Nhercar/adaptation-microduck-replica/replica-repo/assets/cad-solidworks-装配体.png

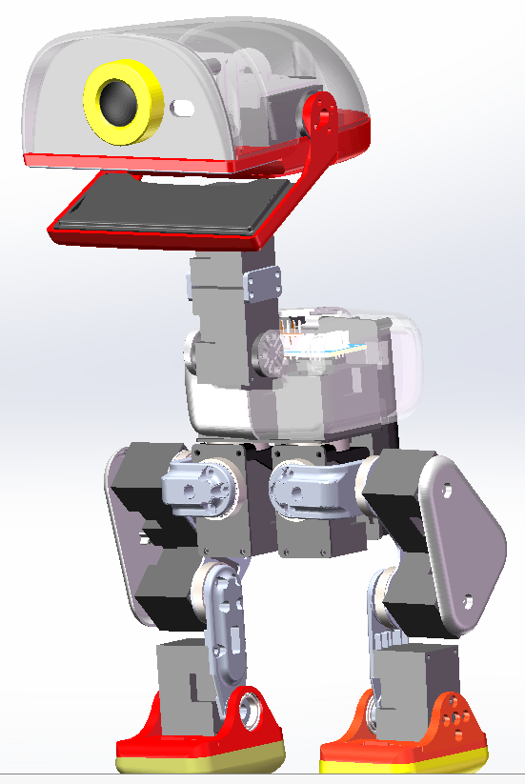
replica-repo/assets/cad-solidworks-装配体.png
