Nhercar/adaptation-microduck-replica/replica-repo/build-log/photos/2026-09-13-飞特版装机-手持.jpg

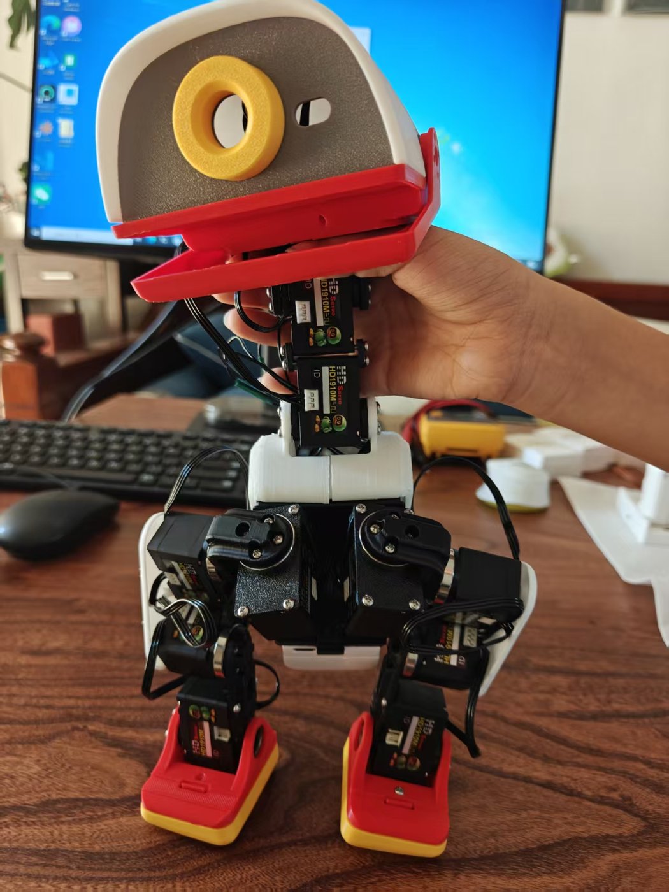
replica-repo/build-log/photos/2026-09-13-飞特版装机-手持.jpg
