Nhercar/adaptation-microduck-replica/replica-repo/assets/hw/Microduck硬件图集.pdf

M I C R O D U C K 复刻 · 电控

# Microduck硬件图集

五个模块、两块自制板、一条总线。所有引脚、地址与寄存器均取自官方开源硬

件工程与运行时源码，未经实物验证。

舵机总线 · 半双工 TTL 1 Mbps | +BATT 6.6–8.2 V | +5V / +3V3 | I²C · 400 kHz | MIPI CSI | I²S 音频

总线设备

16

15 舵机 ＋ 1 块 IMU 板

控制周期

20 ms

50 Hz，一读一写

自制板

2

HAT 已开源 ／ IMU 板要自绘

策略网络

775 KiB

×9 个 ONNX

## 01 东西装在哪

最容易搞错的一条：主控不在躯干，在头里。摄像头、主控板、HAT 三者同属 MJCF 里 的 jaw_soft 刚体，摄像头距主控板中心约 13 mm，中间没有任何关节。 躯干内腔基

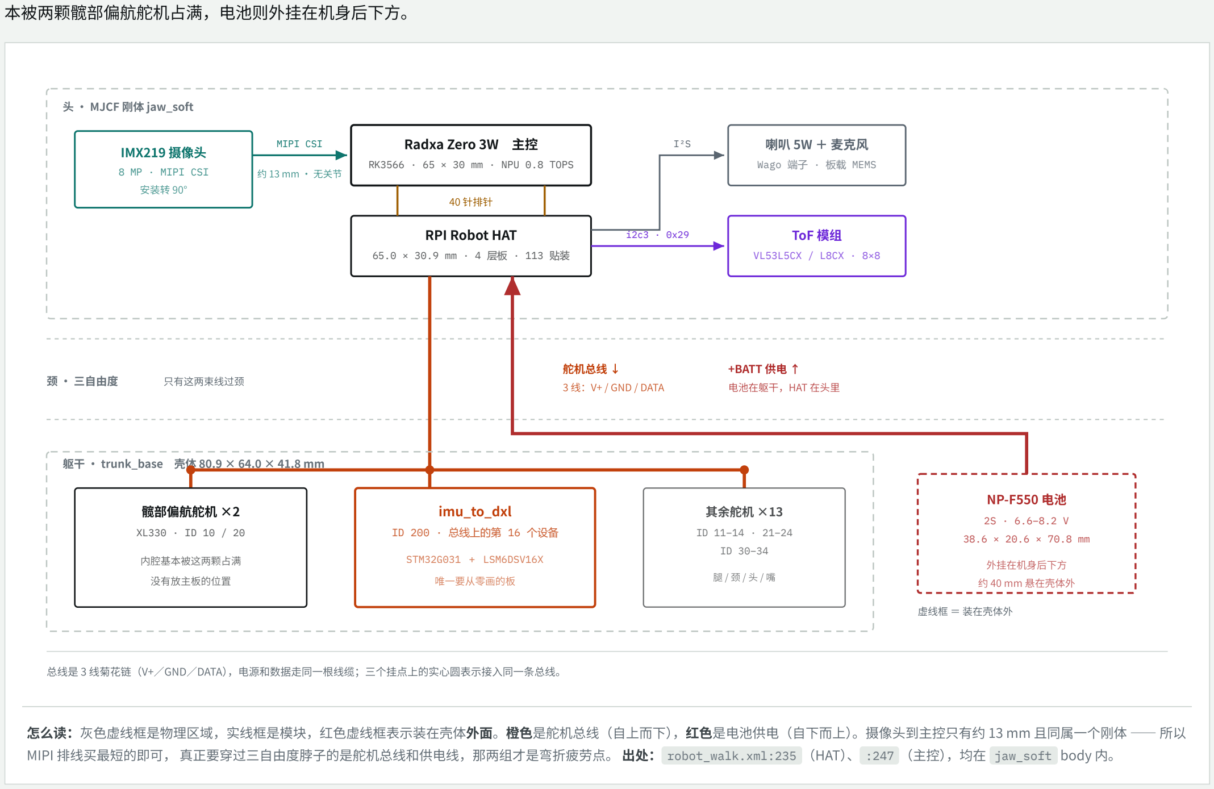
[picture p3: figure]
本被两颗髋部偏航舵机占满，电池则外挂在机身后下方。; 头 · MJCF 刚体 jaw_soft; IMX219 摄像头 8 MP · MIPI CSI; 安装转 90°; Radxa Zero 3W 主控; RK3566 · 65 × 30 mm · NPU 0.8 TOPS; RPI Robot HAT; 40 针排针; MIPI CSI; 约 13 mm · 无关节; ToF 模组; 喇叭 5W ＋ 麦克风; Wago 端子 · 板载 MEMS; I²S; 颈 · 三自由度; 舵机总线 ↓; 3 线：V+ / GND / DATA; +BATT 供电 ↑; 电池在躯干，HAT 在头里; 只有这两束线过颈; 髋部偏航舵机 ×2; 内腔基本被这两颗占满; 没有放主板的位置; imu_to_dxl; ID 200 · 总线上的第 16 个设备; STM32G031 ＋ LSM6DSV16X; 唯一要从零画的板; 其余舵机 ×13; 外挂在机身后下方; 约 40 mm 悬在壳体外; 虚线框 ＝ 装在壳体外; 总线是 3 线菊花链（V+／GND／DATA），电源和数据走同一根线缆；三个挂点上的实心圆表示接入同一条总线。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

躯干 · trunk_base 壳体 80.9 × 64.0 × 41.8 mm

MIPI 排线买最短的即可， 真正要穿过三自由度脖子的是舵机总线和供电线，那两组才是弯折疲劳点。 出处： robot_walk.xml:235 （HAT）、 :247 （主控），均在 jaw_soft body 内。

买之前先看这条

因为主控在头里、槽位只有 65 × 30 mm，任何更大的板子都塞不进去—— 立创泰

山派是 70 × 45 mm，同为 RK3566 但装不下，上面还压着一块 HAT。

## 02 电池两路走，舵机吃原压

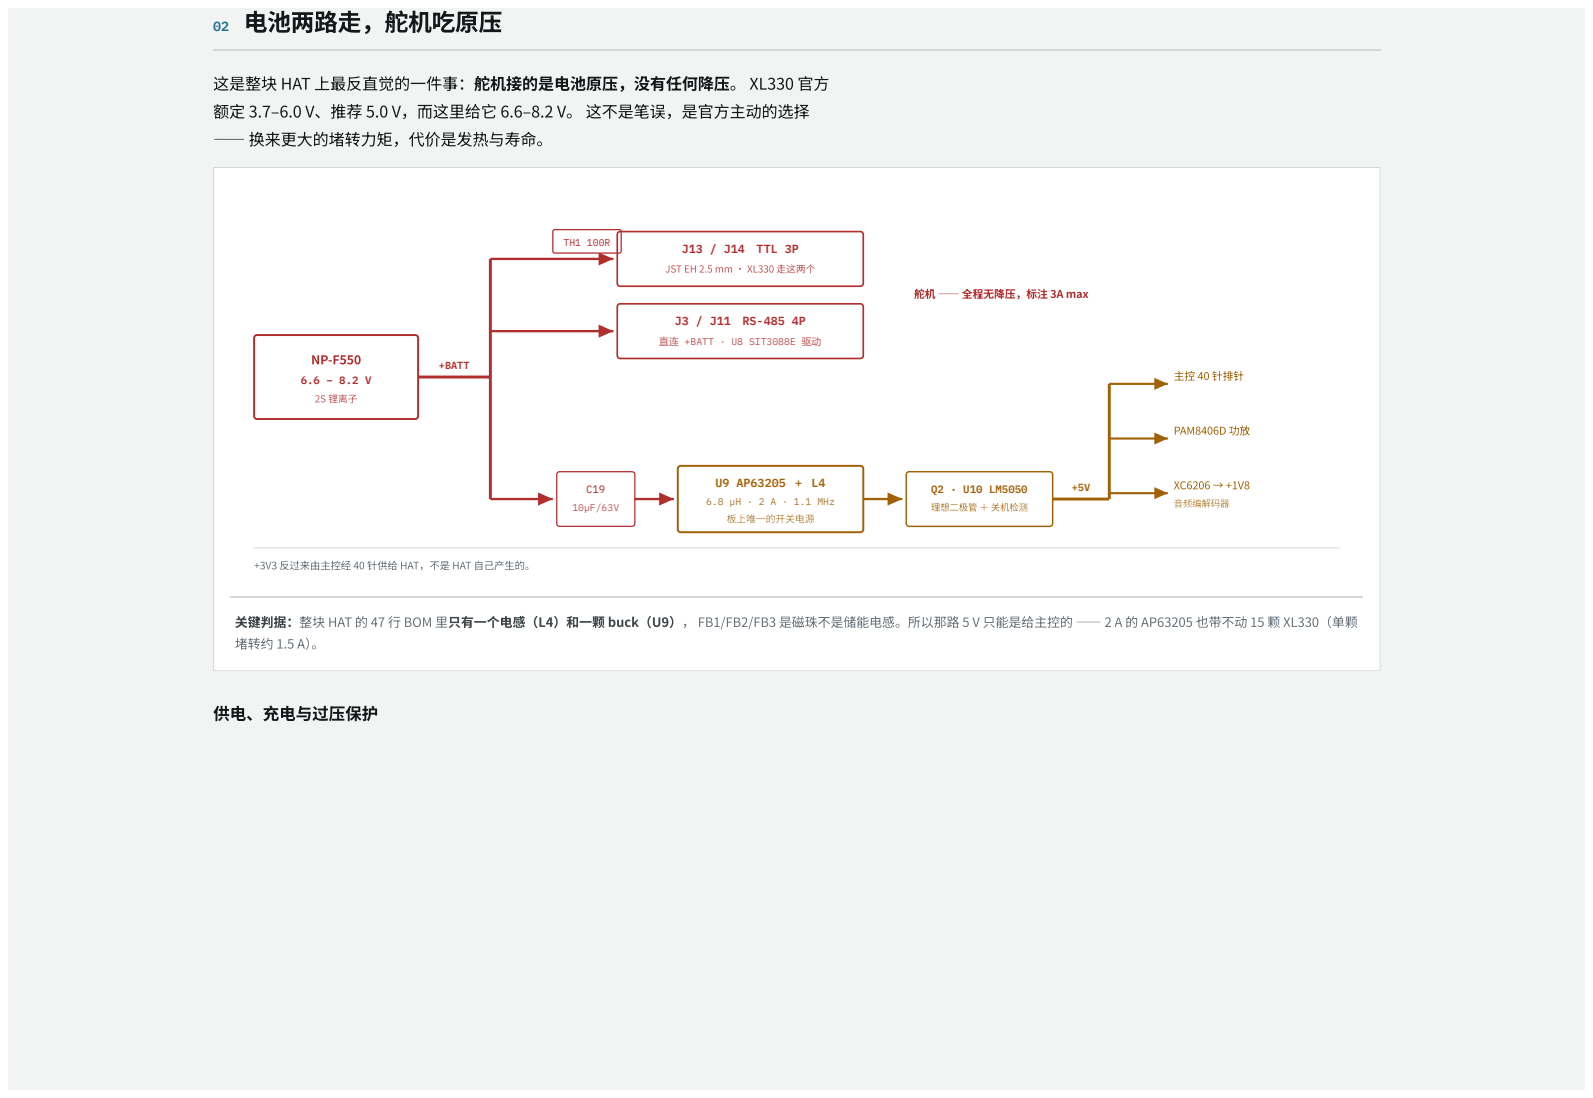
[picture p4: page 3]

这是整块 HAT 上最反直觉的一件事：舵机接的是电池原压，没有任何降压。 XL330 官方
额定 3.7–6.0 V、推荐 5.0 V，而这里给它 6.6–8.2 V。 这不是笔误，是官方主动的选择
—— 换来更大的堵转力矩，代价是发热与寿命。

JST EH 2.5 mm · XL330 走这两个

舵机——全程无降压，标注 3A max

+3V3 反过来由主控经 40 针供给 HAT，不是 HAT 自己产生的。

关键判据：整块 HAT 的 47 行 BOM 里只有一个电感（L4）和一颗 buck（U9）， FB1/FB2/FB3 是磁珠不是储能电感。所以那路 5 V 只能是给主控的—— 2 A 的 AP63205 也带不动 15 颗 XL330（单颗
堵转约 1.5 A）。

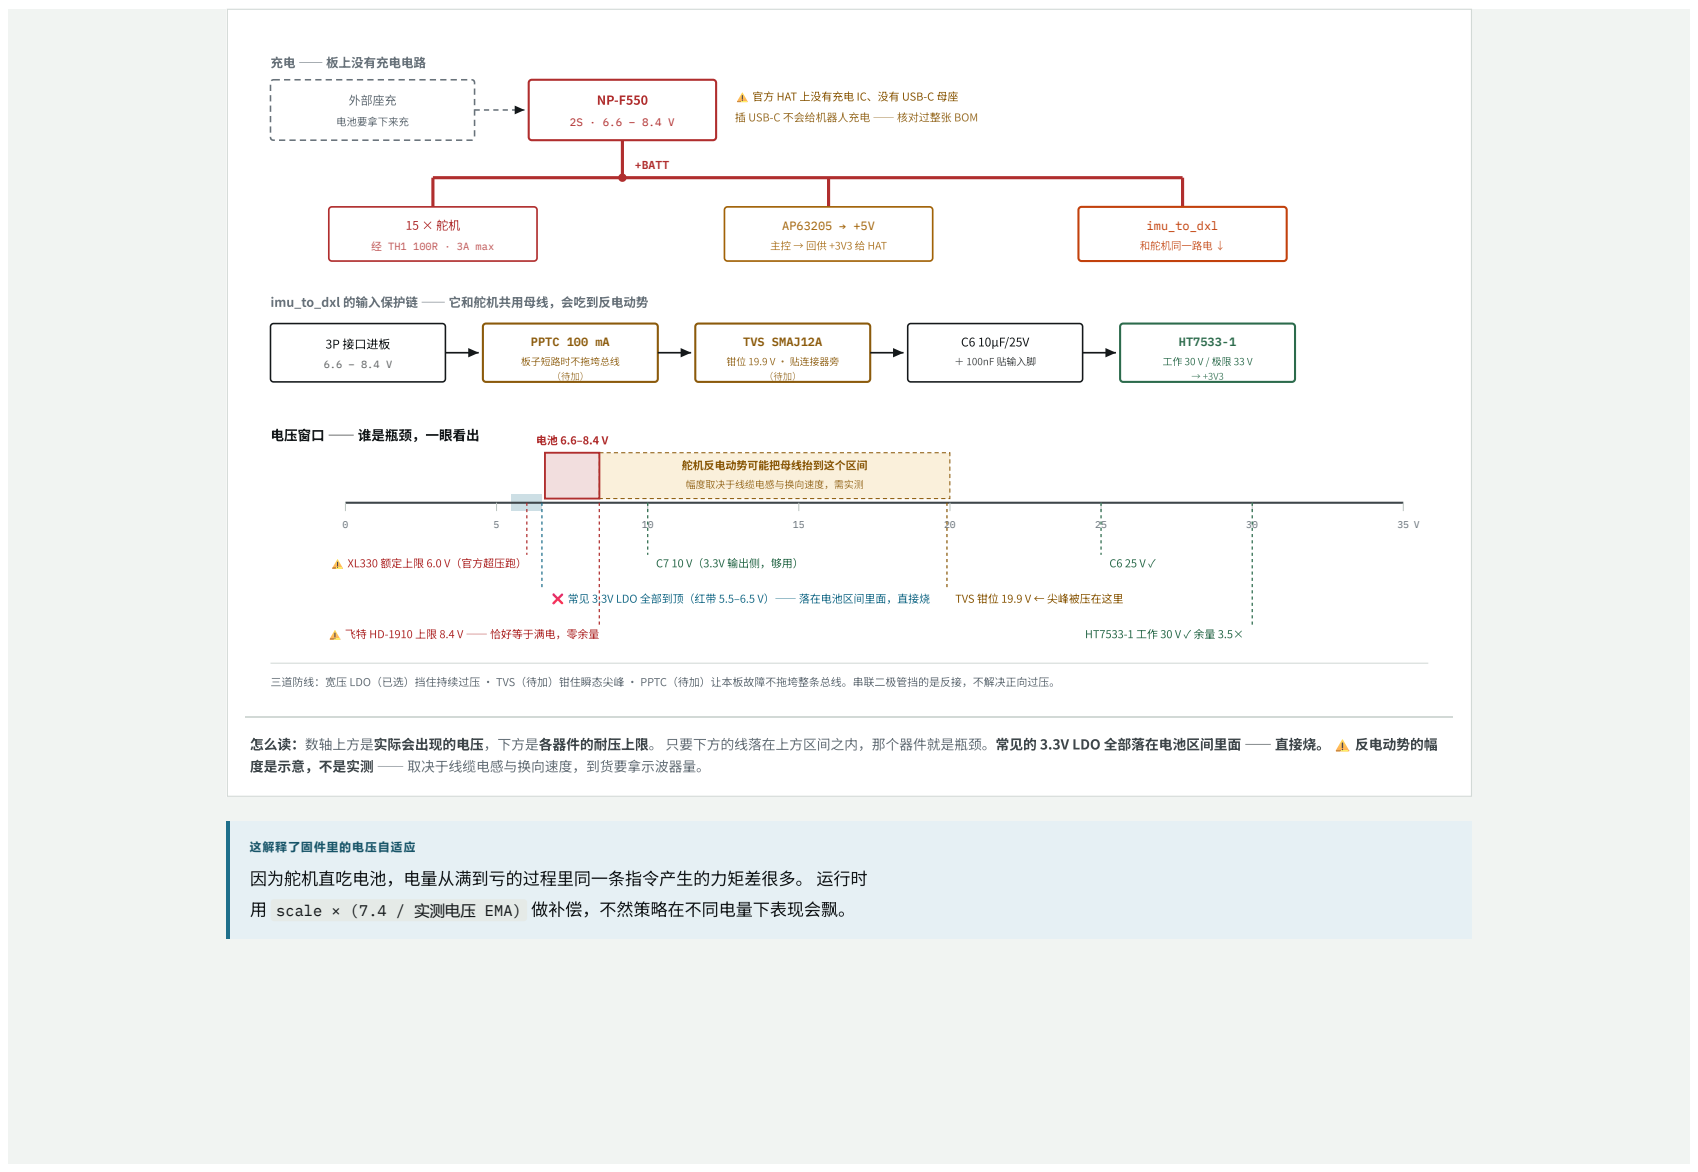
[picture p5: page 4]
充电——板上没有充电电路; 外部座充; 电池要拿下来充; +BATT; 15 × 舵机 经 TH1 100R · 3A max; imu_to_dxl; 和舵机同一路电 ↓; 3P 接口进板 6.6 – 8.4 V; PPTC 100 mA; 板子短路时不拖垮总线; TVS SMAJ12A; 钳位 19.9 V · 贴连接器旁; ＋ 100nF 贴输入脚; 舵机反电动势可能把母线抬到这个区间; 幅度取决于线缆电感与换向速度，需实测; ⚠️XL330 额定上限 6.0 V（官方超压跑）; C7 10 V（3.3V 输出侧，够用）; 这解释了固件里的电压自适应

⚠️官方 HAT 上没有充电 IC、没有 USB-C 母座
插 USB-C 不会给机器人充电—— 核对过整张 BOM

主控 → 回供 +3V3 给 HAT

imu_to_dxl 的输入保护链——它和舵机共用母线，会吃到反电动势

电压窗口——谁是瓶颈，一眼看出

❌常见 3.3V LDO 全部到顶（红带 5.5–6.5 V）—— 落在电池区间里面，直接烧

TVS 钳位 19.9 V ← 尖峰被压在这里

⚠️飞特 HD-1910 上限 8.4 V—— 恰好等于满电，零余量

三道防线：宽压 LDO（已选）挡住持续过压 · TVS（待加）钳住瞬态尖峰 · PPTC（待加）让本板故障不拖垮整条总线。串联二极管挡的是反接，不解决正向过压。

怎么读：数轴上方是实际会出现的电压，下方是各器件的耐压上限。 只要下方的线落在上方区间之内，那个器件就是瓶颈。常见的 3.3V LDO 全部落在电池区间里面—— 直接烧。⚠️反电动势的幅
度是示意，不是实测—— 取决于线缆电感与换向速度，到货要拿示波器量。

因为舵机直吃电池，电量从满到亏的过程里同一条指令产生的力矩差很多。 运行时
用 scale × (7.4 / 实测电压 EMA) 做补偿，不然策略在不同电量下表现会飘。

## 03 一条总线挂 16 个设备

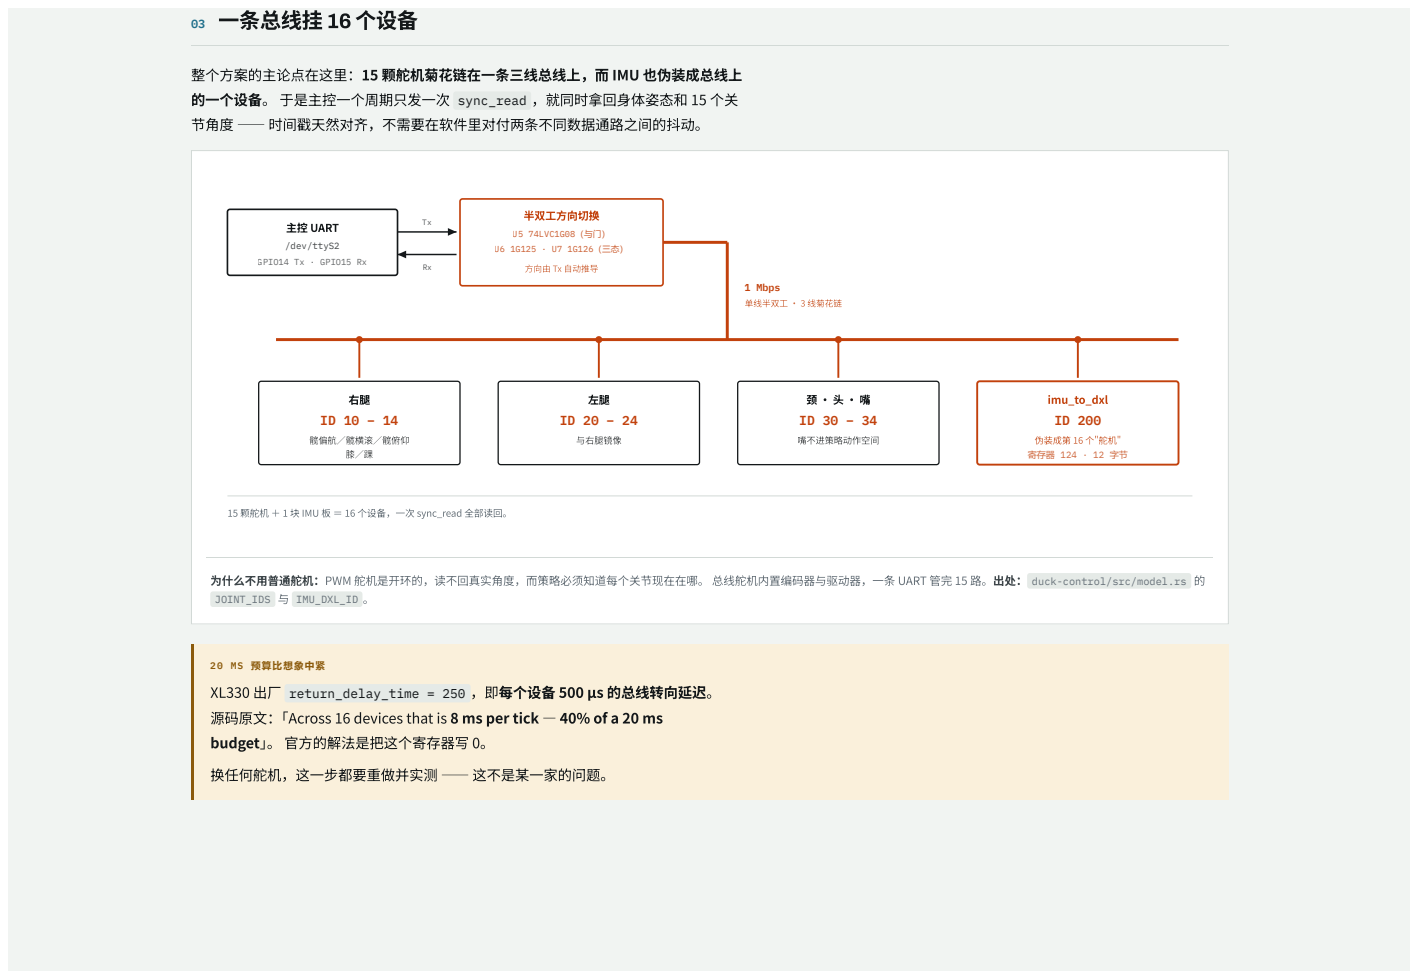
[picture p6: page 5]
主控 UART; /dev/ttyS2 GPIO14 Tx · GPIO15 Rx; 半双工方向切换; U5 74LVC1G08（与门） U6 1G125 · U7 1G126（三态）; 1 Mbps; 单线半双工 · 3 线菊花链; 与右腿镜像; 嘴不进策略动作空间; imu_to_dxl ID 200; 伪装成第 16 个"舵机" 寄存器 124 · 12 字节

整个方案的主论点在这里：15 颗舵机菊花链在一条三线总线上，而 IMU 也伪装成总线上
的一个设备。 于是主控一个周期只发一次 sync_read ，就同时拿回身体姿态和 15 个关

节角度—— 时间戳天然对齐，不需要在软件里对付两条不同数据通路之间的抖动。

方向由 Tx 自动推导

髋偏航／髋横滚／髋俯仰

15 颗舵机 ＋ 1 块 IMU 板 ＝ 16 个设备，一次 sync_read 全部读回。

为什么不用普通舵机：PWM 舵机是开环的，读不回真实角度，而策略必须知道每个关节现在在哪。 总线舵机内置编码器与驱动器，一条 UART 管完 15 路。出处： duck-control/src/model.rs 的
JOINT_IDS 与 IMU_DXL_ID 。

20 MS 预算比想象中紧
XL330 出厂 return_delay_time = 250 ，即每个设备 500 µs 的总线转向延迟。
源码原文：「Across 16 devices that is 8 ms per tick — 40% of a 20 ms
budget」。 官方的解法是把这个寄存器写 0。

换任何舵机，这一步都要重做并实测—— 这不是某一家的问题。

## 04 一个周期，20 毫秒

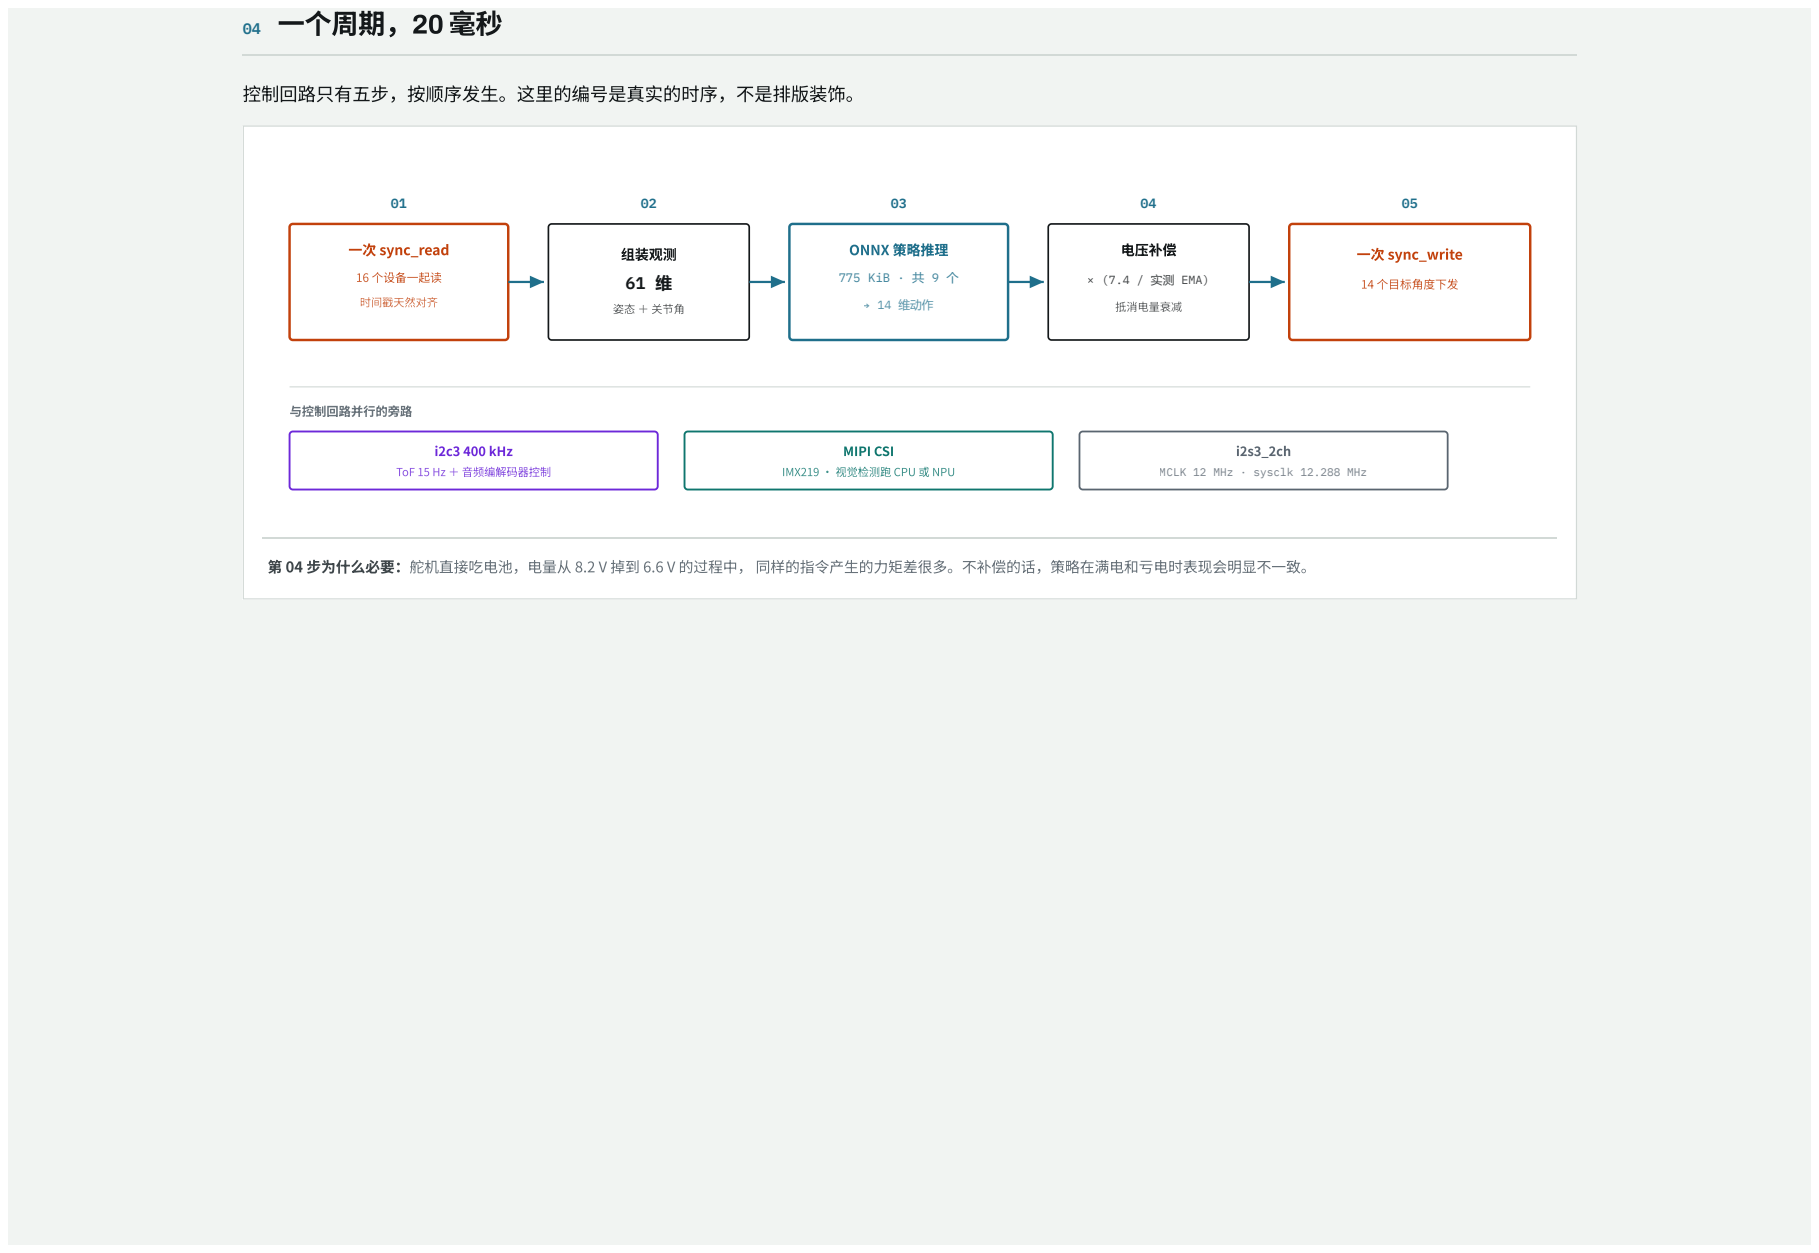
[picture p7: page 6]
一次 sync_read; 16 个设备一起读; 时间戳天然对齐; 组装观测 61 维; 姿态 ＋ 关节角; ONNX 策略推理; 775 KiB · 共 9 个; → 14 维动作; 电压补偿; × (7.4 / 实测 EMA); 抵消电量衰减; 一次 sync_write; 14 个目标角度下发; 与控制回路并行的旁路; i2c3 400 kHz; MIPI CSI

控制回路只有五步，按顺序发生。这里的编号是真实的时序，不是排版装饰。

ToF 15 Hz ＋ 音频编解码器控制

IMX219 · 视觉检测跑 CPU 或 NPU

MCLK 12 MHz · sysclk 12.288 MHz

第 04 步为什么必要：舵机直接吃电池，电量从 8.2 V 掉到 6.6 V 的过程中， 同样的指令产生的力矩差很多。不补偿的话，策略在满电和亏电时表现会明显不一致。

## 05 要自己画的那块板

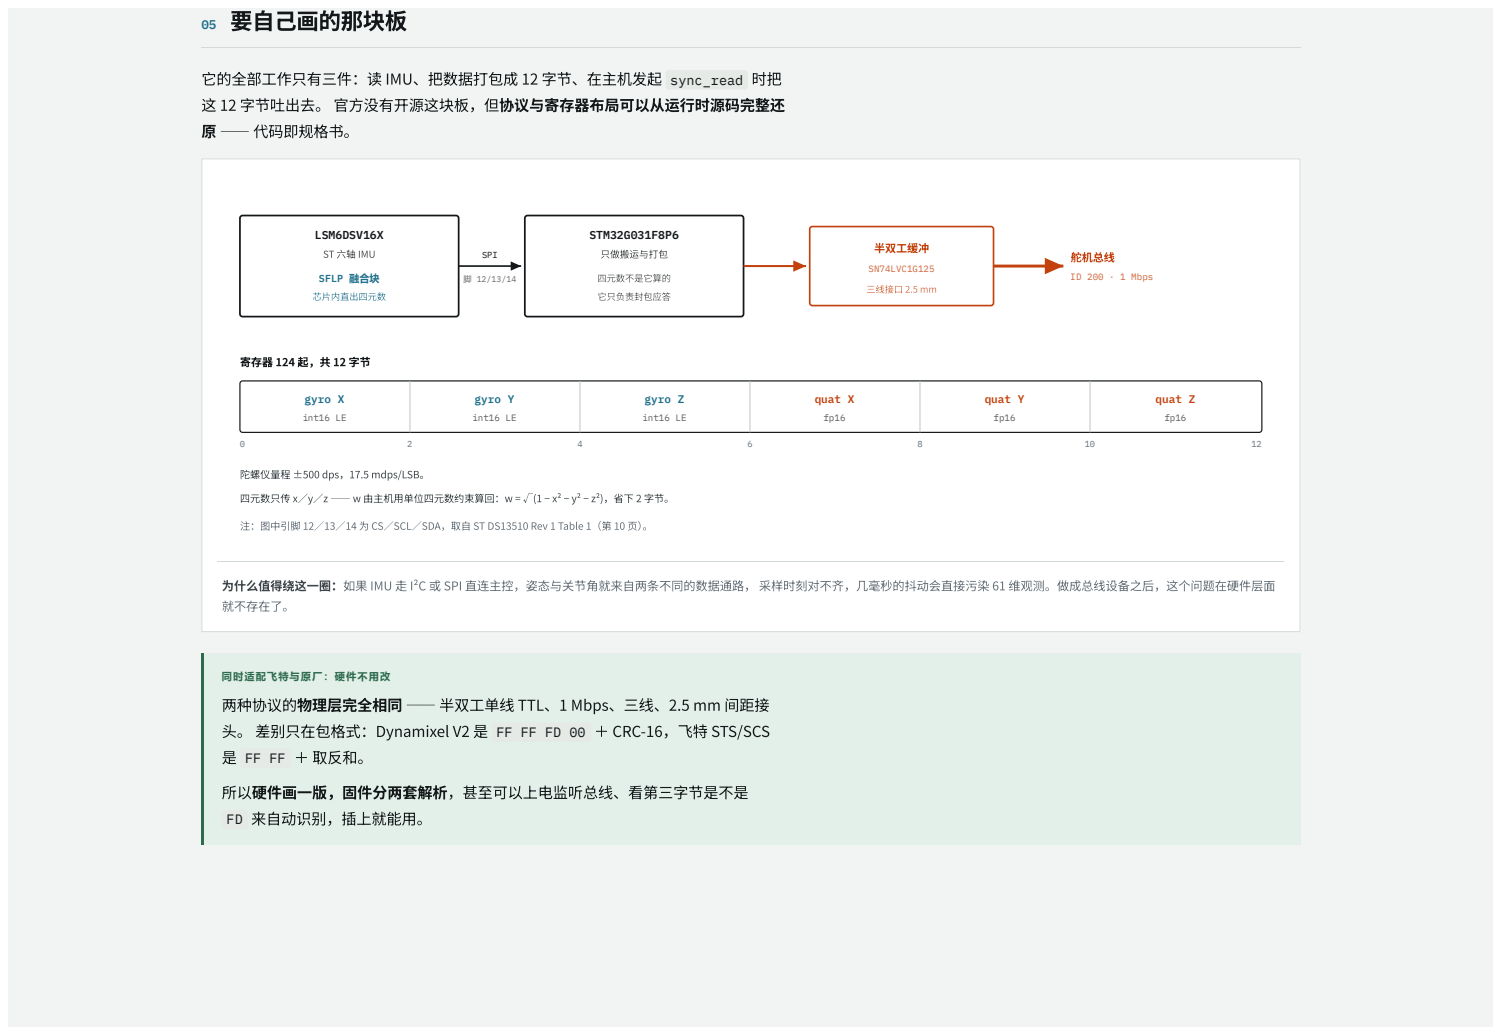
[picture p8: page 7]
LSM6DSV16X; 芯片内直出四元数; SPI; STM32G031F8P6; 只做搬运与打包; 四元数不是它算的; 它只负责封包应答; 半双工缓冲; SN74LVC1G125; 三线接口 2.5 mm; 舵机总线; ID 200 · 1 Mbps; 寄存器 124 起，共 12 字节; gyro X; gyro Y; gyro Z; quat X; quat Y; quat Z; int16 LE; 同时适配飞特与原厂：硬件不用改

它的全部工作只有三件：读 IMU、把数据打包成 12 字节、在主机发起 sync_read 时把
这 12 字节吐出去。 官方没有开源这块板，但协议与寄存器布局可以从运行时源码完整还
原—— 代码即规格书。

ST 六轴 IMU
SFLP 融合块

陀螺仪量程 ±500 dps，17.5 mdps/LSB。

四元数只传 x／y／z——w 由主机用单位四元数约束算回：w = √(1 − x² − y² − z²)，省下 2 字节。

注：图中引脚 12／13／14 为 CS／SCL／SDA，取自 ST DS13510 Rev 1 Table 1（第 10 页）。

为什么值得绕这一圈：如果 IMU 走 I²C 或 SPI 直连主控，姿态与关节角就来自两条不同的数据通路， 采样时刻对不齐，几毫秒的抖动会直接污染 61 维观测。做成总线设备之后，这个问题在硬件层面
就不存在了。

两种协议的物理层完全相同—— 半双工单线 TTL、1 Mbps、三线、2.5 mm 间距接
头。 差别只在包格式：Dynamixel V2 是 FF FF FD 00 ＋ CRC-16，飞特 STS/SCS
是 FF FF ＋ 取反和。

所以硬件画一版，固件分两套解析，甚至可以上电监听总线、看第三字节是不是
FD 来自动识别，插上就能用。

## 06 40 针占用与关键地址

引脚 / 总线 | 用途 | LINUX 设备 | 出处
GPIO14 / GPIO15 | 舵机总线 Tx / Rx | /dev/ttyS2 @ 1 Mbps | robotd.toml
GPIO02 / GPIO03 | I²C—— IMU、音频编解码器、Stemma | i2c3 @ 400 kHz | i2c3-pihat.dts
GPIO18 / 19 / 20 / 21 | 音频 PCM 时钟 / 帧同步 / 输入 / 输出 | i2s3_2ch | aic3104-i2c3.dts
GPIO06 | 关机检测 | — | HAT 原理图
GPIO22 | HAT 上 BMI088 的中断脚—— 软件不用 | — | i2c3-pihat.dts
MIPI CSI | IMX219 摄像头，安装转 90° | radxa-zero3-rpi-camera-v2 | setup-board.sh
i2c3 · 0x18 | 音频编解码器 TLV320AIC3104 | — | i2c3-pihat.dts
i2c3 · 0x29 / 0x52 | ToF，两个地址都试 | — | tof/src/main.rs
i2c3 · 0x19 / 0x68 | BMI088—— 贴了片但软件标注 dormant | — | i2c3-pihat.dts
总线 ID 200 | imu_to_dxl，寄存器 124，长 12 字节 | — | duck-control/model.rs

这张表就是核对清单

Microduck 的软件是开源的，硬件上每一个地址都能在代码里找到对应。 对不上，

就是有一边错了—— 这是复刻时最省事的验证手段。

### 07 两条路线：原厂 XL330 与飞特 STS

「把 IMU 做成总线上的第 16 个设备」这个架构，在飞特上同样成立—— 因为飞特 STS/SCS 有自己的批量读指令 SYNC READ （ 0x82 ）， 用法与 Dynamixel 完全一致。

而且两边的应答机制是一样的。Protocol V2 确实有个能把所有应答拼成一个包的 fast sync read （ 0x8A ），但官方运行时没有用它—— 全库检索 fast_sync_read / 0x8A 零命中， duck-control/src/bus.rs:236 调的是普通的

sync_read_raw_data 。 这也和源码里「500 µs per device × 16 devices ＝ 8 ms」自

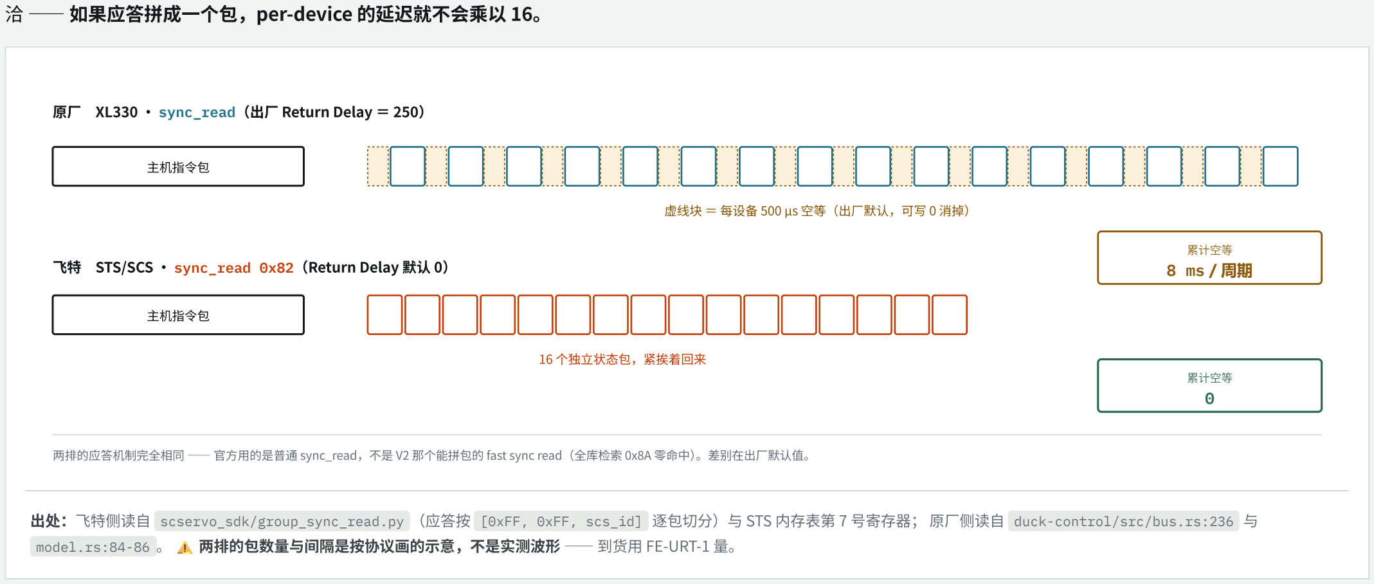
[picture p9: figure]
洽—— 如果应答拼成一个包，per-device 的延迟就不会乘以 16。; 主机指令包; 虚线块 ＝ 每设备 500 µs 空等（出厂默认，可写 0 消掉）; 累计空等; 累计空等 0; 16 个独立状态包，紧挨着回来; model.rs:84-86 。⚠️两排的包数量与间隔是按协议画的示意，不是实测波形—— 到货用 FE-URT-1 量。

原厂 XL330 · sync_read（出厂 Return Delay ＝ 250）

飞特 STS/SCS · sync_read 0x82（Return Delay 默认 0） | 8 ms／周期

两排的应答机制完全相同—— 官方用的是普通 sync_read，不是 V2 那个能拼包的 fast sync read（全库检索 0x8A 零命中）。差别在出厂默认值。

出处：飞特侧读自 scservo_sdk/group_sync_read.py （应答按 [0xFF, 0xFF, scs_id] 逐包切分）与 STS 内存表第 7 号寄存器； 原厂侧读自 duck-control/src/bus.rs:236 与

意外发现：起点其实是飞特占优

STS 内存表第 7 (0x07) 号寄存器 Return Delay Time：默认值 0， 且备注写着

"Not functional on STS"。

而 XL330 出厂是 250 ，即 500 µs／设备—— 官方源码原文： 「Across 16

devices that is 8 ms per tick — 40% of a 20 ms budget」， 必须手动写 0 才能消

掉。

既然两边的应答机制相同，这就成了出厂状态下唯一的实质差别—— 而且是飞特占

优。 当然 XL330 那边写个 0 就抹平了，所以这不是「飞特更快」，是「飞特少一个

坑」。

协议差异一览

项 | DYNAMIXEL V2 · XL330 | 飞特 STS/SCS
物理层 | 完全相同—— 半双工单线 TTL、3 线（V+／GND／DATA）、1 Mbps
接头间距 | JST EH 2.5 mm | 5264，同为 2.5 mm
包头 | FF FF FD 00 | FF FF
校验 | CRC-16 | ~sum（取反和）
批量读 | sync read（官方实际用的） 另有 fast sync read 0x8A，未被使用 | sync read 0x82
应答方式 | 相同—— 每设备一个独立状态包
总线转向／周期 | 17 ⚠️ | 17 ⚠️

⚠️转向次数是协议推论（1 条指令 ＋ 16 个应答），非实测

出厂应答延时 | 250 ＝ 500 µs／设备，须写 0 | 默认 0，且 STS 上不起作用
ID 范围 | 0 – 252 | 0 – 253（寄存器 5）
波特率设定 | 寄存器 baud_rate = 3 | 寄存器 6， 0 = 1M

飞特侧还有一个可优化的寄存器

STS 内存表第 8 (0x08) 号 Response Level，默认 1—— 「所有命令都应答」。

改成 0 之后只有 read 与 ping 才回包， 普通写指令不再占用总线时间。

这与官方对 XL330 把 return_delay_time 写 0 是同一类动作： 出厂默认值是给

通用场景的，高频控制回路要自己调。

换成飞特，各模块受什么影响

模块 | 影响 | 说明
主控 | 不变 | 与舵机协议无关
摄像头 / ToF | 不变 | 走各自独立的接口
HAT | 完全不用改 | 飞特与 XL330 物理层完全相同—— 三线半双工 TTL、1 Mbps、2.5 mm 间距接头。HAT 上的 J13／J14 是 TTL 3P 口，直接插飞特舵机即可， 一根线都不用动
imu_to_dxl | 硬件架构不 变 | 物理层相同，所以硬件画一版即可；固件里按包头第三字节是不是 FD 自动识别协议，两套解析分支。连接器统一到 2.5 mm 间距，两边通用
策略 | 大概率要重
| 训

舵机换了意味着力矩曲线与质量都变了，官方九个 ONNX 不能直接套用。这是整条路线上最大的一笔工作量，与协议无关

另一个问题：这块 HAT 到底要不要做

这与用哪家舵机无关，是纯成本判断。HAT 是 4 层板加贴片，打样几百元起且有起

订量， 而板上约一半电路是音频（编解码器、功放、板载麦克风、喇叭端子）。

如果你不做语音功能，那半块板就白打了—— 此时一块二十几元的总线转接板加一

个降压模块， 就顶掉了「舵机总线」和「配电」这两件真正必需的功能，ToF 直接

挂 i2c3。 代价是失去板载音频与 Pi HAT+ 身份识别。

画板子之前先做这件事

上面的转向次数是协议事实，但换算成毫秒是估算。真实数字取决于三态缓冲切换

速度、 包间隙与实际读取的寄存器长度—— 只有拿实物测过才知道。

舵机到货第一件事：接上调试板，用两种读法各跑一遍，量出 16 个设备一轮的实际

耗时。 这个数不出来，板子上的架构决策就是空转。

基于官方公开的 MJCF 模型、STL 网格、开源硬件工程（elec_RPI_Robot_HAT，Apache-2.0） 与运行时源码推导，未经实物验证。图中所有引脚、地址、寄存器与器件位号均可在上述来源中复核。
