Nhercar/adaptation-microduck-replica/cad-repo/assets/B站-机械行者Robo.jpg

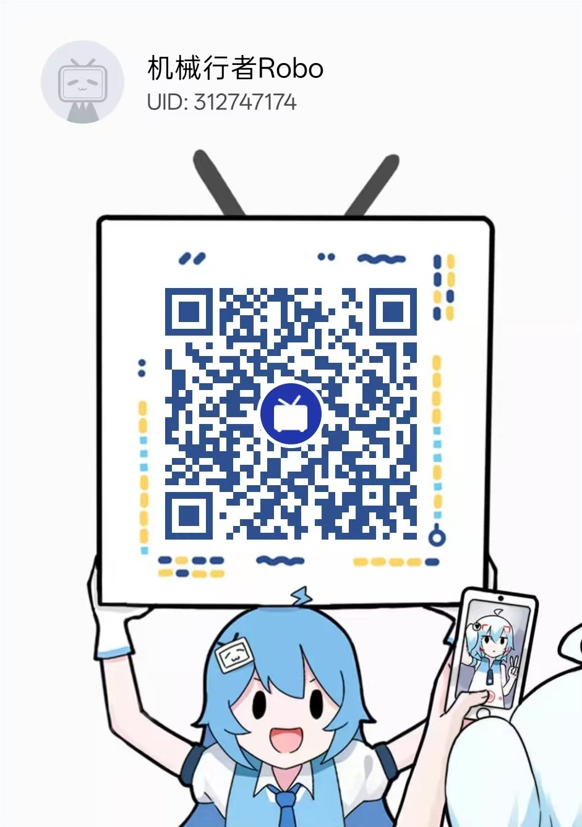
cad-repo/assets/B站-机械行者Robo.jpg
