Nhercar/adaptation-microduck-replica/cad-repo/assets/小红书-机械行者Robo.jpg

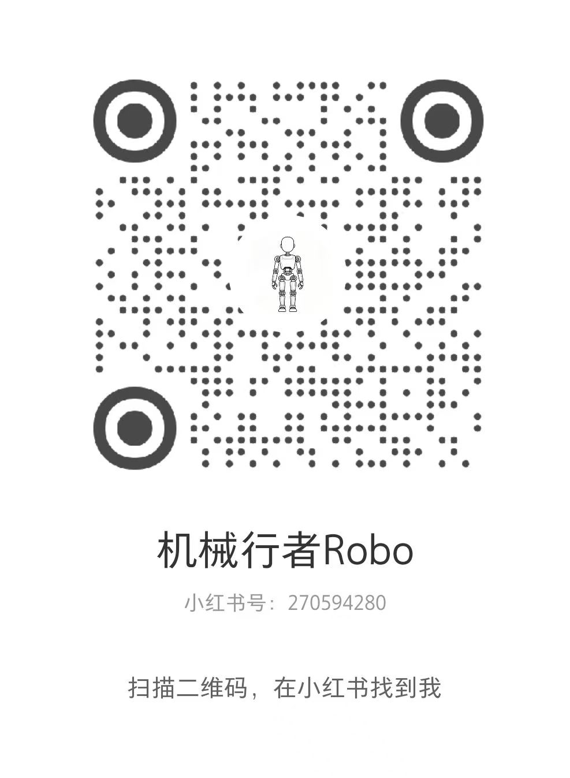
cad-repo/assets/小红书-机械行者Robo.jpg
