Nhercar/adaptation-microduck-replica/cad-repo/assets/抖音-机械行者Robo.jpg

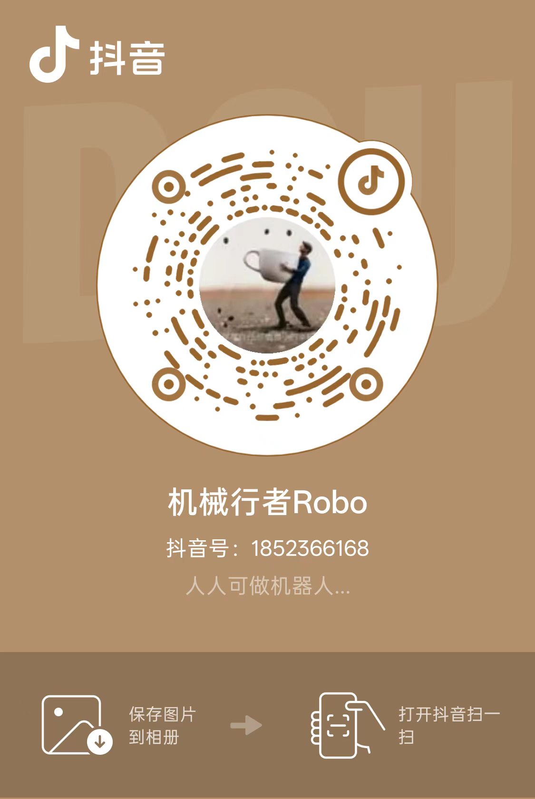
cad-repo/assets/抖音-机械行者Robo.jpg
