Nhercar/adaptation-microduck-replica/cad-repo/组件图/01-躯干主体.png

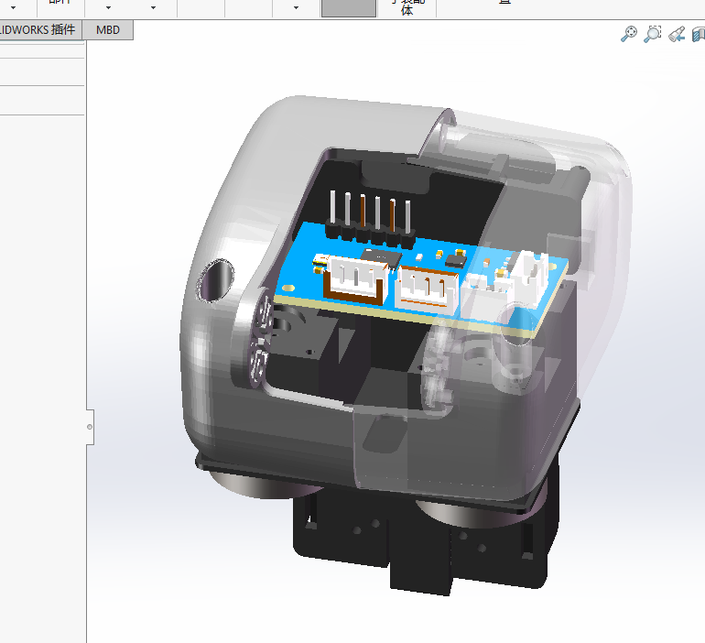
cad-repo/组件图/01-躯干主体.png
