Nhercar/adaptation-microduck-replica/cad-repo/组件图/02-左髋.png

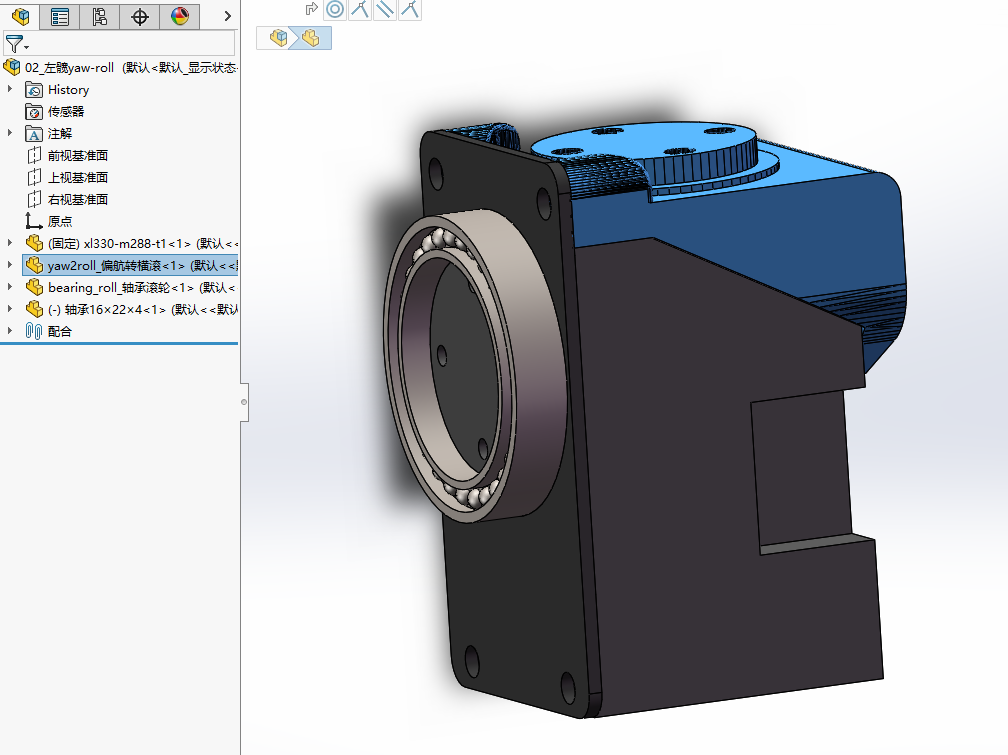
cad-repo/组件图/02-左髋.png
