Nhercar/adaptation-microduck-replica/cad-repo/组件图/03-左髋roll.png

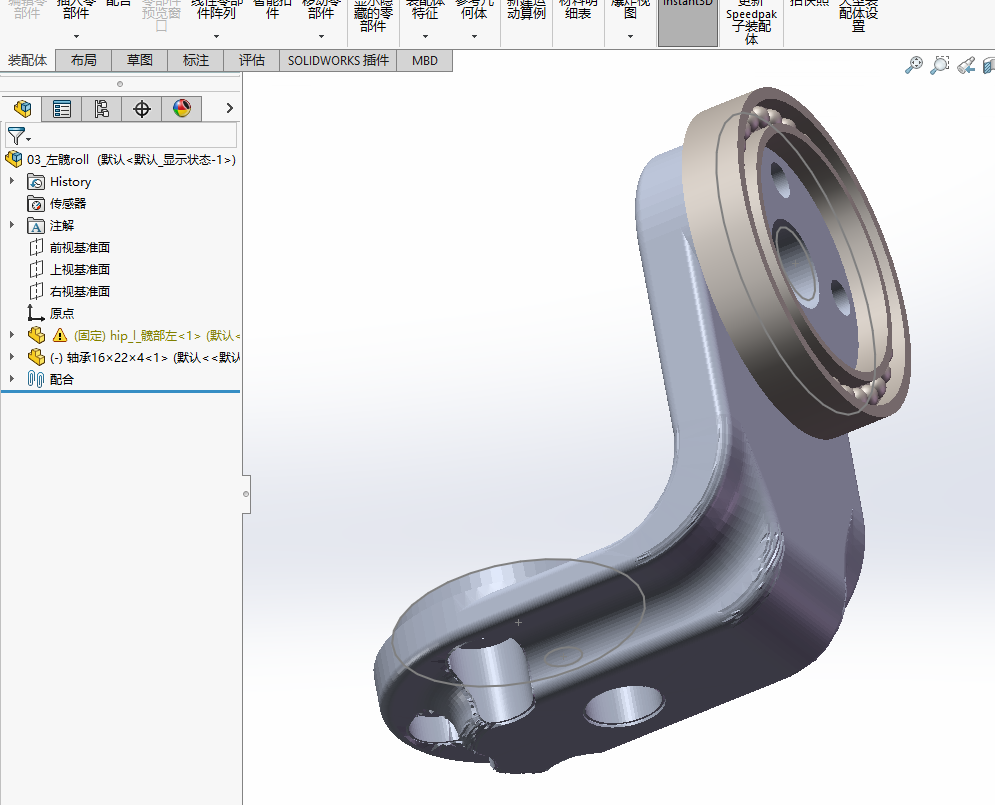
cad-repo/组件图/03-左髋roll.png
