Nhercar/adaptation-microduck-replica/cad-repo/组件图/04-左大腿.png

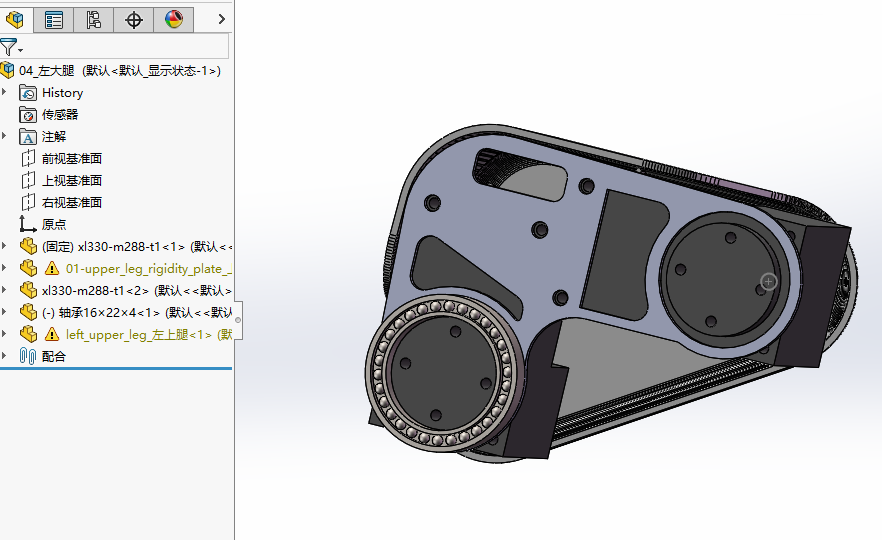
cad-repo/组件图/04-左大腿.png
