Nhercar/adaptation-microduck-replica/cad-repo/组件图/05-左小腿.png

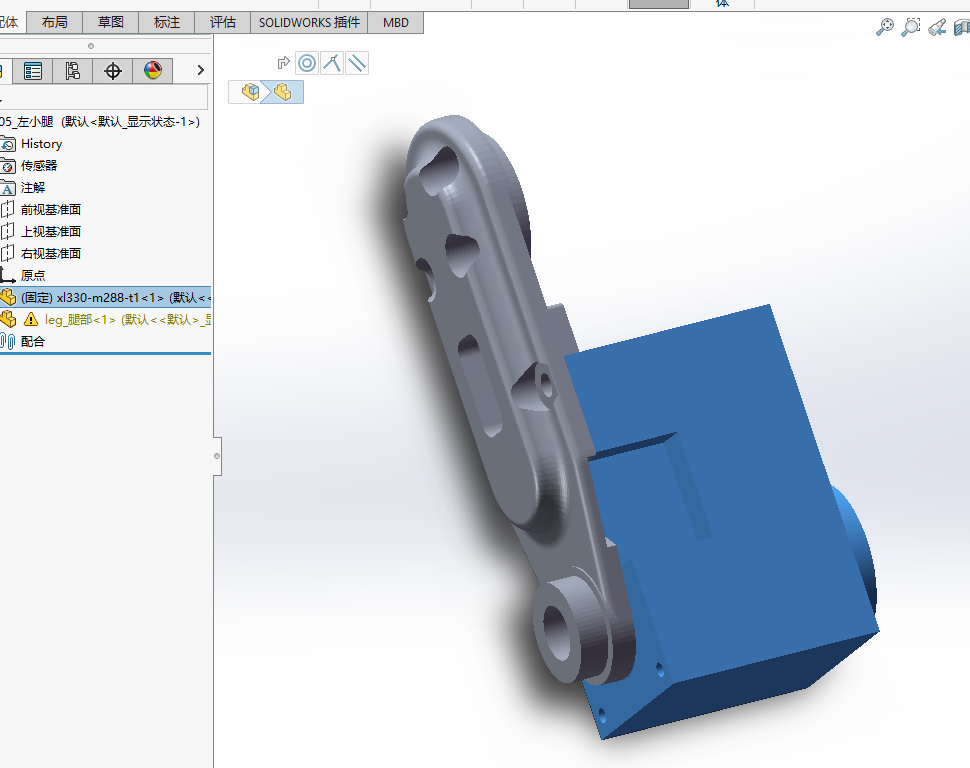
cad-repo/组件图/05-左小腿.png
