Nhercar/adaptation-microduck-replica/cad-repo/组件图/06-左踝脚.png

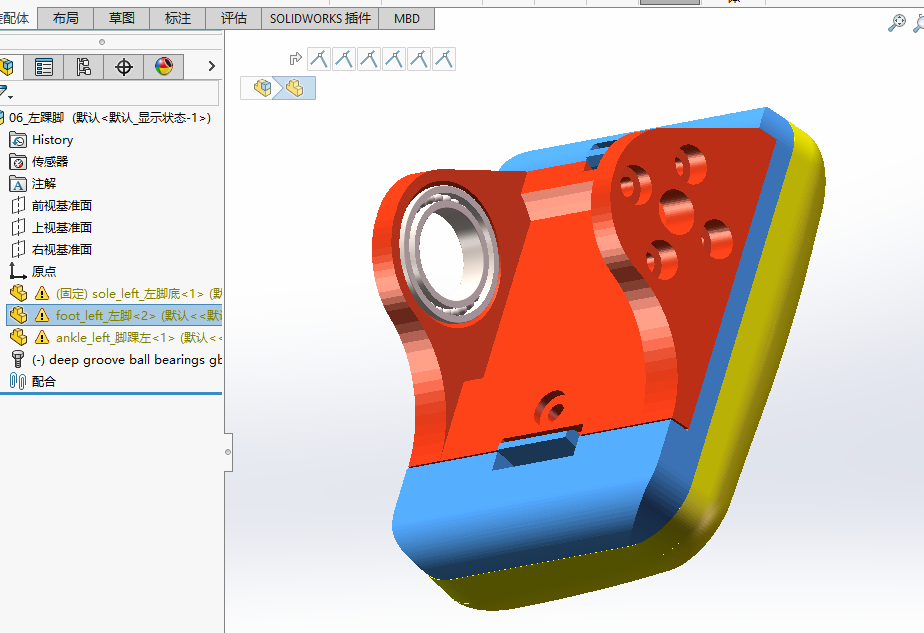
cad-repo/组件图/06-左踝脚.png
