Nhercar/adaptation-microduck-replica/cad-repo/组件图/07-颈根.png

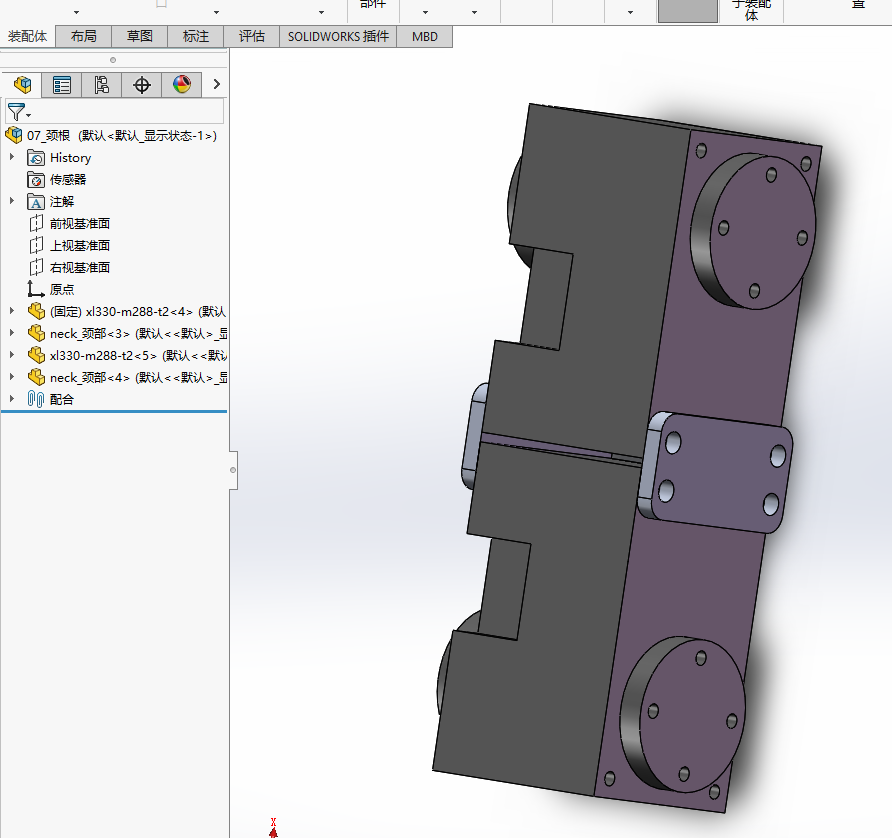
cad-repo/组件图/07-颈根.png
