Nhercar/adaptation-microduck-replica/cad-repo/组件图/08-颈俯仰.png

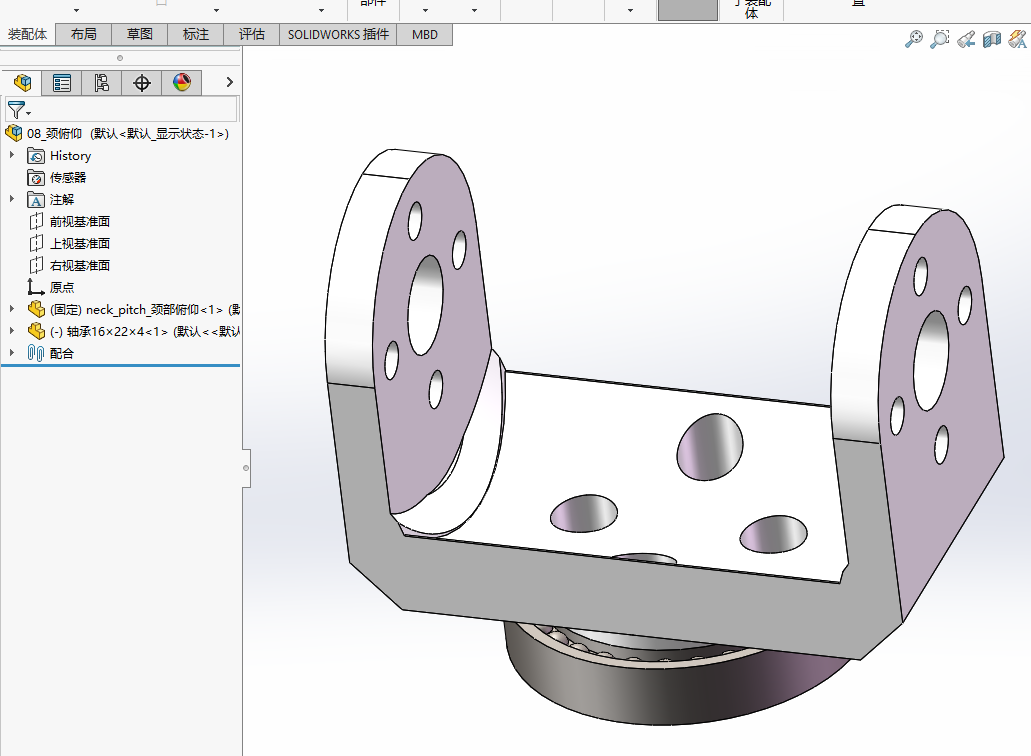
cad-repo/组件图/08-颈俯仰.png
