Nhercar/adaptation-microduck-replica/cad-repo/组件图/09-头yawroll.png

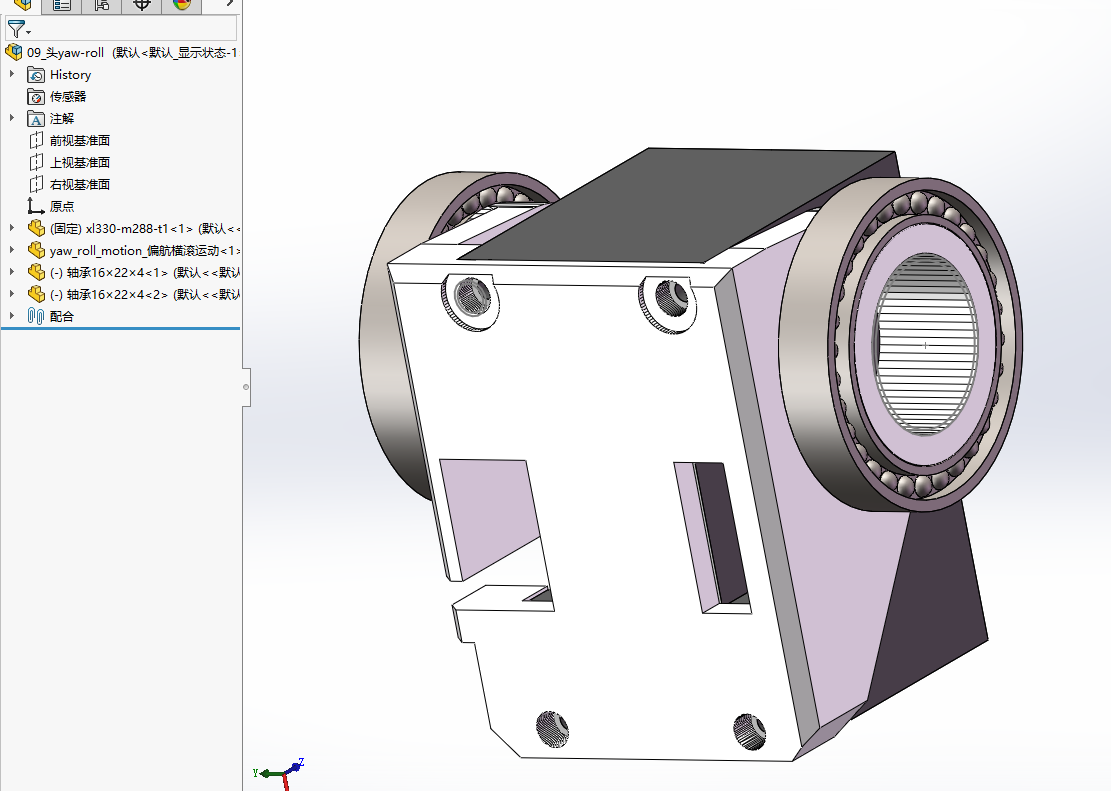
cad-repo/组件图/09-头yawroll.png
