Nhercar/adaptation-microduck-replica/cad-repo/组件图/10-头部总成爆炸2.png

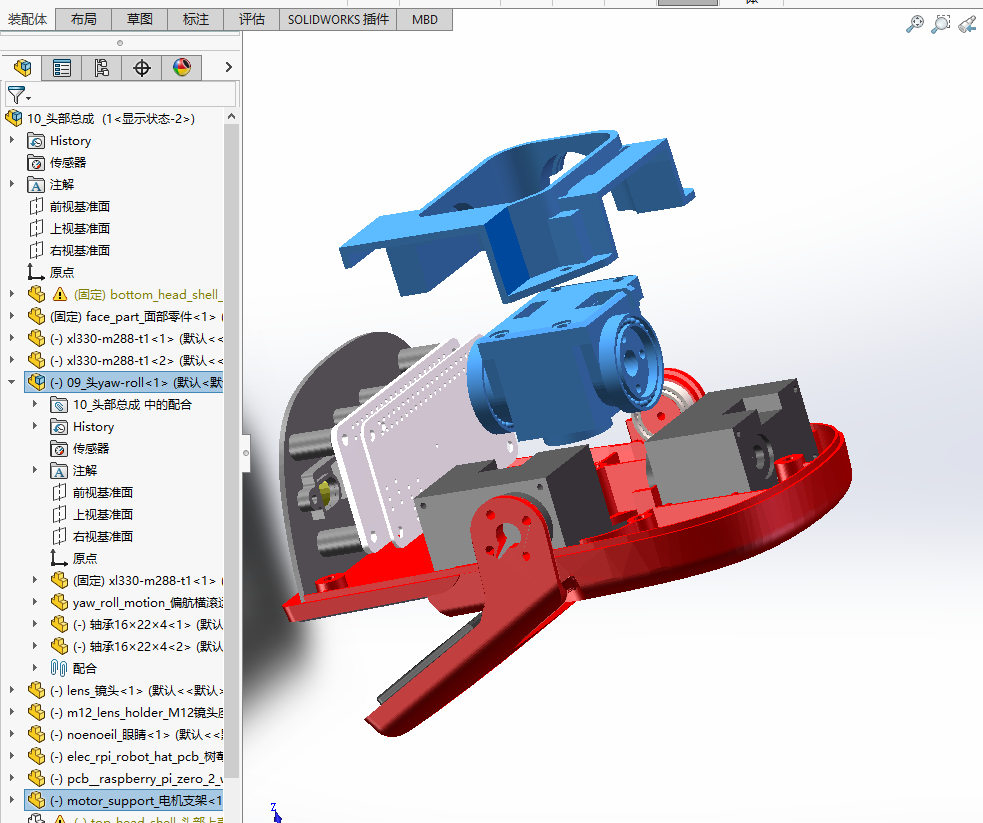
cad-repo/组件图/10-头部总成爆炸2.png
