Nhercar/adaptation-microduck-replica/cad-repo/组件图/11-右髋.png

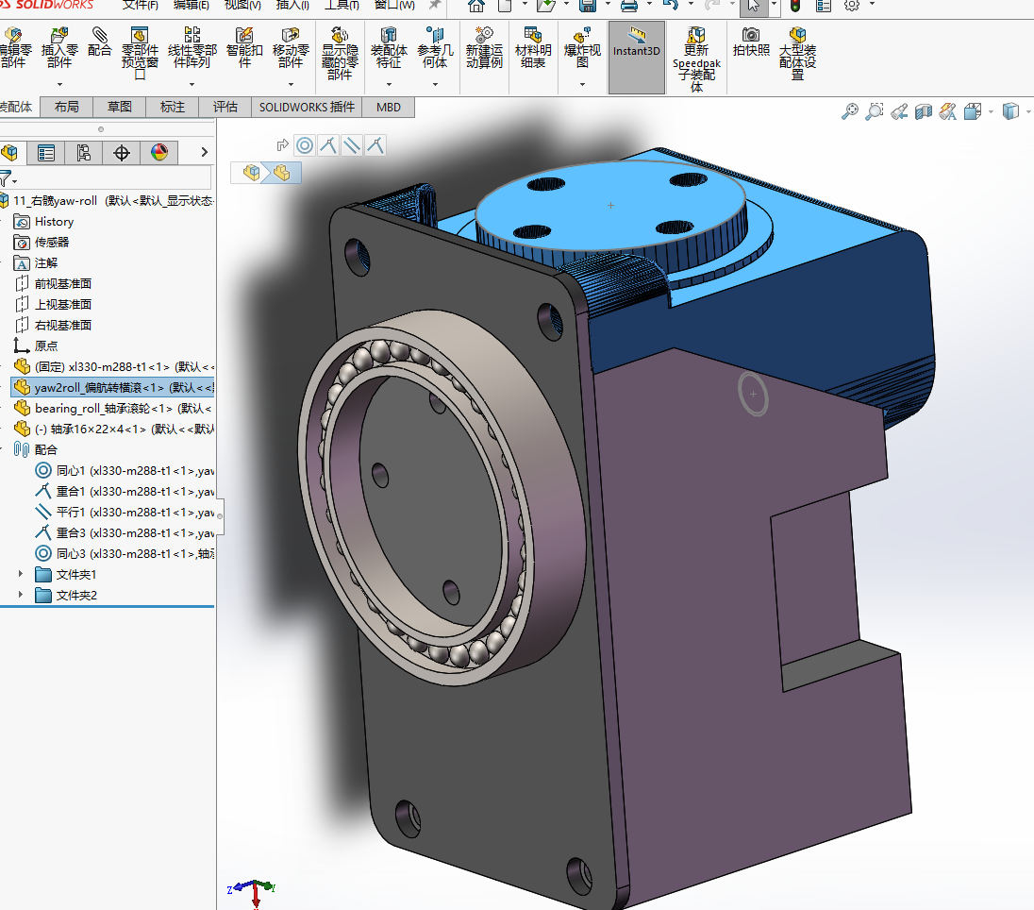
cad-repo/组件图/11-右髋.png
