Nhercar/adaptation-microduck-replica/cad-repo/组件图/13-右大腿.png

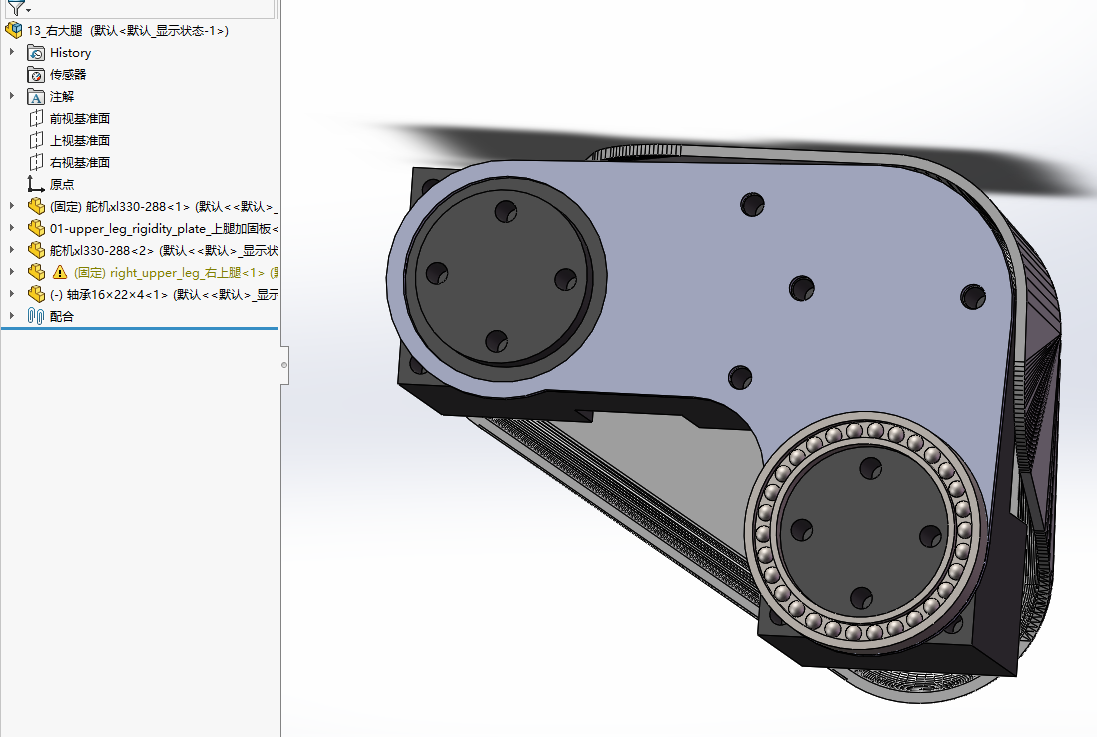
cad-repo/组件图/13-右大腿.png
