Nhercar/adaptation-microduck-replica/cad-repo/组件图/14-右小腿.png

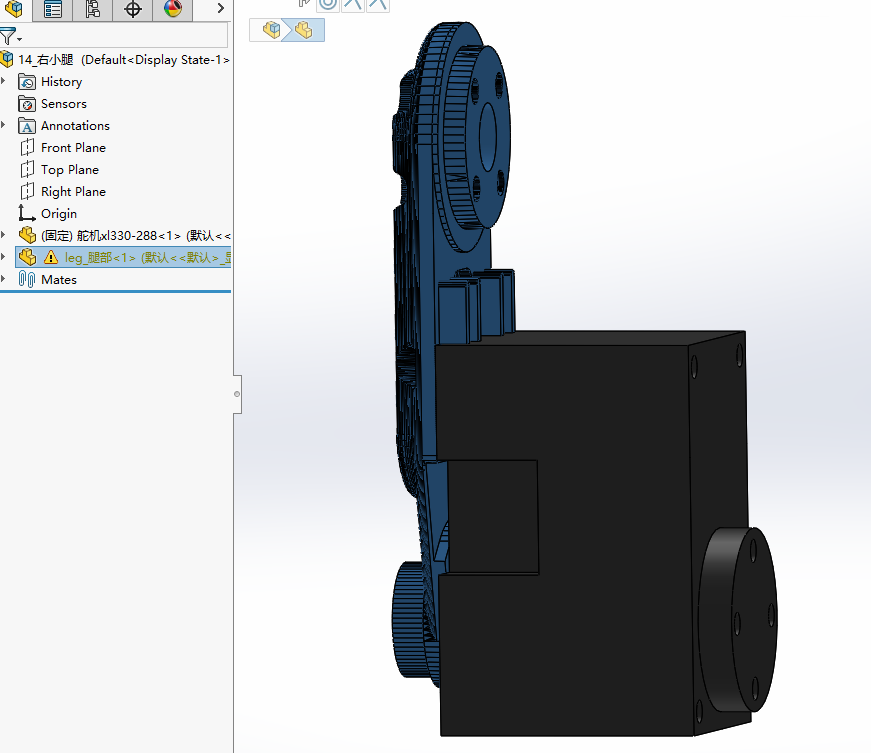
cad-repo/组件图/14-右小腿.png
