Nhercar/adaptation-microduck-replica/cad-repo/组件图/15-右踝脚.png

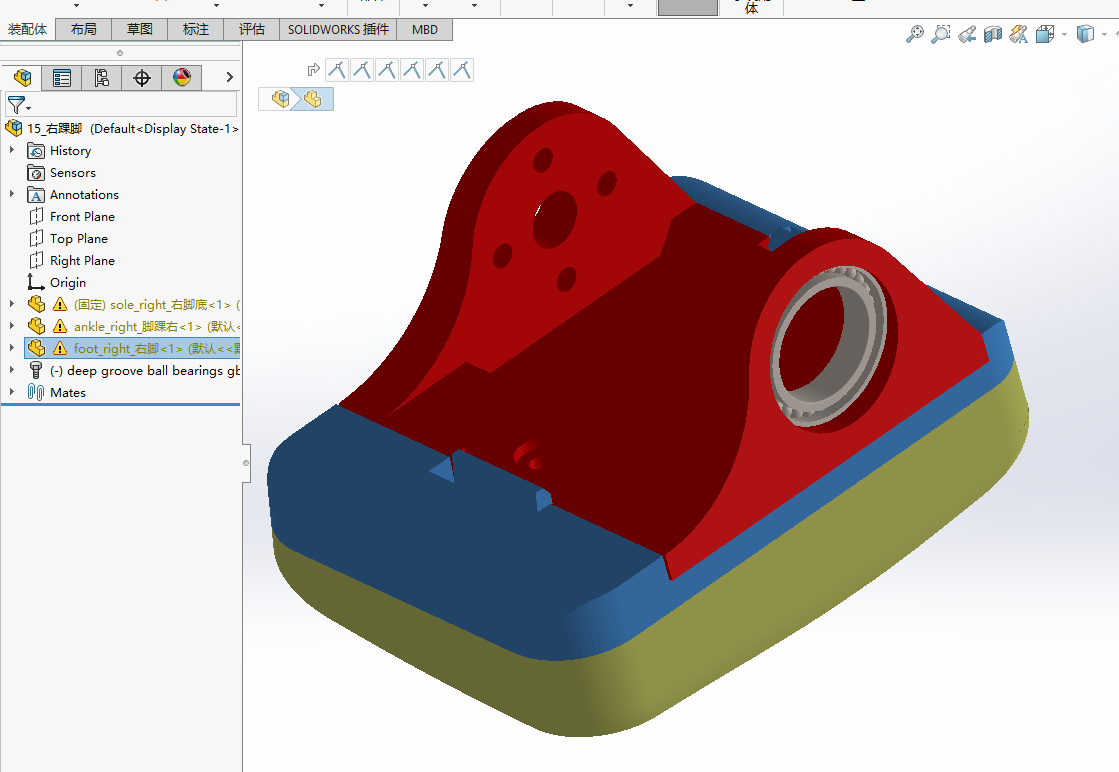
cad-repo/组件图/15-右踝脚.png
