Nhercar/adaptation-microduck-replica/cad-repo/组件图/零件明预览.png

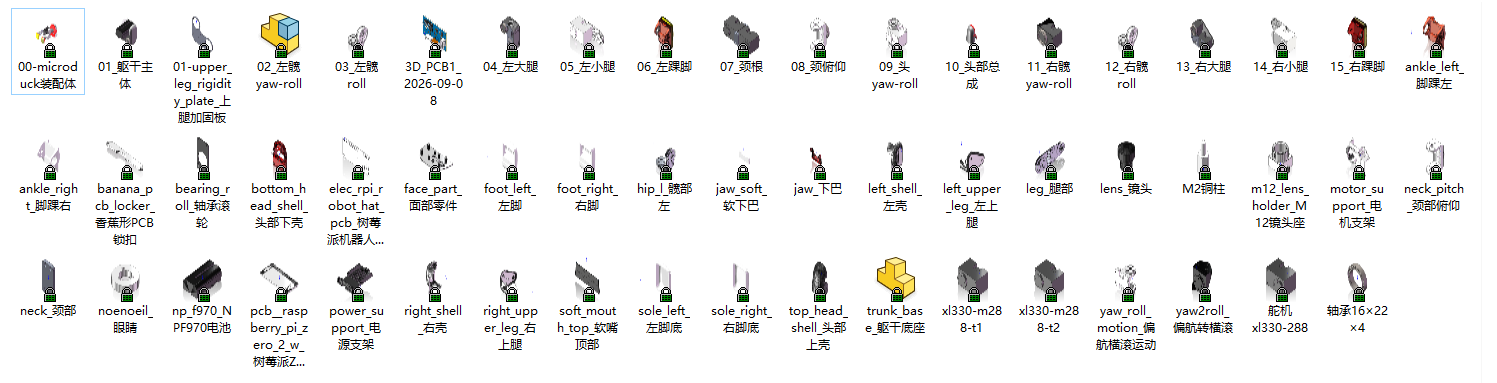
cad-repo/组件图/零件明预览.png
