Nhercar/adaptation-microduck-replica/replica-repo/assets/flash/烧卡-1-Rufus问更新-点否.png

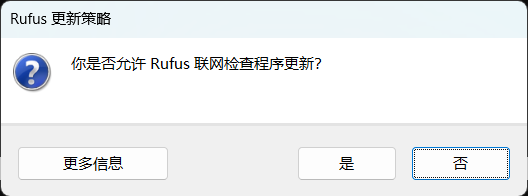
replica-repo/assets/flash/烧卡-1-Rufus问更新-点否.png
