Nhercar/adaptation-microduck-replica/replica-repo/assets/flash/烧卡-2-设备自动选中-点选择.png

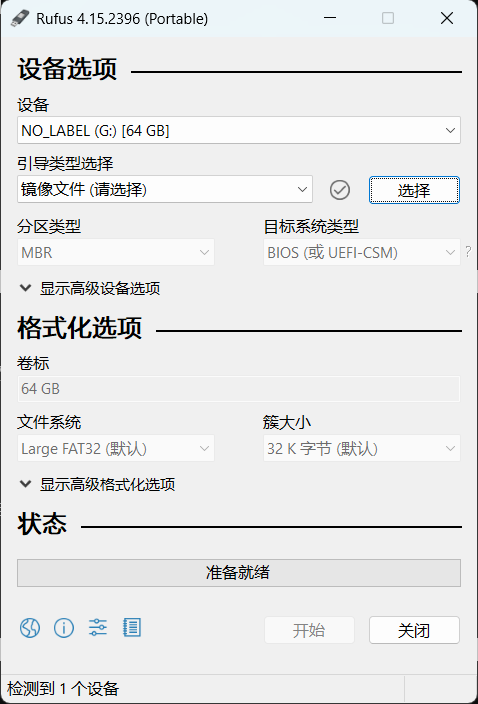
replica-repo/assets/flash/烧卡-2-设备自动选中-点选择.png
