Nhercar/adaptation-microduck-replica/replica-repo/assets/flash/烧卡-3-正在写入.png

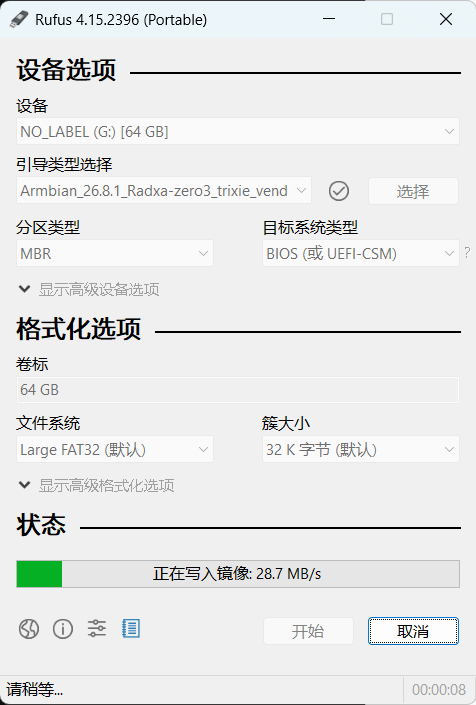
replica-repo/assets/flash/烧卡-3-正在写入.png
