Nhercar/adaptation-microduck-replica/replica-repo/assets/flash/烧卡-4-完成-准备就绪.png

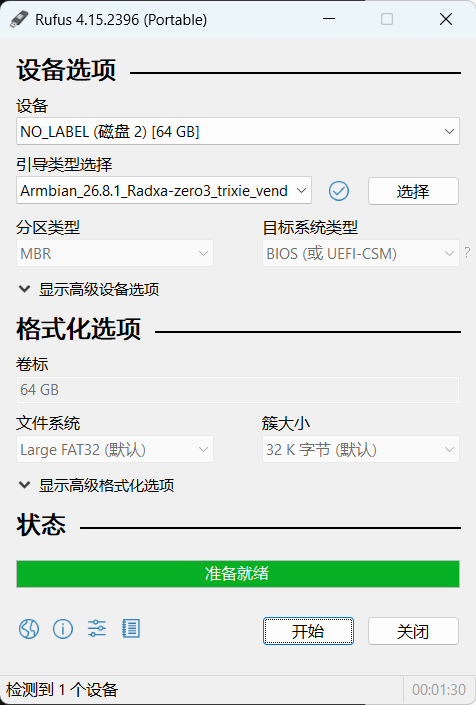
replica-repo/assets/flash/烧卡-4-完成-准备就绪.png
