Nhercar/adaptation-microduck-replica/replica-repo/assets/hw/02-电源分配.png

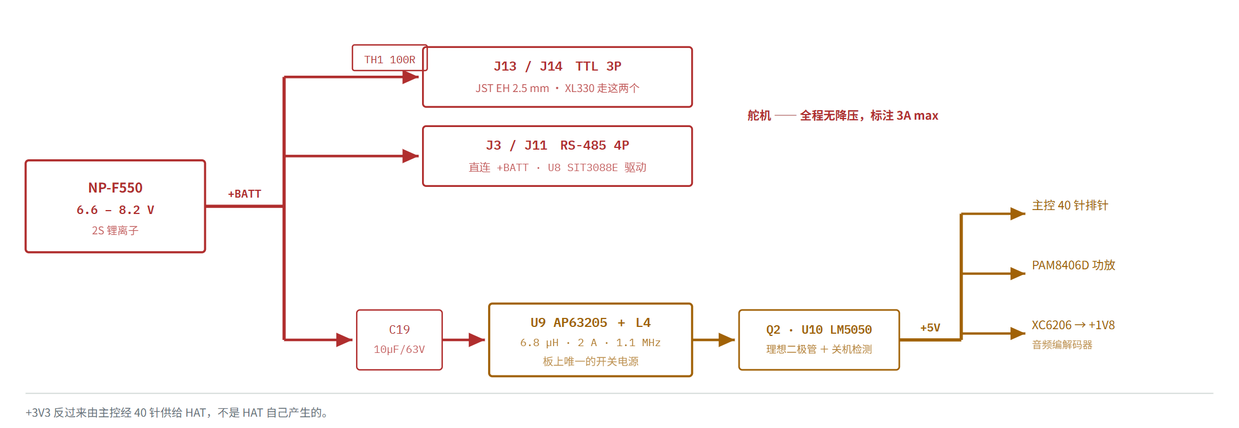
replica-repo/assets/hw/02-电源分配.png
