Nhercar/adaptation-microduck-replica/replica-repo/assets/hw/02b-供电与保护.png

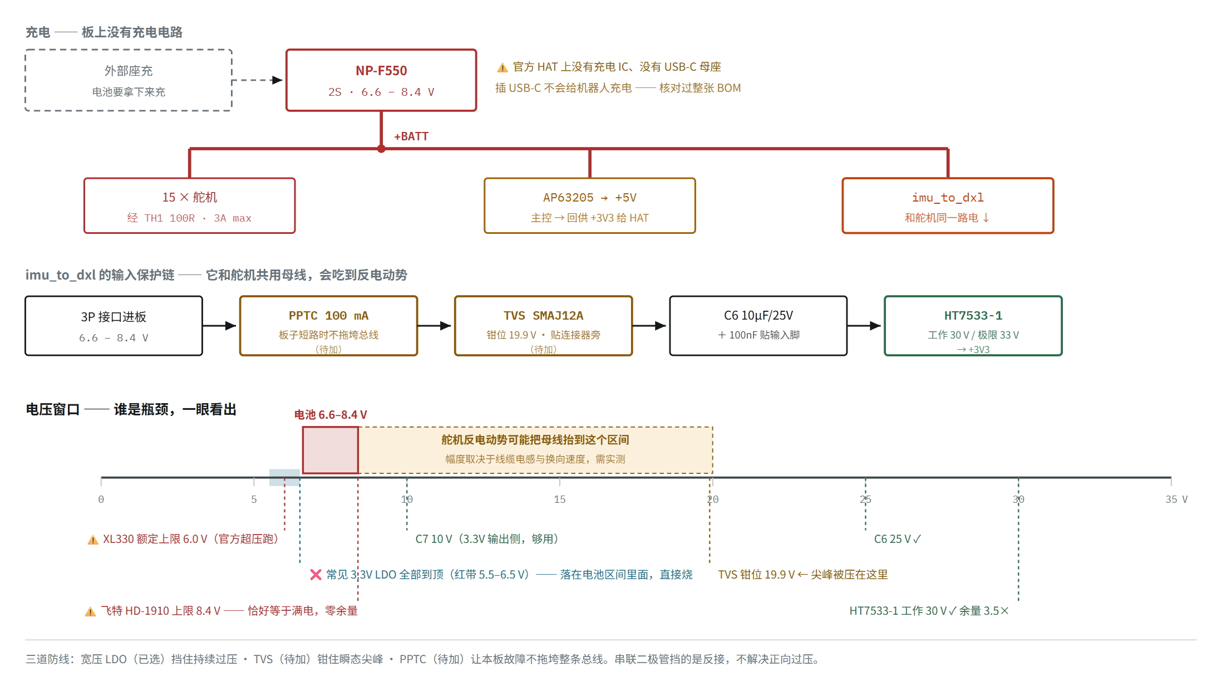
replica-repo/assets/hw/02b-供电与保护.png
