Nhercar/adaptation-microduck-replica/replica-repo/assets/hw/03-总线拓扑.png

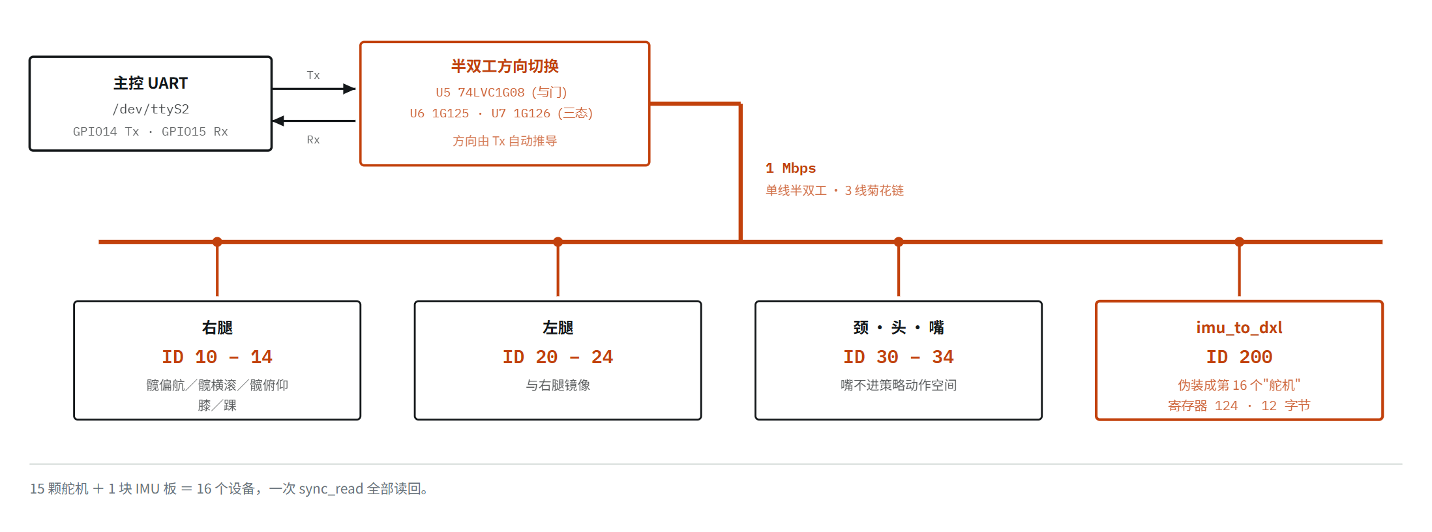
replica-repo/assets/hw/03-总线拓扑.png
