Nhercar/adaptation-microduck-replica/replica-repo/assets/hw/04-控制周期.png

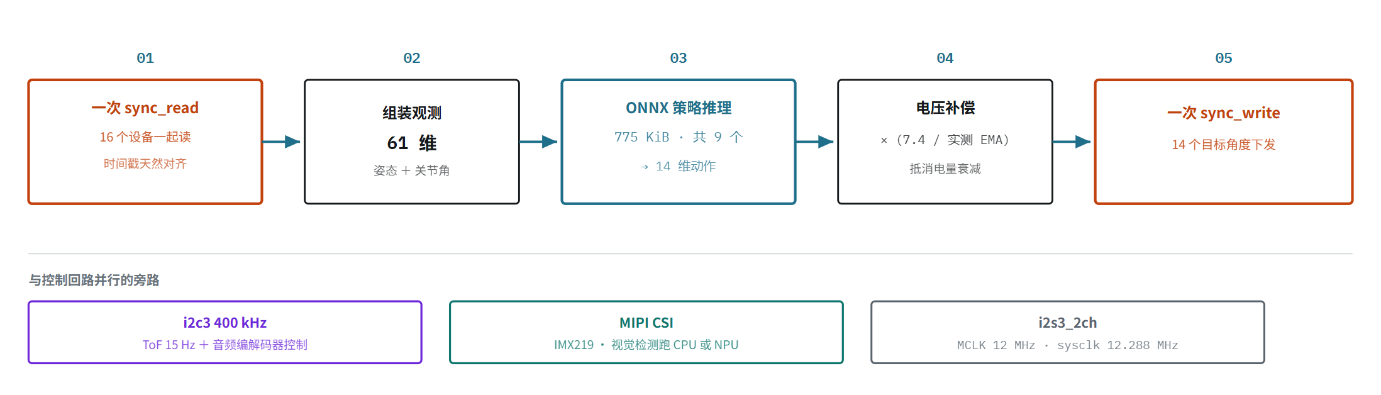
replica-repo/assets/hw/04-控制周期.png
