Nhercar/adaptation-microduck-replica/replica-repo/assets/hw/05-IMU板内部.png

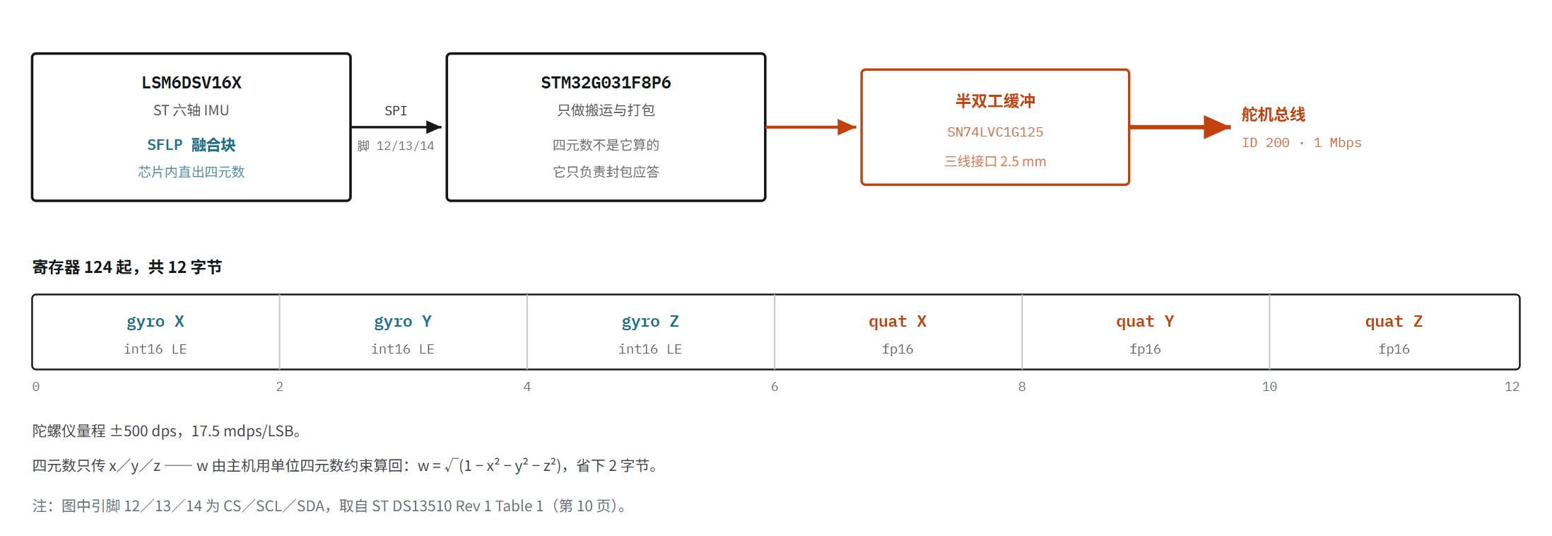
replica-repo/assets/hw/05-IMU板内部.png
