Nhercar/adaptation-microduck-replica/replica-repo/assets/hw/06-总线时序对比.png

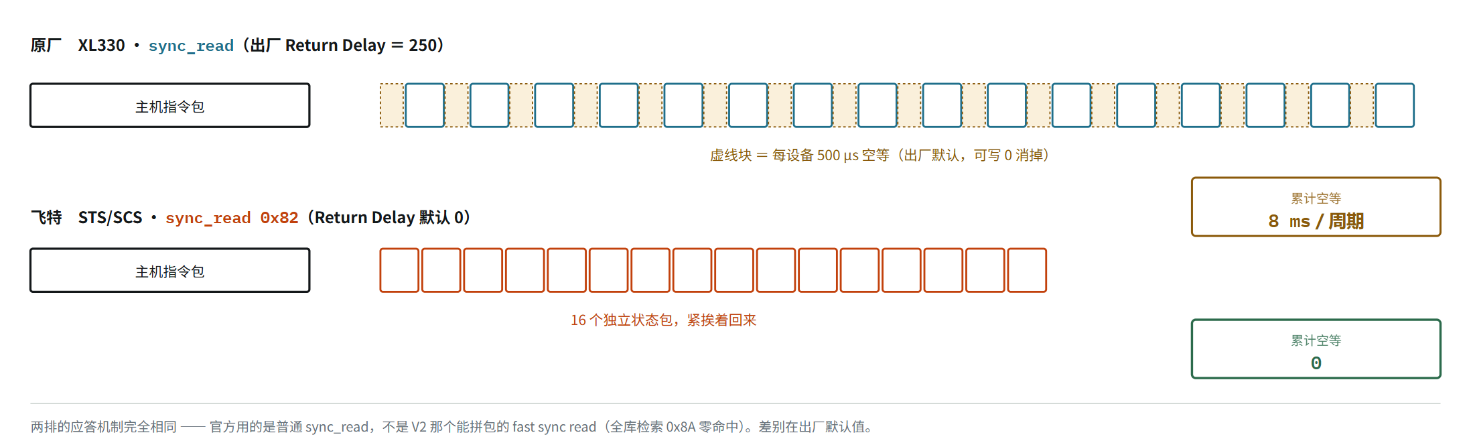
replica-repo/assets/hw/06-总线时序对比.png
