Nhercar/adaptation-microduck-replica/replica-repo/assets/hw/imu_to_dxl-PCB.png

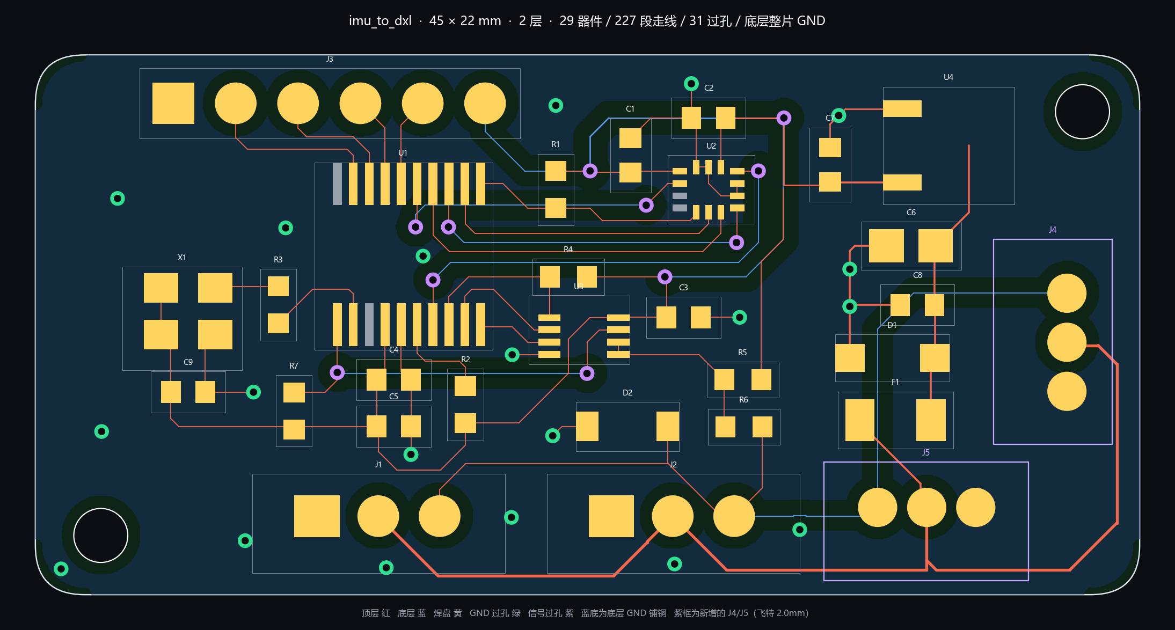
replica-repo/assets/hw/imu_to_dxl-PCB.png
