Nhercar/adaptation-microduck-replica/replica-repo/assets/hw/imu_to_dxl-原理图.png

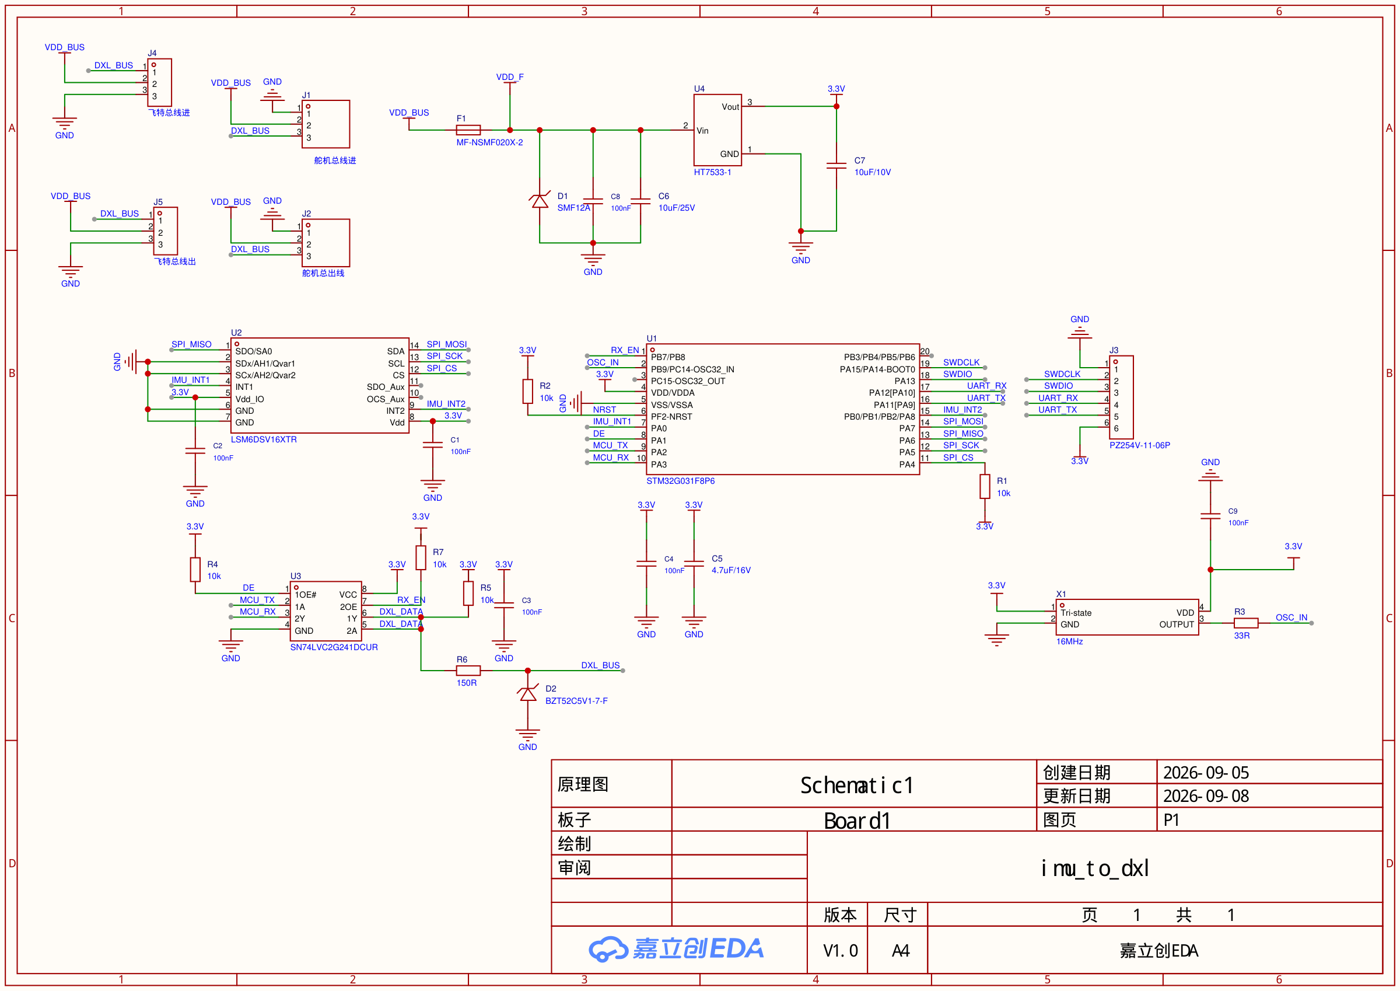
replica-repo/assets/hw/imu_to_dxl-原理图.png
