Nhercar/adaptation-microduck-replica/replica-repo/assets/hw/radxa-camera-cable-reference-20260928.png

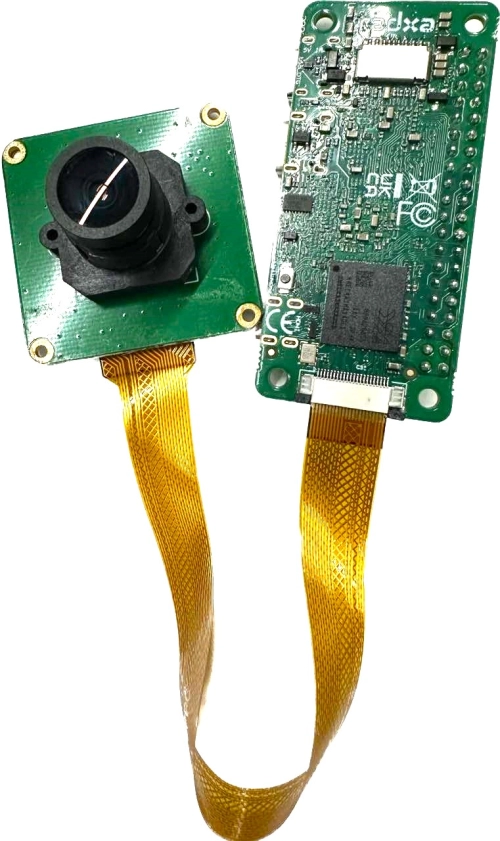
replica-repo/assets/hw/radxa-camera-cable-reference-20260928.png
