Nhercar/adaptation-microduck-replica/replica-repo/assets/hw/不打HAT-接线图.png

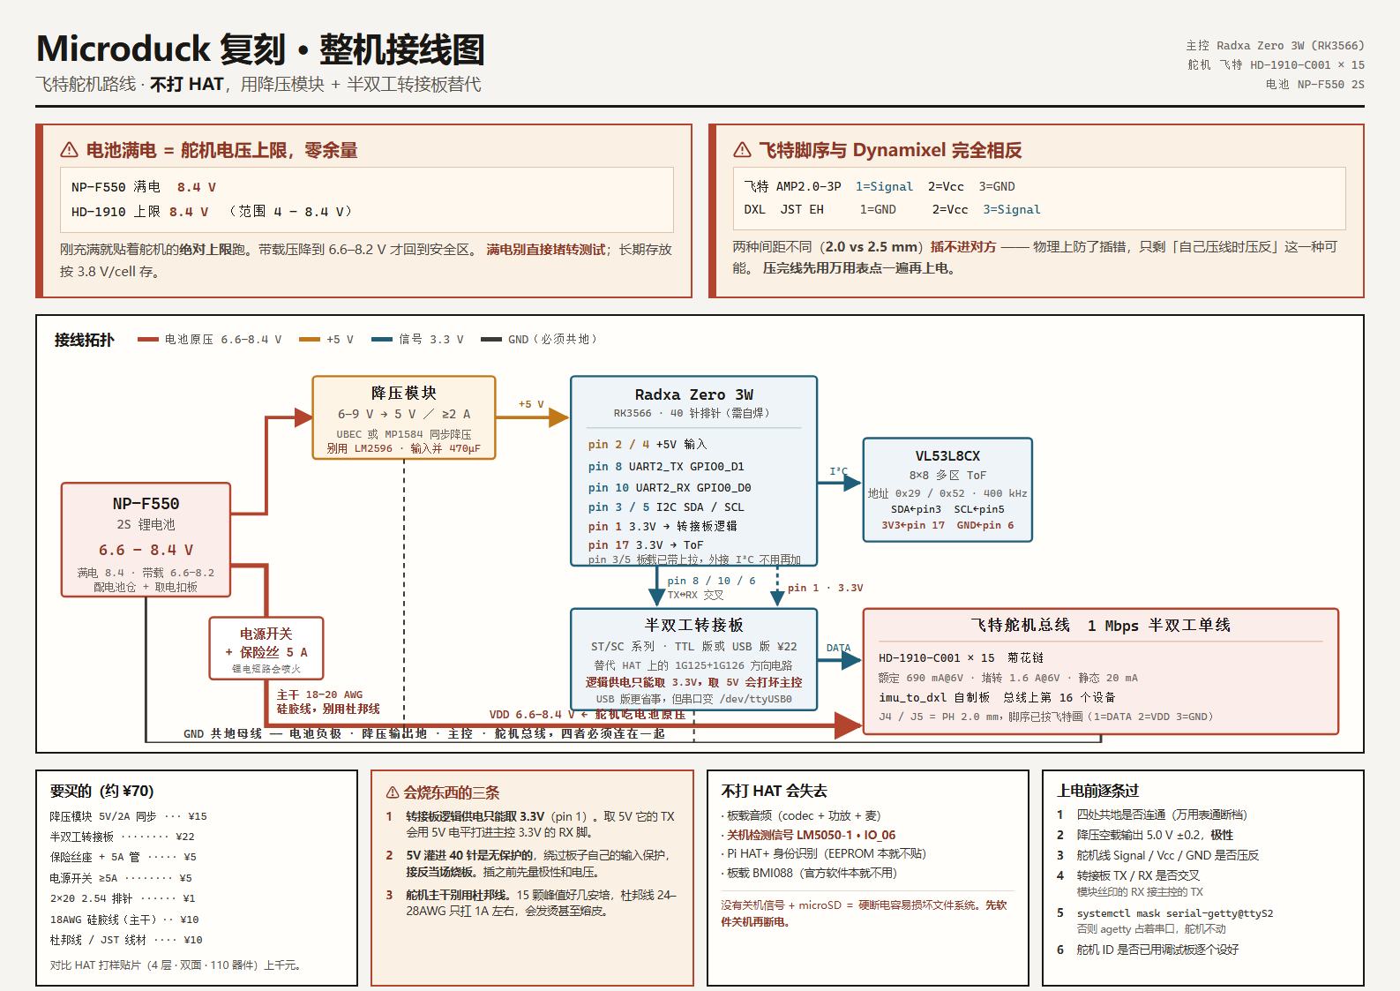
replica-repo/assets/hw/不打HAT-接线图.png
