Nhercar/adaptation-microduck-replica/replica-repo/assets/servo-web.png

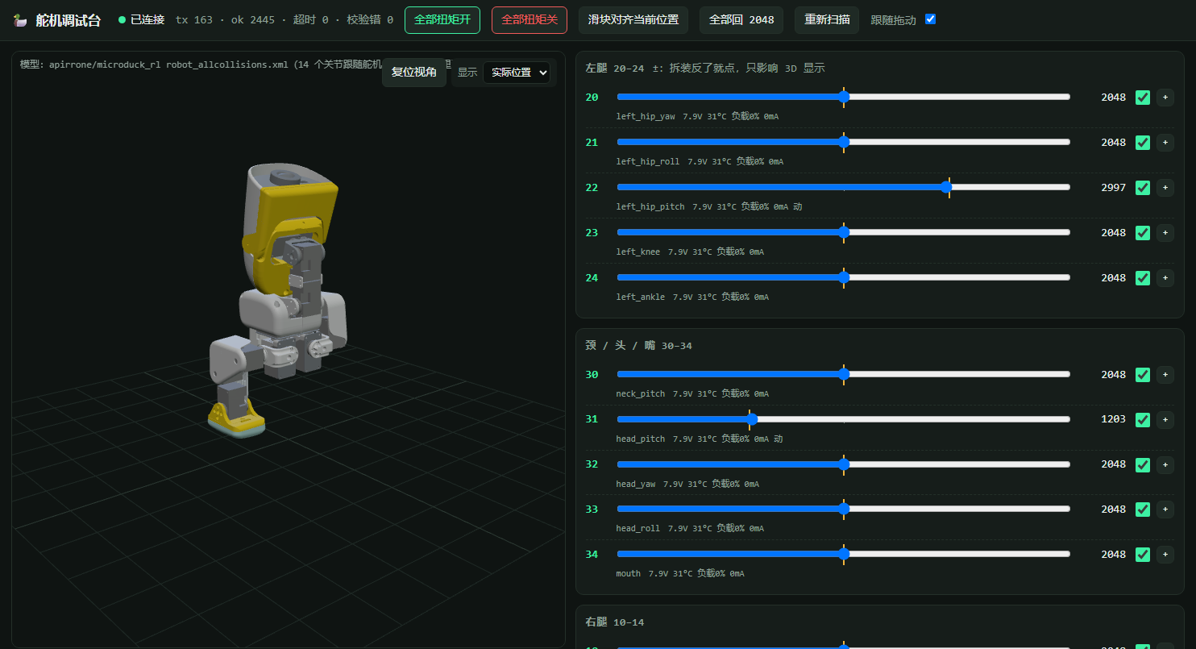
replica-repo/assets/servo-web.png
