Nhercar/adaptation-microduck-replica/replica-repo/assets/social/douyin-qr.jpg

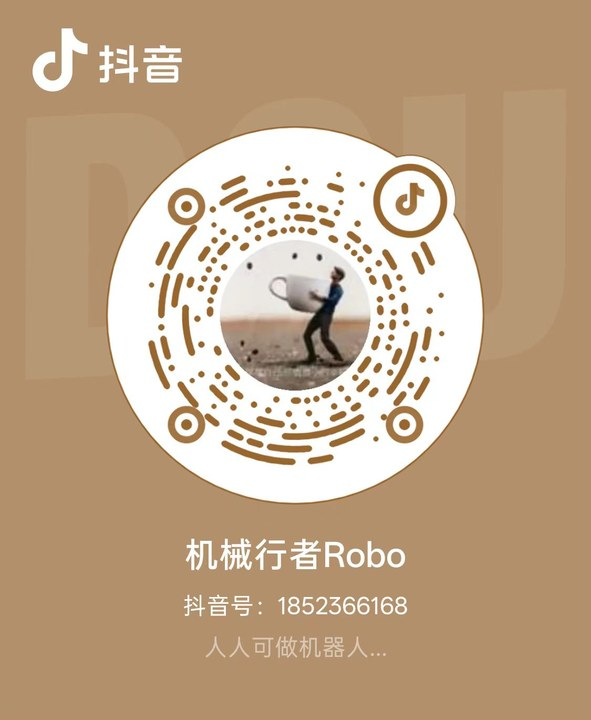
replica-repo/assets/social/douyin-qr.jpg
