Nhercar/adaptation-microduck-replica/replica-repo/assets/studio-overview.png

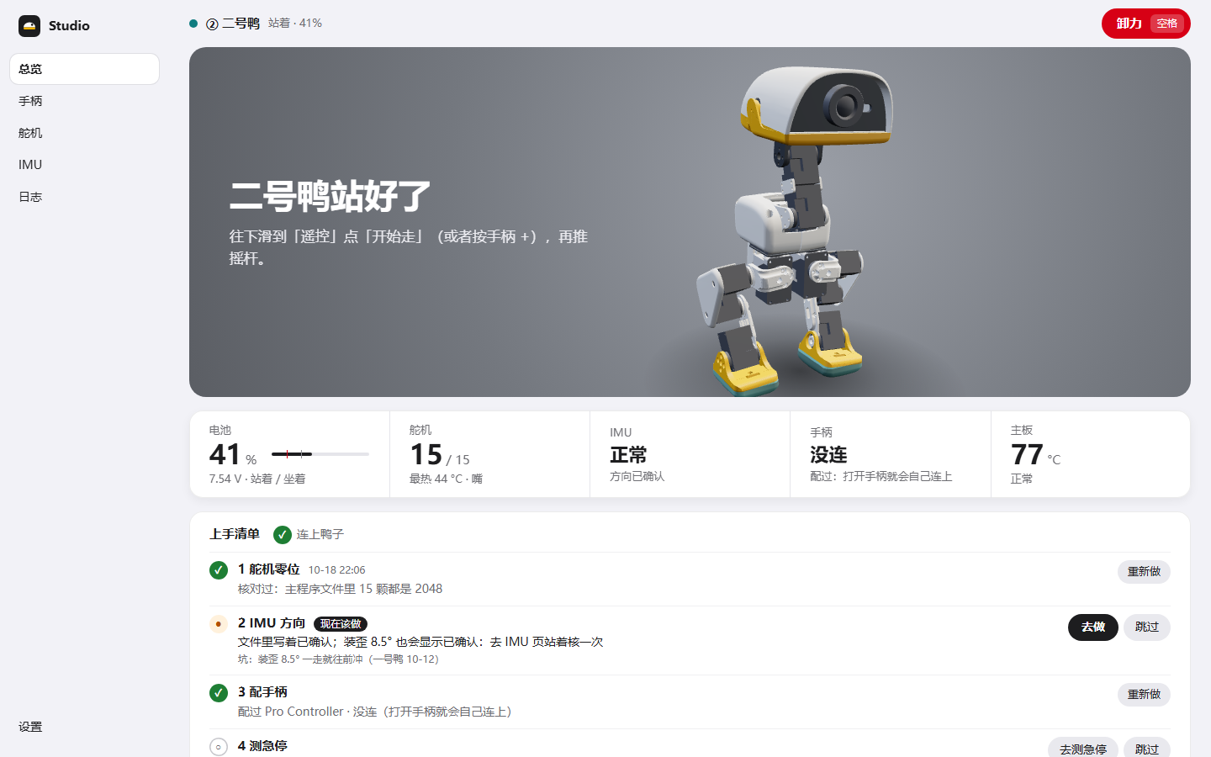
replica-repo/assets/studio-overview.png
