Nhercar/adaptation-microduck-replica/replica-repo/assets/wechat-group-11.png

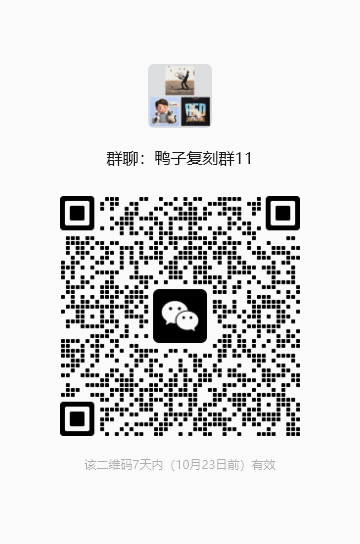
replica-repo/assets/wechat-group-11.png
