Nhercar/adaptation-microduck-replica/replica-repo/assets/走路-2026-10-15.gif

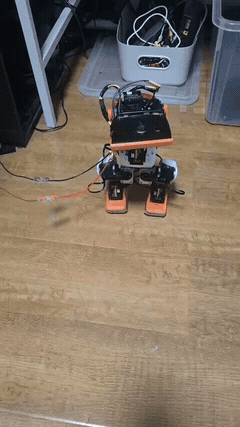
replica-repo/assets/走路-2026-10-15.gif
