Nhercar/adaptation-microduck-replica/replica-repo/assets/首次上电-2026-09-18.jpg

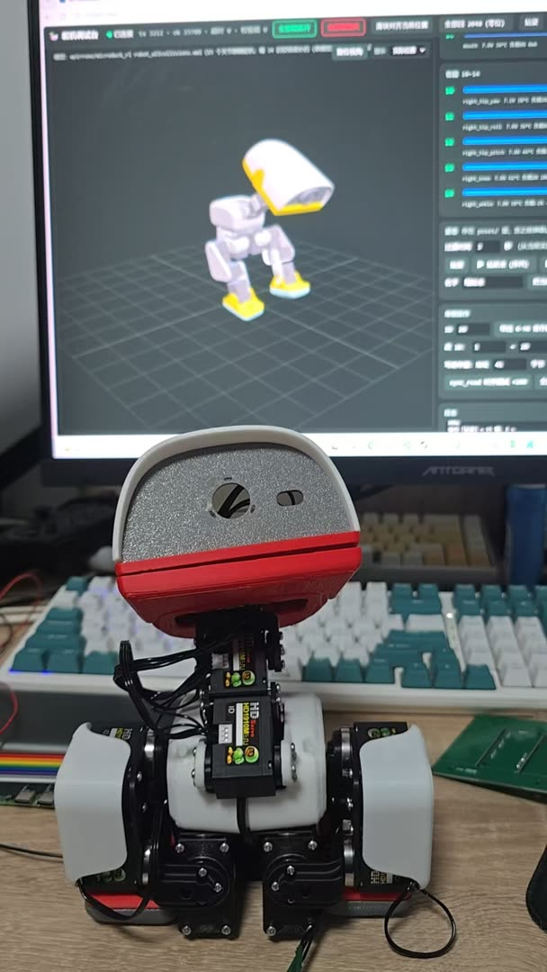
replica-repo/assets/首次上电-2026-09-18.jpg
