Nhercar/adaptation-microduck-replica/replica-repo/assets/首次上电-站起来.gif

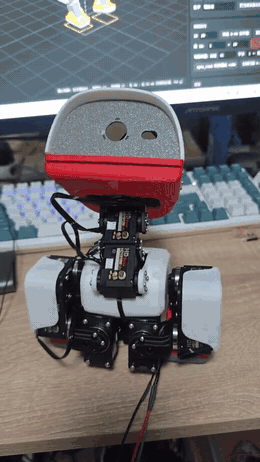
replica-repo/assets/首次上电-站起来.gif
