Nhercar/adaptation-microduck-replica/cad-repo/打印/microduck-飞特版-BambuStudio2026-10-20.3mf

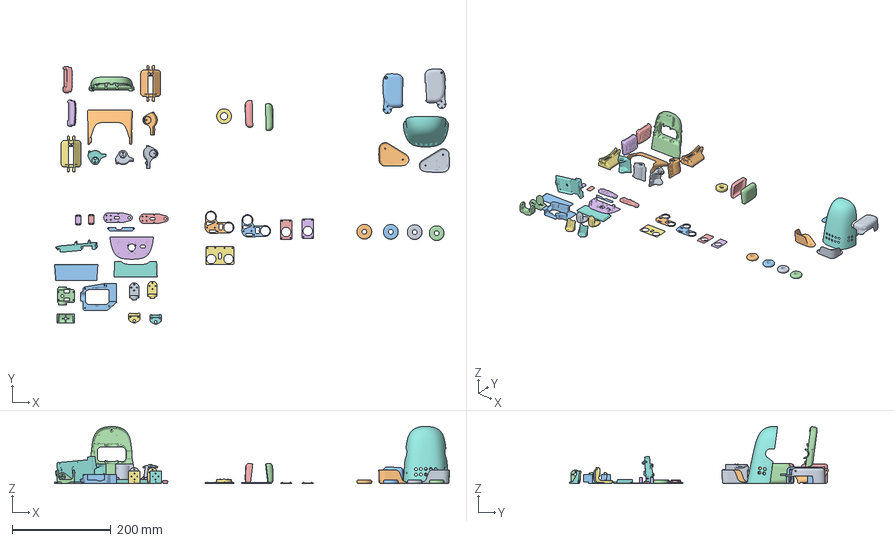
[picture p60: CAD file, 2026-10-23]
cad-repo/打印/microduck-飞特版-BambuStudio2026-10-20.3mf
799.5 x 524.0 x 116.0 mm
ankle_l_v1_脚踝左V1.stl
ankle_r_v1_脚踝右V1.stl
banana_pcb_locker_香蕉形PCB锁扣.stl
bottom_head_shell_头部下壳.stl
foot_left_左脚.stl
foot_right_右脚.stl
hip_l_髋部左.stl x 2
jaw_soft_软下巴.stl
jaw_下巴.stl
motor_support_电机支架.stl
neck_pitch_颈部俯仰.stl
neck_颈部.stl x 2
noenoeil_眼睛.stl
power_support_电源支架.stl
right_shell_右壳.stl
roller_blade_滚轮叶片.stl x 2
soft_mouth_top_软嘴顶部.stl
sole_left_左脚底.stl
sole_right_右脚底.stl
face_part_面部零件.stp
ankle_right脚踝右.STEP
ankle_left_脚踝左.STEP
01-upper_leg_rigidity_plate_上腿加固板-FT.STEP x 2
99-yaw_roll_motion_偏航横滚运动-F.STEP
leg_腿部-FT.STEP x 2
trunk_base_躯干底座.stl
