Nhercar/adaptation-microduck-replica/replica-repo/hardware/imu_to_dxl/imu_to_dxl-PCB.step

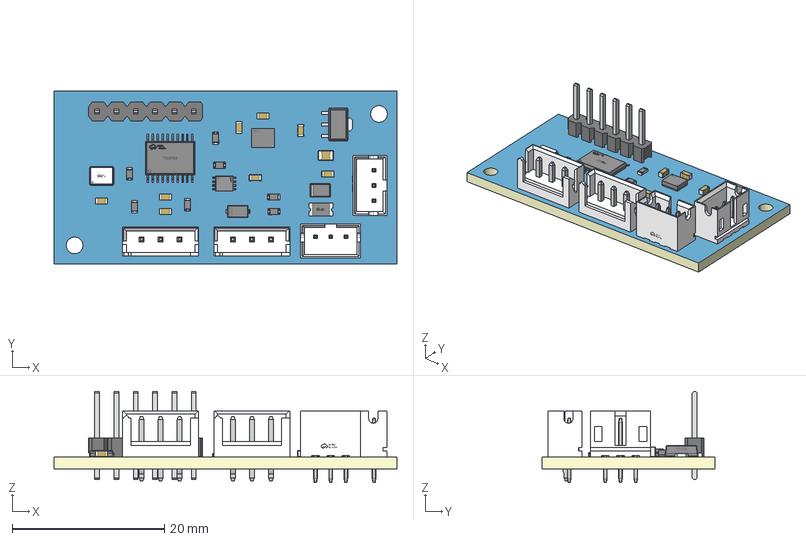
[picture p61: CAD file, 2026-10-23]
replica-repo/hardware/imu_to_dxl/imu_to_dxl-PCB.step
45.1 x 22.7 x 12.0 mm
Board~ss66
TopCopper~ss66
BottomCopper~ss66
TopSilkscreen~ss66
BottomSilkscreen~ss66
TopFpcStiffener~ss66
BottomFpcStiffener~ss66
C0805~C0805_L2.0-W1.3-H1.3~nCY8
SOD-123FL_L2.7-W1.8-LS3.7-RD~SOD-123FL_L2.8-W1.8-H1.1-LS3.6~Ts2a
LGA-14_L3.0-W2.5-P0.50-BR~LGA-14_L3.0-W2.5-P0.50-BR~xgQh
CONN-TH_B3B-EH-A-LF-SN~CONN-TH_B3B-EH-A-LF-SN~hPIn x 2
R0603~R0603~2pOD x 7
HDR-TH_6P-P2.54-V-M~HDR-TH_6P-P2.54-M-LI-1X6P~mF3L
VSSOP-8_L2.3-W2.0-P0.50-LS3.1-BR~VSSOP-8_L2.3-W2.0-P0.50-LS3.1-BL~MIWO
SOD-123_L2.7-W1.6-LS3.7-RD~SOD-123_L2.7-W1.6-H1.4-LS3.7~0OJw
TSSOP-20_L6.5-W4.4-P0.65-LS6.4-BL~TSSOP-20_L6.5-W4.4-H1.0-LS6.4-P0.65~VWKP
C0603~C0603_L1.6-W0.8-H0.8~crEB x 8
CONN-TH_B3B-PH-K-S~CONN-TH_B3B-PH-K-S~Q7be x 2
SOT-89-3_L4.5-W2.5-P1.50-LS4.2-BR~SOT-89-3_L4.3-W2.5-H1.6-LS4.1-P1.50~uLfP
OSC-SMD_4P-L3.2-W2.5-BL_SIT8008BI~OSC-SMD_4P-L3.2-W2.5-H1.0~S9ms
F1206~F1206_L3.2-W1.7-H0.6~vEE0
