Nhercar/adaptation-microduck-replica/replica-repo/hardware/新版/imu_to_dxl_1V0A/imu_to_dxl_1V0A-PCB.step

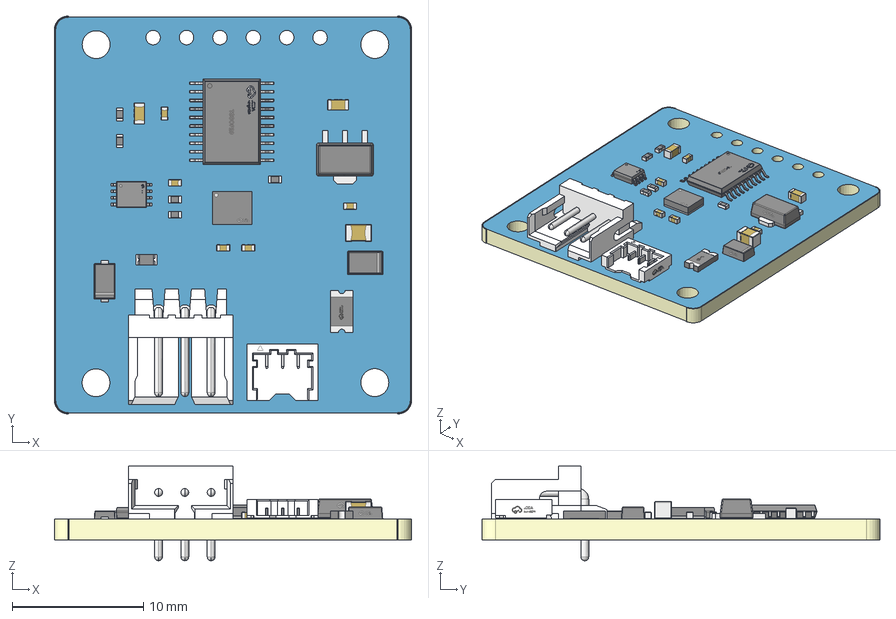
[picture p62: CAD file, 2026-10-23]
replica-repo/hardware/新版/imu_to_dxl_1V0A/imu_to_dxl_1V0A-PCB.step
27.2 x 30.3 x 7.20 mm
Board~3kha
TopCopper~3kha
BottomCopper~3kha
TopSilkscreen~3kha
BottomSilkscreen~3kha
TopFpcStiffener~3kha
BottomFpcStiffener~3kha
R0603~R0603~vGSg
F1206~F1206_L3.2-W1.7-H0.6~Zeya
LGA-14_L3.0-W2.5-P0.50-BR~LGA-14_L3.0-W2.5-P0.50-BR~VHnC
C0603~C0603_L1.6-W0.8-H0.8~4zB6 x 2
SOD-123FL_L2.7-W1.8-LS3.7-RD~SOD-123FL_L2.8-W1.8-H1.1-LS3.6~aTMh
C0805~C0805_L2.0-W1.3-H1.3~tVAY
SOD-123_L2.7-W1.6-LS3.7-RD~SOD-123_L2.7-W1.6-H1.4-LS3.7~ag24
VSSOP-8_L2.3-W2.0-P0.50-LS3.1-BR~VSSOP-8_L2.3-W2.0-P0.50-LS3.1-BL~DsEh
TSSOP-20_L6.5-W4.4-P0.65-LS6.4-BL~TSSOP-20_L6.5-W4.4-H1.0-LS6.4-P0.65~uYpm
R0402~R0402_L1.0-W0.5-H0.4~iul2 x 5
SOT-89-3_L4.5-W2.5-P1.50-LS4.2-BR~SOT-89-3_L4.3-W2.5-H1.6-LS4.1-P1.50~fQx8
C0402~C0402_L1.0-W0.5-H0.5~omHE x 5
CONN-TH_A2007WR-3P~CONN-TH_A2007WR-3P~Y1dY
CONN-SMD_3P-P1.20_BM03B-ACHSS-GAN-ETF~CONN-SMD_3P-P1.20_BM03B-ACHSS-GAN-ETF~gxV7
