Nhercar/adaptation-microduck-replica/replica-repo/hardware/新版/POGO_PIN_1V0A/POGO_PIN_1V0A-PCB.step

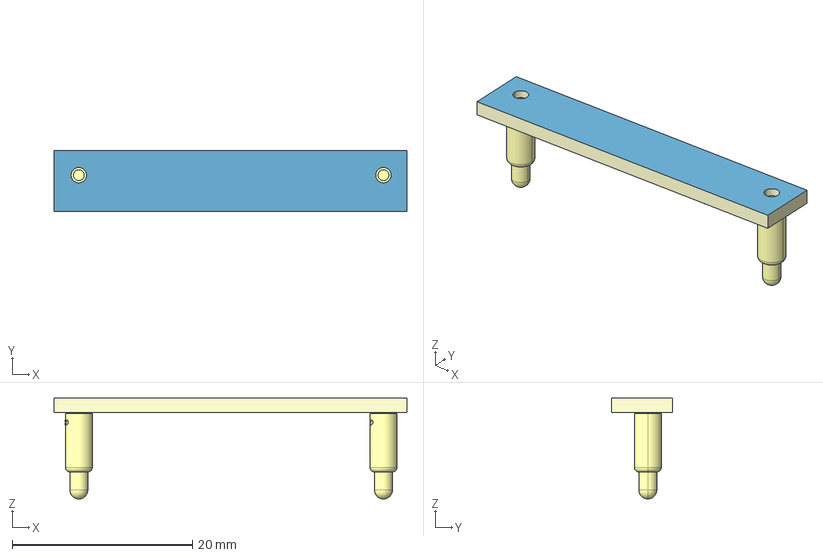
[picture p63: CAD file, 2026-10-23]
replica-repo/hardware/新版/POGO_PIN_1V0A/POGO_PIN_1V0A-PCB.step
39.2 x 6.76 x 11.2 mm
Board~l4fB
TopCopper~l4fB
BottomCopper~l4fB
TopSilkscreen~l4fB
BottomSilkscreen~l4fB
TopFpcStiffener~l4fB
BottomFpcStiffener~l4fB
SMD_BD3.0-D1.2-H9.5~SMD_BD3.0-D1.2-H9.5~461I x 2
