Nhercar/adaptation-microduck-replica/replica-repo/hardware/新版/wire_hub_1V0A/wire_hub_1V0A-PCB.step

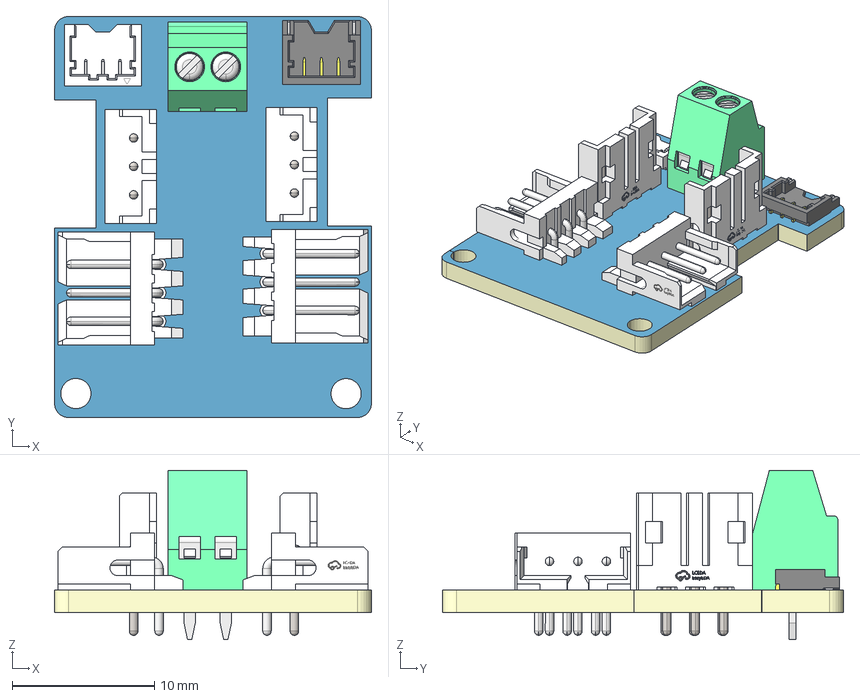
[picture p64: CAD file, 2026-10-23]
replica-repo/hardware/新版/wire_hub_1V0A/wire_hub_1V0A-PCB.step
22.3 x 28.2 x 11.9 mm
Board~QOFv
TopCopper~QOFv
BottomCopper~QOFv
TopSilkscreen~QOFv
BottomSilkscreen~QOFv
TopFpcStiffener~QOFv
BottomFpcStiffener~QOFv
CONN-SMD_3P-P1.20_BM03B-ACHSS-GAN-ETF~CONN-SMD_3P-P1.20_BM03B-ACHSS-GAN-ETF~vDlm
CONN-TH_A2007WR-3P~CONN-TH_A2007WR-3P~OMKW x 2
CONN-SMD_3P-P1.20_HCTL_HC-1.2-3PWT~CONN-SMD_3P-P1.20_HCTL_HC-1.2-3PWT~mcqK
CONN-TH_A2007WV-3P~CONN-TH_A2007WV-3P~kjK0 x 2
CONN-TH_DB125-2.54-2P-GN~CONN-TH_DB125-2.54-2P-GN~ex5f
