Nhercar/adaptation-microduck-replica/replica-repo/software/training/src/mjlab_microduck/robot/microduck/assets/lens.stl

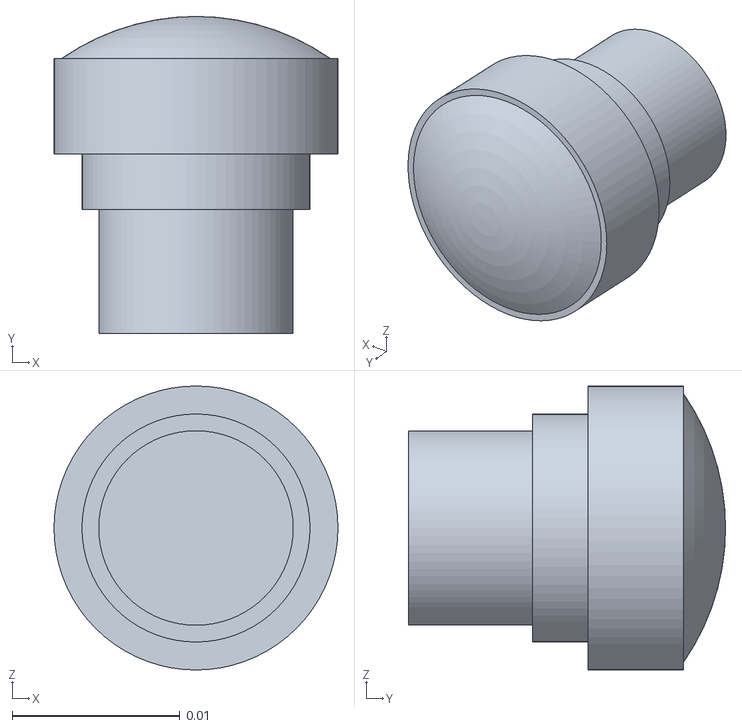
[picture p65: CAD file, 2026-10-23]
replica-repo/software/training/src/mjlab_microduck/robot/microduck/assets/lens.stl
0.0169 x 0.0189 x 0.0169
