Nhercar/adaptation-microduck-replica/replica-repo/software/training/src/mjlab_microduck/robot/xl330_test_bench/assets/spacer.stl

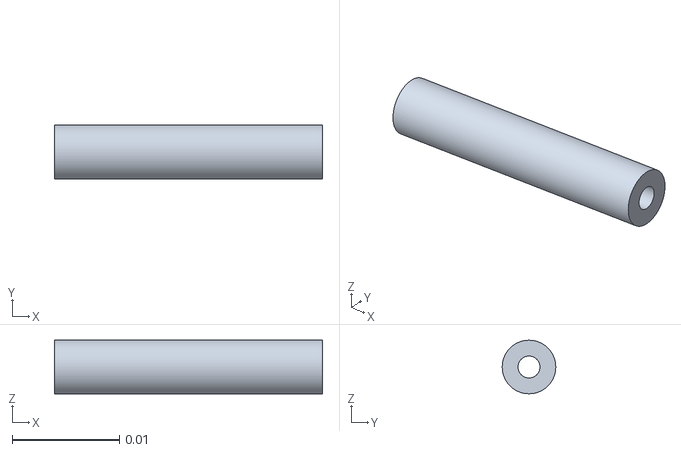
[picture p66: CAD file, 2026-10-23]
replica-repo/software/training/src/mjlab_microduck/robot/xl330_test_bench/assets/spacer.stl
0.025 x 0.005 x 0.005
