Nhercar/adaptation-microduck-replica/step-files/left_upper_leg_左上腿-FT.STEP

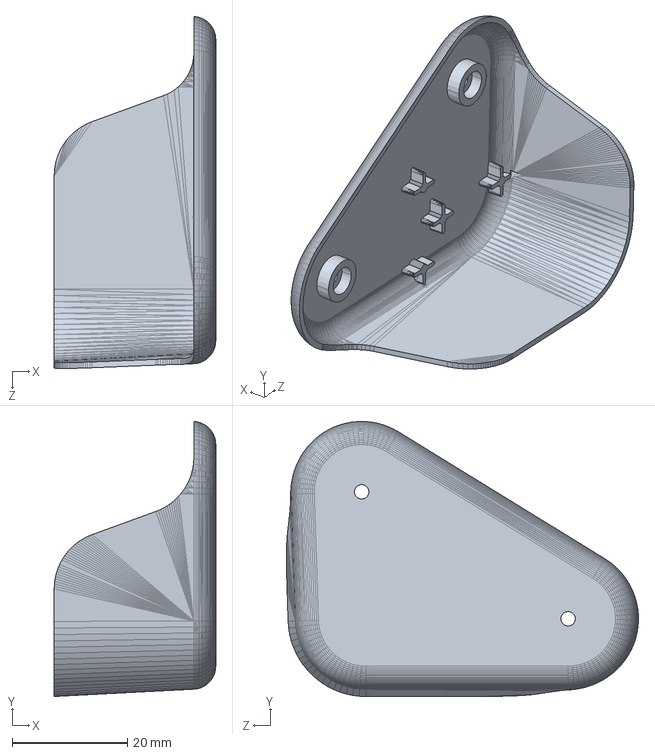
[picture p67: CAD file, 2026-10-23]
step-files/left_upper_leg_左上腿-FT.STEP
28.0 x 47.7 x 61.0 mm
