Nhercar/adaptation-microduck-replica/stl-files/19_sole_right_suela_derecha.stl

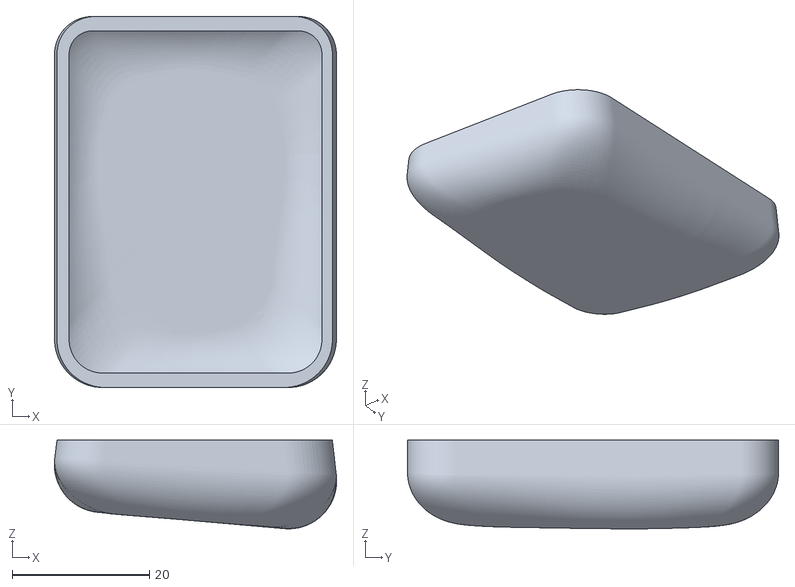
[picture p68: CAD file, 2026-10-23]
stl-files/19_sole_right_suela_derecha.stl
41.1 x 54.0 x 12.9
