Nhercar/adaptation-microduck-replica/replica-repo/hardware/imu_to_dxl/imu_to_dxl-板框-45x22-R2.dxf

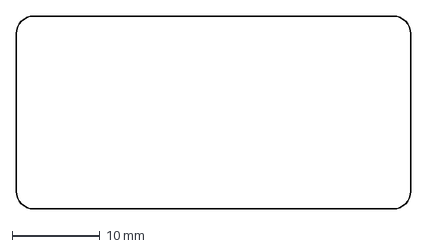
[picture p69: CAD file, 2026-10-23]
replica-repo/hardware/imu_to_dxl/imu_to_dxl-板框-45x22-R2.dxf
45.0 x 22.0 mm
