Nhercar/adaptation-microduck-replica/replica-repo/software/training/src/mjlab_microduck/robot/microduck/assets/left_upper_leg.stl

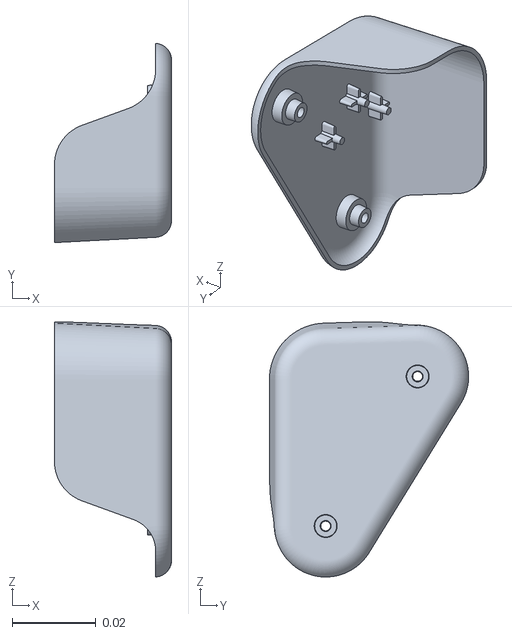
[picture p70: CAD file, 2026-10-23]
replica-repo/software/training/src/mjlab_microduck/robot/microduck/assets/left_upper_leg.stl
0.028 x 0.0477 x 0.061
