Nhercar/adaptation-microduck-replica/replica-repo/software/training/src/mjlab_microduck/robot/xl330_test_bench/assets/axis.stl

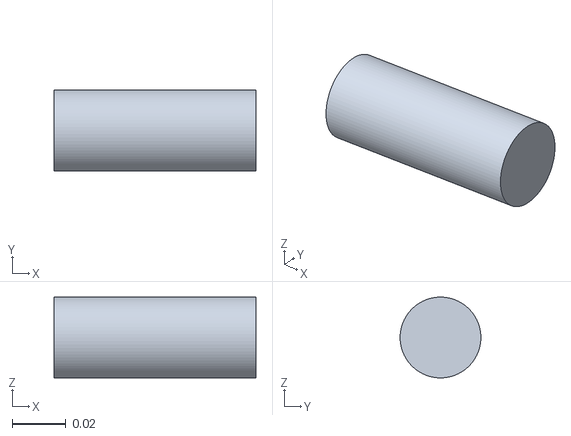
[picture p71: CAD file, 2026-10-23]
replica-repo/software/training/src/mjlab_microduck/robot/xl330_test_bench/assets/axis.stl
0.075 x 0.03 x 0.03
