Nhercar/adaptation-microduck-replica/step-files/ankle_right脚踝右1-FT.STEP

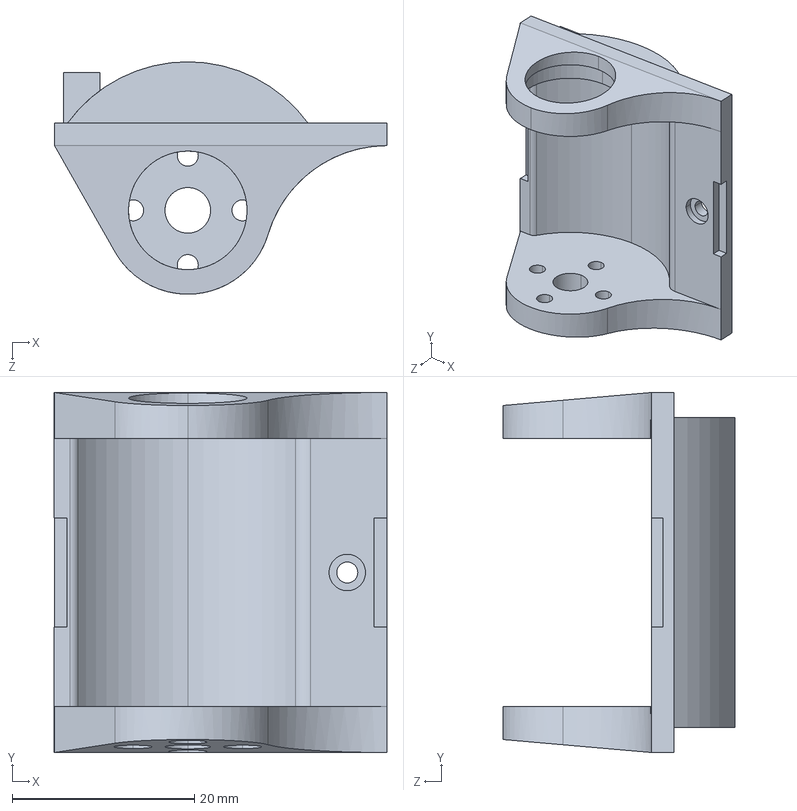
[picture p72: CAD file, 2026-10-23]
step-files/ankle_right脚踝右1-FT.STEP
36.5 x 39.5 x 25.5 mm
