Nhercar/adaptation-microduck-replica/stl-files/07_hip_l_cadera.stl

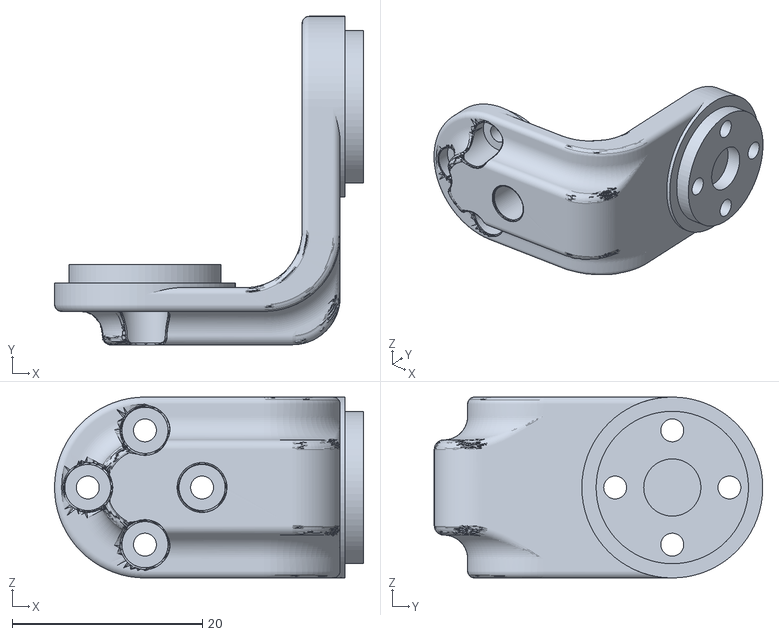
[picture p73: CAD file, 2026-10-23]
stl-files/07_hip_l_cadera.stl
32.5 x 34.5 x 19.0
