Nhercar/adaptation-microduck-replica/replica-repo/software/training/src/mjlab_microduck/robot/microduck/assets/tire.stl

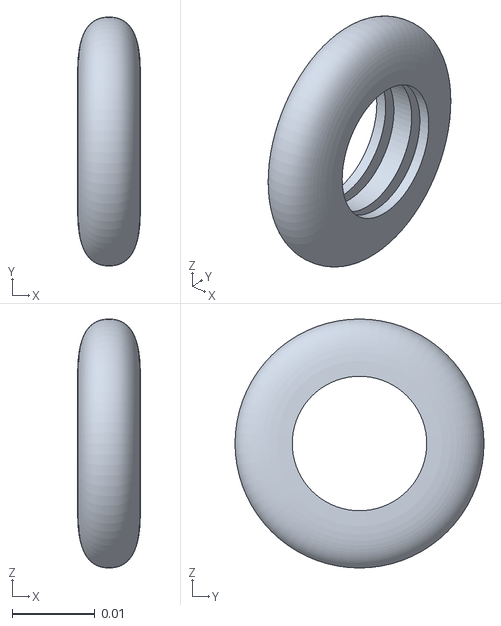
[picture p74: CAD file, 2026-10-23]
replica-repo/software/training/src/mjlab_microduck/robot/microduck/assets/tire.stl
0.0076 x 0.03 x 0.03
