Nhercar/adaptation-microduck-replica/replica-repo/software/training/src/mjlab_microduck/robot/xl330_test_bench/assets/weight.stl

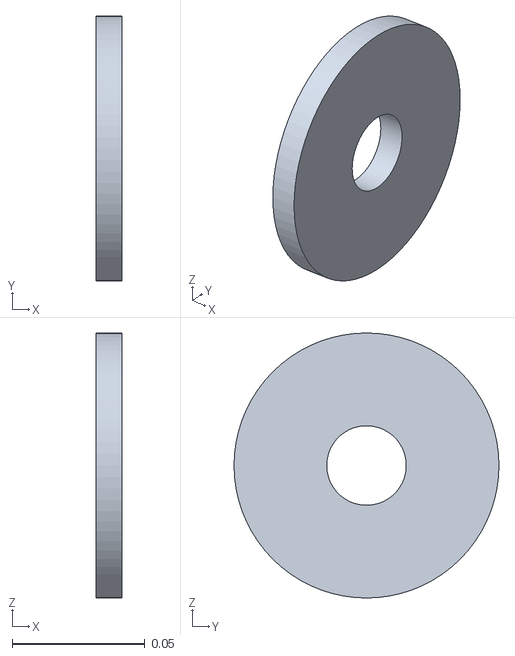
[picture p75: CAD file, 2026-10-23]
replica-repo/software/training/src/mjlab_microduck/robot/xl330_test_bench/assets/weight.stl
0.01 x 0.1 x 0.1
