Nhercar/adaptation-microduck-replica/step-files/yaw2roll_偏航转横滚-FT.STEP

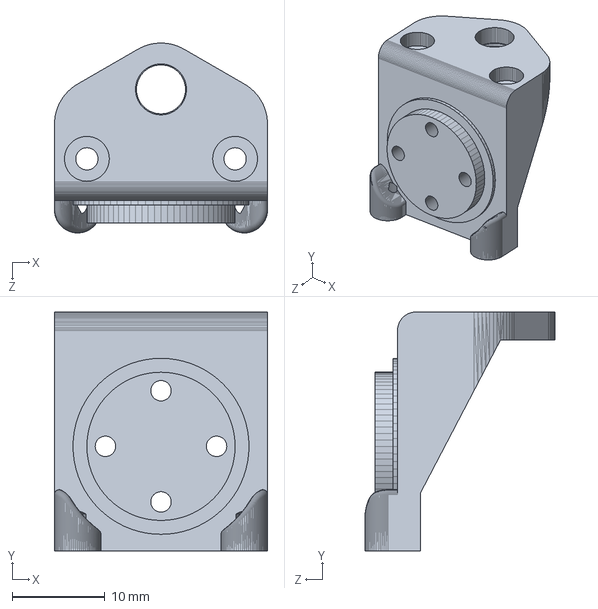
[picture p76: CAD file, 2026-10-23]
step-files/yaw2roll_偏航转横滚-FT.STEP
23.0 x 25.8 x 20.5 mm
