Nhercar/adaptation-microduck-replica/stl-files/12_neck_cuello.stl

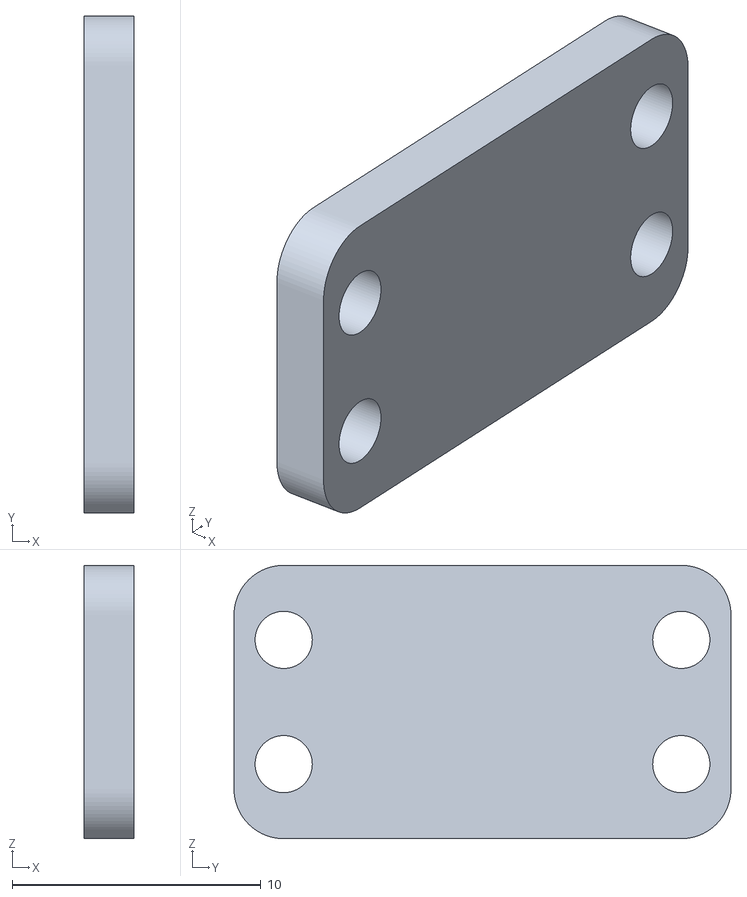
[picture p77: CAD file, 2026-10-23]
stl-files/12_neck_cuello.stl
2.00 x 20.0 x 11.0
