Nhercar/adaptation-microduck-replica/replica-repo/software/training/src/mjlab_microduck/robot/microduck/assets/pcb__raspberry_pi_zero_2_w.stl

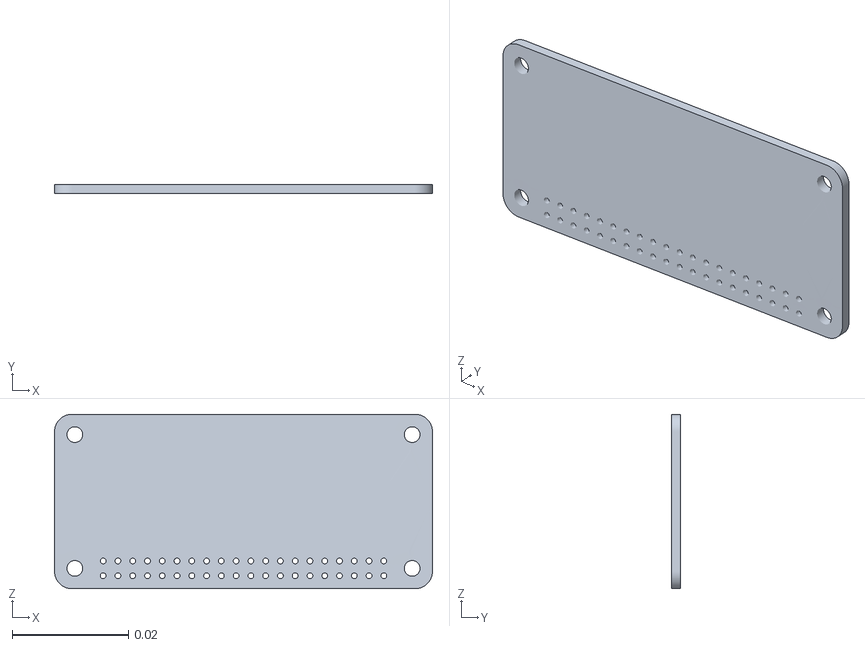
[picture p78: CAD file, 2026-10-23]
replica-repo/software/training/src/mjlab_microduck/robot/microduck/assets/pcb__raspberry_pi_zero_2_w.stl
0.065 x 0.0016 x 0.03
