Nhercar/adaptation-microduck-replica/replica-repo/software/training/src/mjlab_microduck/robot/xl330_test_bench/assets/part_3.stl

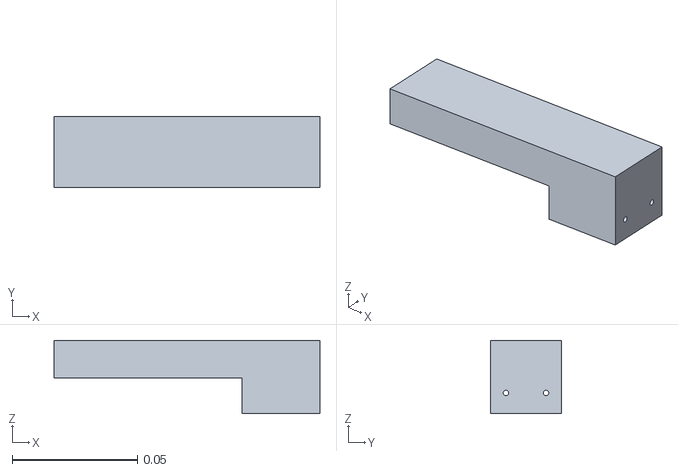
[picture p79: CAD file, 2026-10-23]
replica-repo/software/training/src/mjlab_microduck/robot/xl330_test_bench/assets/part_3.stl
0.106 x 0.0282 x 0.0292
