Nhercar/adaptation-microduck-replica/step-files/合体轮胎.STEP

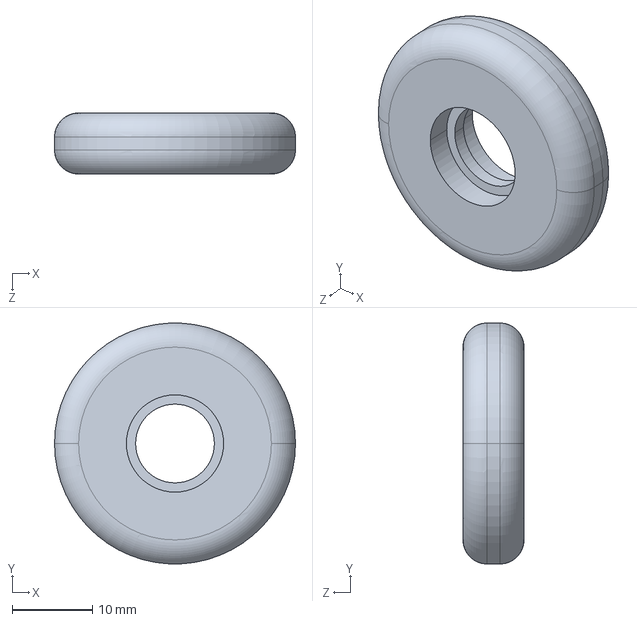
[picture p80: CAD file, 2026-10-23]
step-files/合体轮胎.STEP
30.0 x 30.0 x 7.60 mm
