Nhercar/adaptation-microduck-replica/stl-files/15_right_shell_carcasa_derecha.stl

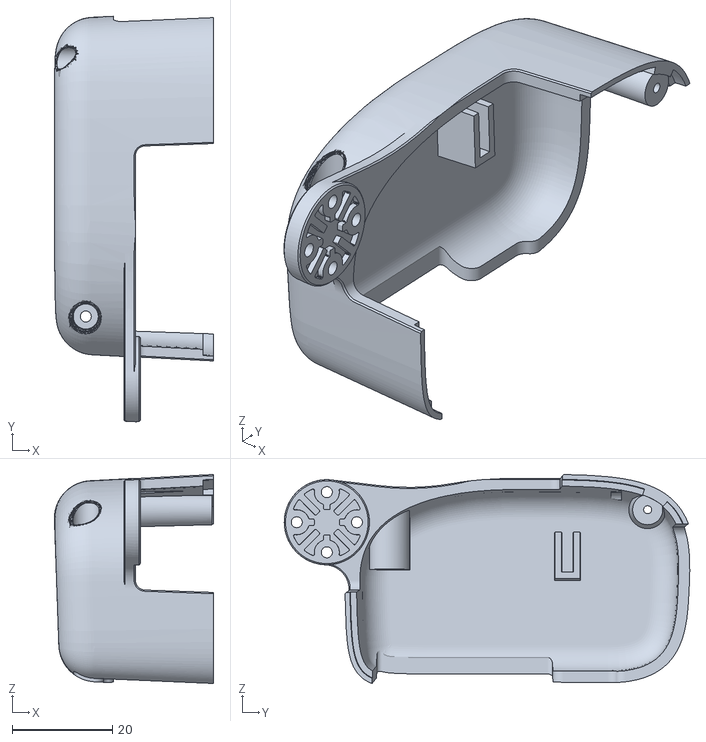
[picture p81: CAD file, 2026-10-23]
stl-files/15_right_shell_carcasa_derecha.stl
31.8 x 80.9 x 41.7
