Nhercar/adaptation-microduck-replica/replica-repo/software/training/src/mjlab_microduck/robot/microduck/assets/sole_right.stl

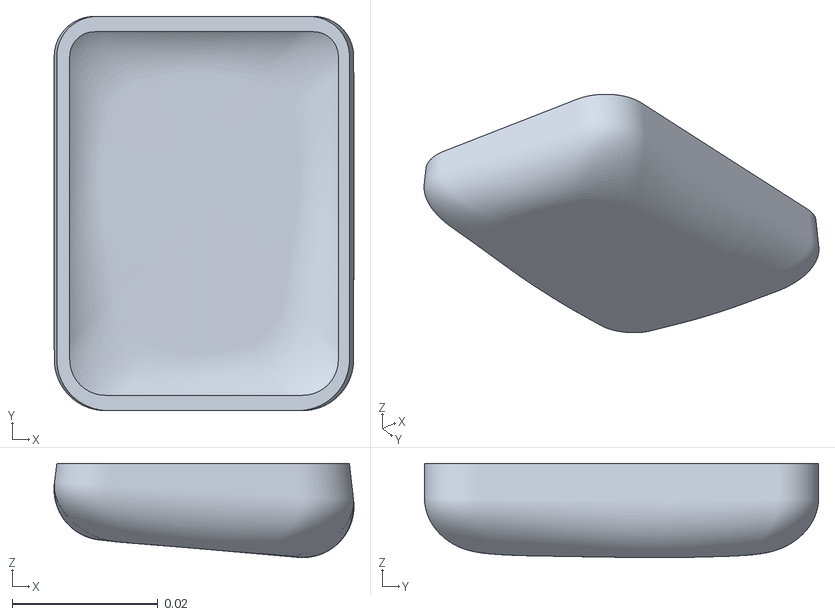
[picture p82: CAD file, 2026-10-23]
replica-repo/software/training/src/mjlab_microduck/robot/microduck/assets/sole_right.stl
0.0411 x 0.054 x 0.0129
