Nhercar/adaptation-microduck-replica/replica-repo/software/training/src/mjlab_microduck/robot/xl330_test_bench/assets/part_1.stl

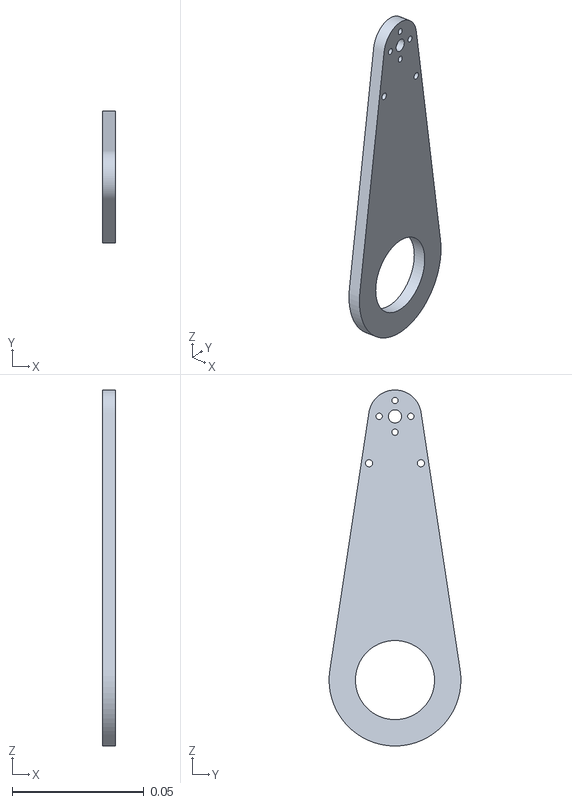
[picture p83: CAD file, 2026-10-23]
replica-repo/software/training/src/mjlab_microduck/robot/xl330_test_bench/assets/part_1.stl
0.005 x 0.05 x 0.135
