Nhercar/adaptation-microduck-replica/step-files/left_shell_左壳-FT.STEP

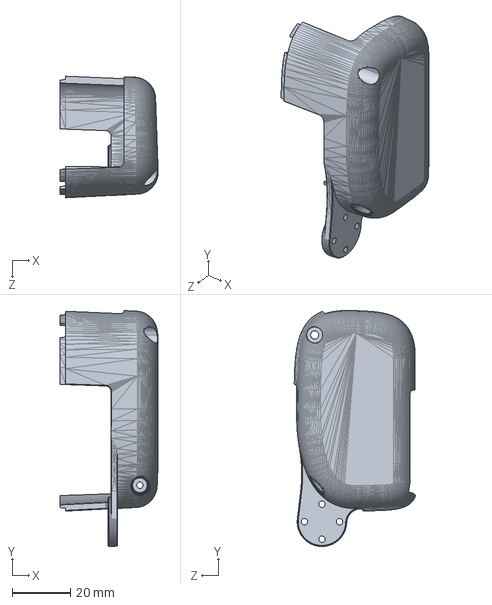
[picture p84: CAD file, 2026-10-23]
step-files/left_shell_左壳-FT.STEP
33.7 x 80.9 x 41.7 mm
