Nhercar/adaptation-microduck-replica/stl-files/01_ankle_l_v1_tobillo_izq_v1.stl

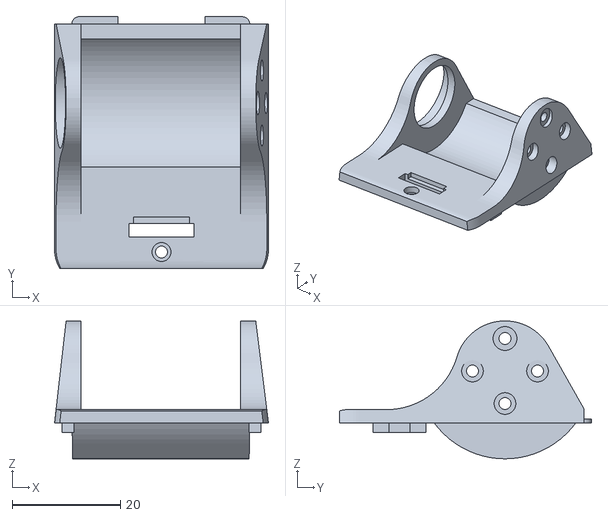
[picture p85: CAD file, 2026-10-23]
stl-files/01_ankle_l_v1_tobillo_izq_v1.stl
39.5 x 46.5 x 25.4
