Nhercar/adaptation-microduck-replica/step-files/face_part_面部零件-FT1适配瑞莎原版摄像头 改了孔距.STEP

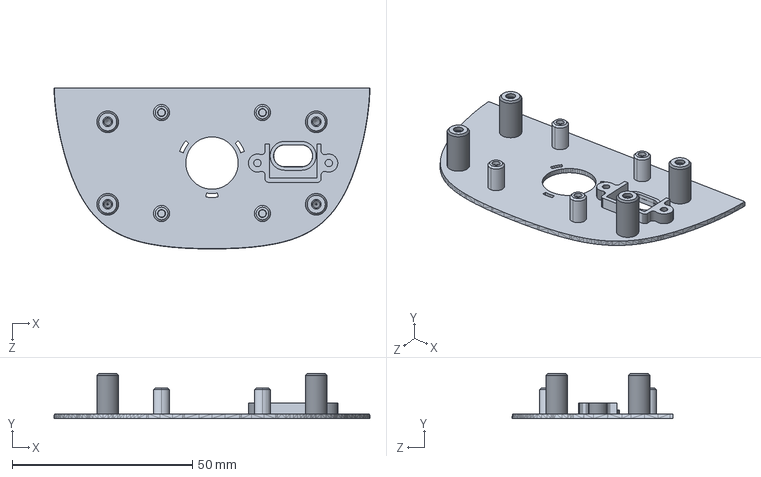
[picture p88: CAD file, 2026-10-23]
step-files/face_part_面部零件-FT1适配瑞莎原版摄像头 改了孔距.STEP
87.7 x 12.5 x 44.6 mm
