Nhercar/adaptation-microduck-replica/stl-files/14_power_support_soporte_bateria.stl

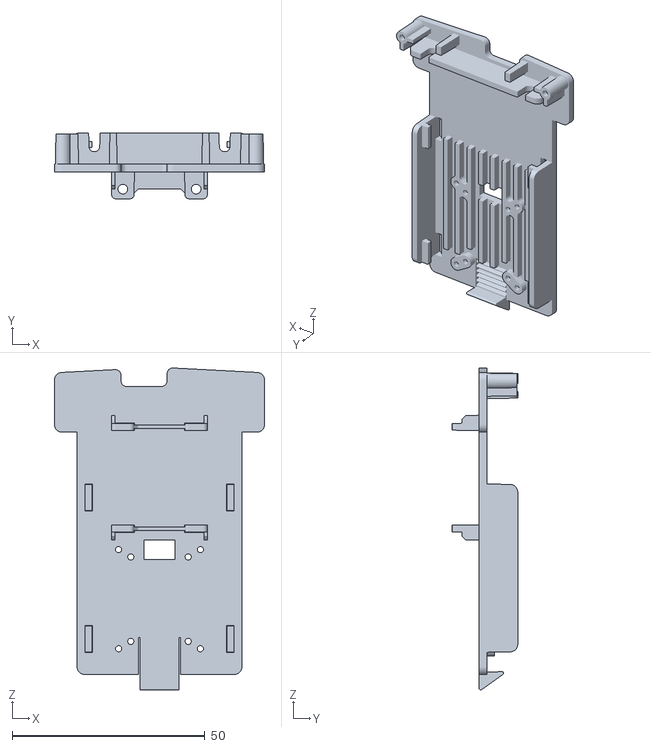
[picture p89: CAD file, 2026-10-23]
stl-files/14_power_support_soporte_bateria.stl
54.5 x 17.0 x 83.5
