Nhercar/adaptation-microduck-replica/replica-repo/software/training/src/mjlab_microduck/robot/microduck/assets/trunk_shell_left.stl

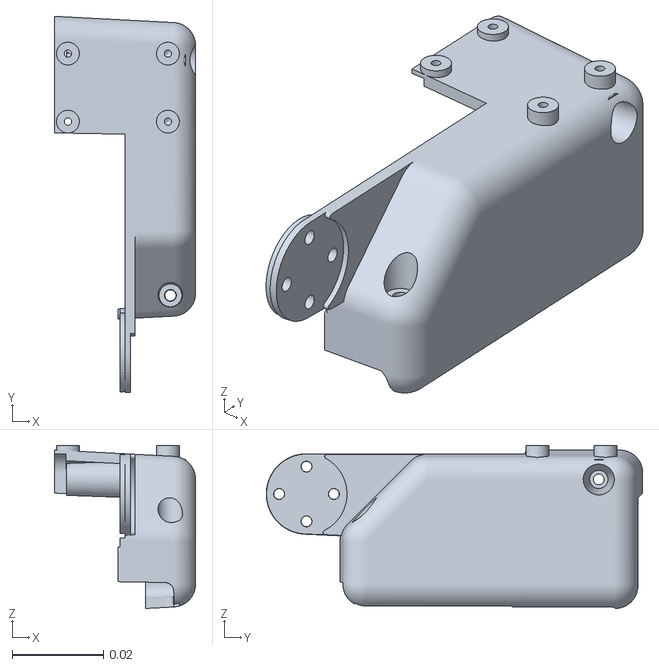
[picture p90: CAD file, 2026-10-23]
replica-repo/software/training/src/mjlab_microduck/robot/microduck/assets/trunk_shell_left.stl
0.0309 x 0.0824 x 0.0357
