Nhercar/adaptation-microduck-replica/stl-files/13_eyes_noenoeil_ojos.stl

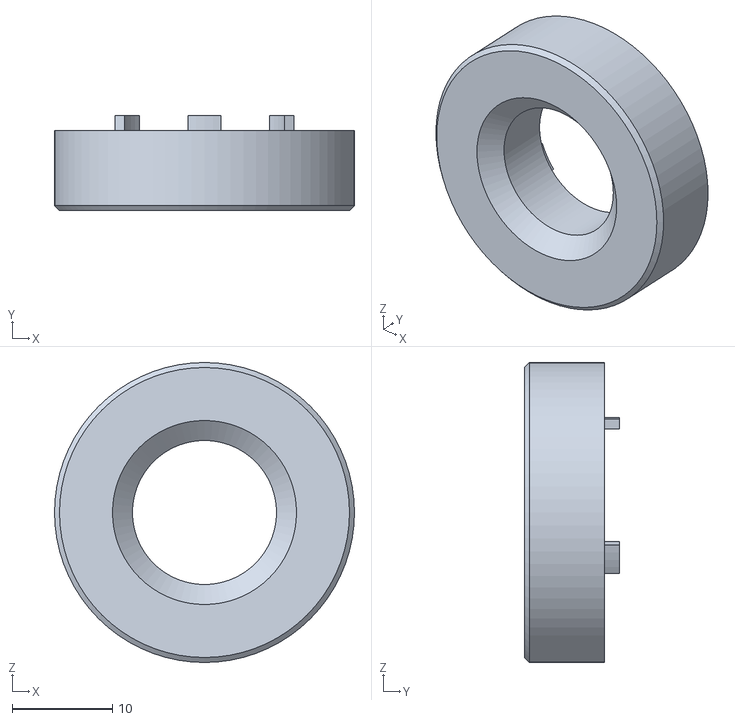
[picture p91: CAD file, 2026-10-23]
stl-files/13_eyes_noenoeil_ojos.stl
30.0 x 9.50 x 30.0
