Nhercar/adaptation-microduck-replica/replica-repo/software/training/src/mjlab_microduck/robot/microduck/assets/top_head_shell.stl

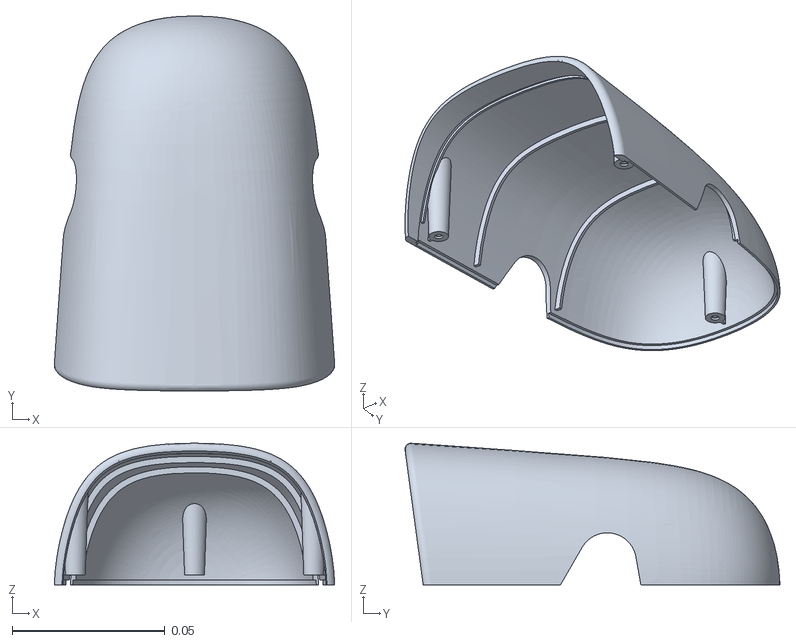
[picture p92: CAD file, 2026-10-23]
replica-repo/software/training/src/mjlab_microduck/robot/microduck/assets/top_head_shell.stl
0.0918 x 0.123 x 0.0463
