Nhercar/adaptation-microduck-replica/step-files/01-upper_leg_rigidity_plate_上腿加固板-FT.STEP

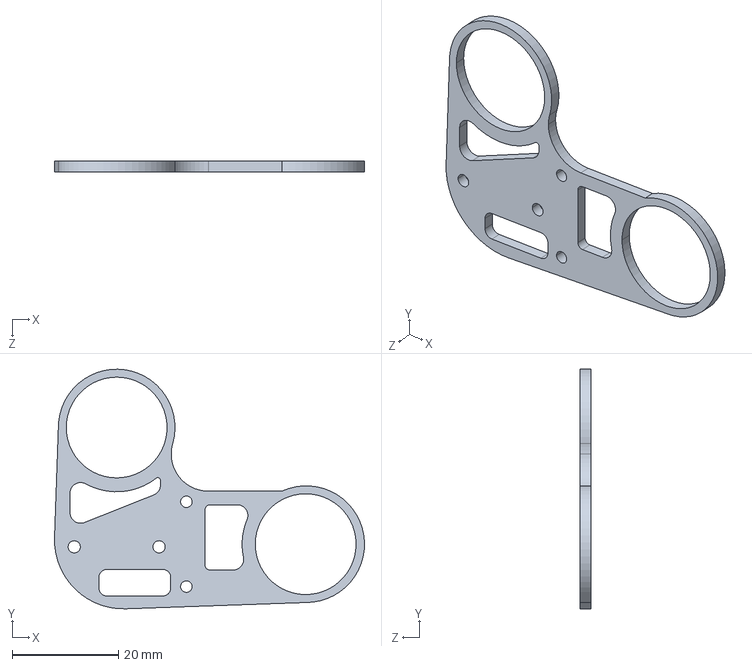
[picture p93: CAD file, 2026-10-23]
step-files/01-upper_leg_rigidity_plate_上腿加固板-FT.STEP
58.5 x 45.2 x 2.00 mm
