Nhercar/adaptation-microduck-replica/stl-files/06_foot_right_pie_derecho.stl

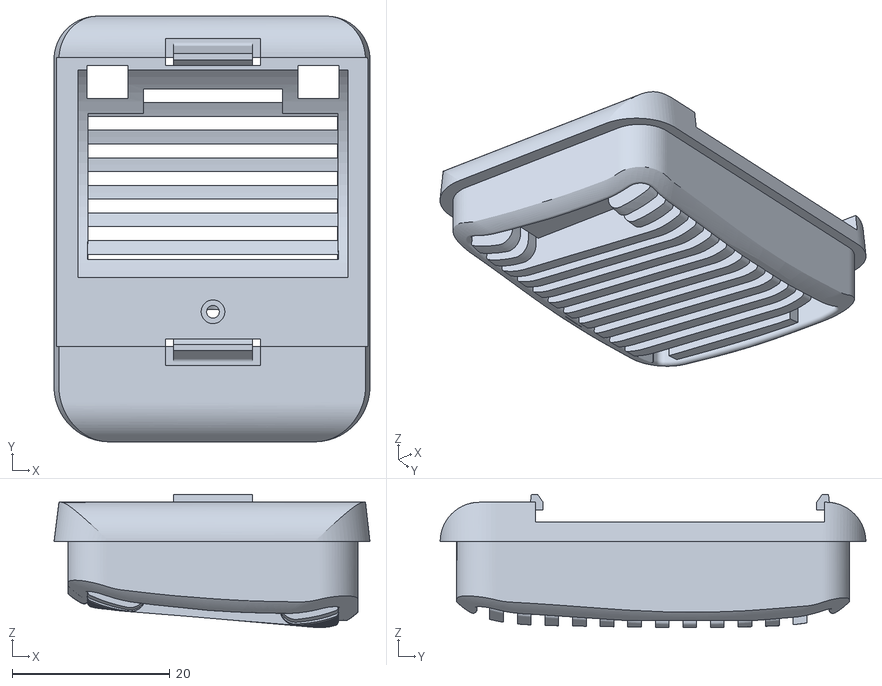
[picture p94: CAD file, 2026-10-23]
stl-files/06_foot_right_pie_derecho.stl
40.1 x 54.0 x 16.9
