Nhercar/adaptation-microduck-replica/step-files/bearing_roll_轴承滚轮-FT.STEP

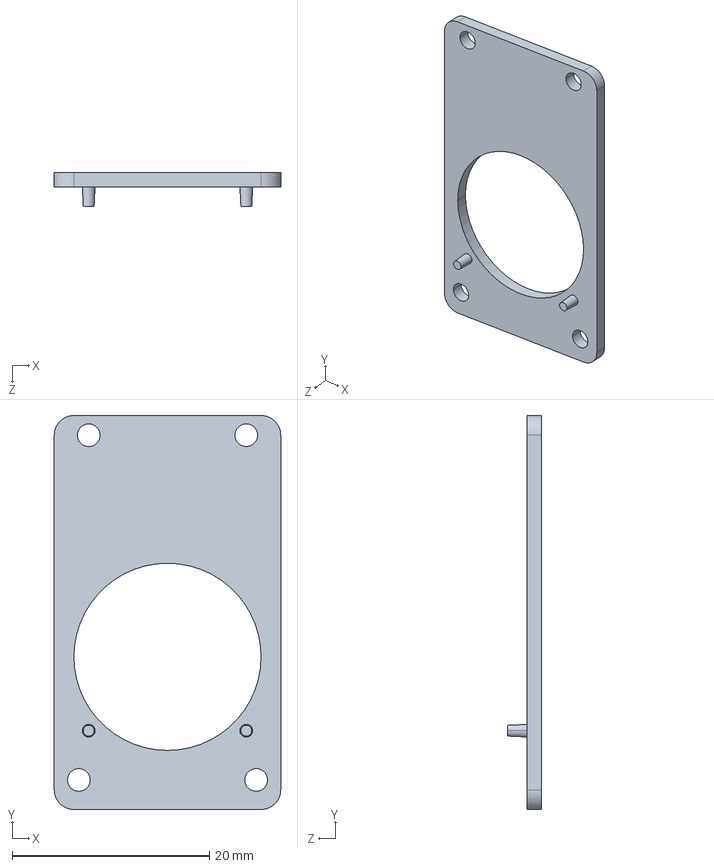
[picture p96: CAD file, 2026-10-23]
step-files/bearing_roll_轴承滚轮-FT.STEP
23.0 x 40.0 x 3.50 mm
