Nhercar/adaptation-microduck-replica/stl-files/03_banana_pcb_locker_cierre_pcb.stl

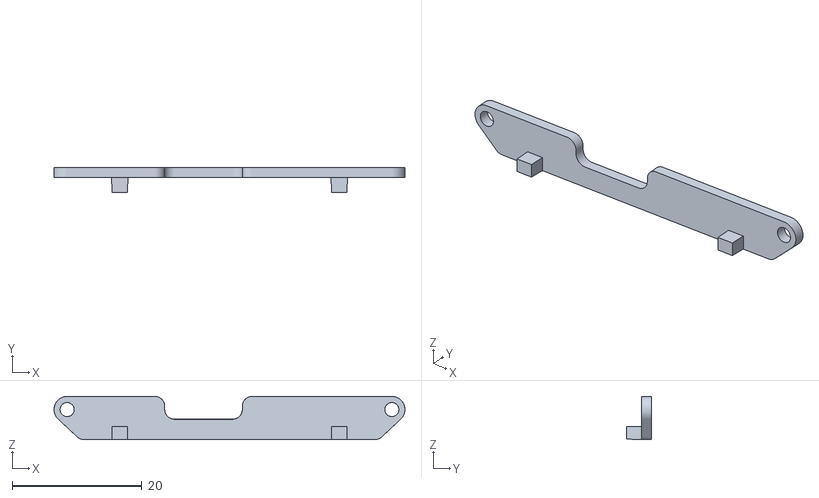
[picture p97: CAD file, 2026-10-23]
stl-files/03_banana_pcb_locker_cierre_pcb.stl
54.1 x 3.80 x 6.65
