Nhercar/adaptation-microduck-replica/replica-repo/software/training/src/mjlab_microduck/robot/microduck/assets/ankle_left.stl

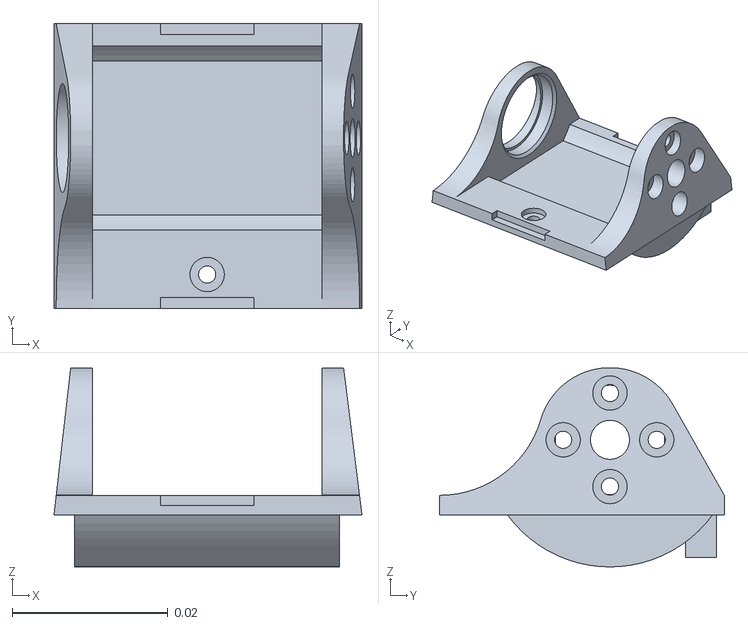
[picture p98: CAD file, 2026-10-23]
replica-repo/software/training/src/mjlab_microduck/robot/microduck/assets/ankle_left.stl
0.0395 x 0.0365 x 0.0255
