Nhercar/adaptation-microduck-replica/step-files/leg_腿部-FT.STEP

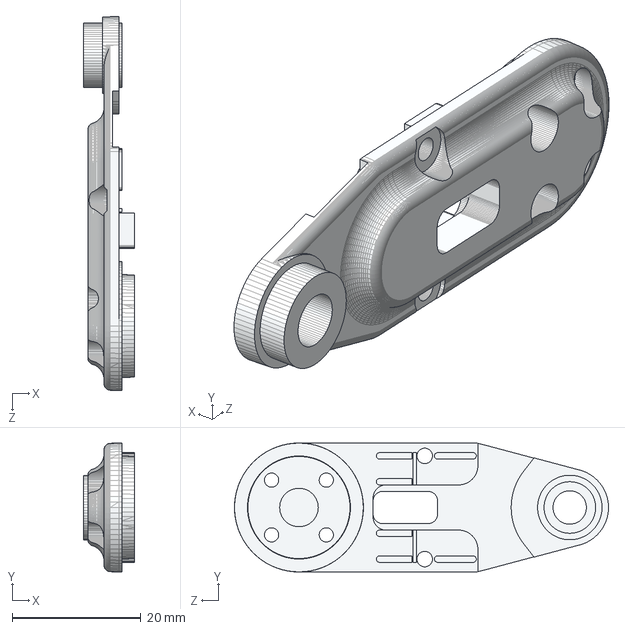
[picture p99: CAD file, 2026-10-23]
step-files/leg_腿部-FT.STEP
7.95 x 20.0 x 58.0 mm
