Nhercar/adaptation-microduck-replica/stl-files/24_yaw_roll_motion_movimiento_cuello.stl

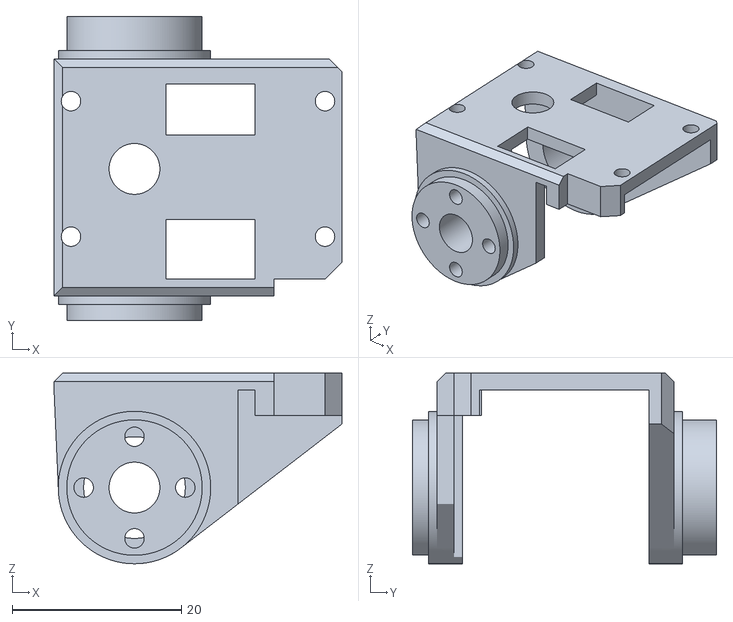
[picture p100: CAD file, 2026-10-23]
stl-files/24_yaw_roll_motion_movimiento_cuello.stl
34.0 x 35.9 x 22.5
