Nhercar/adaptation-microduck-replica/replica-repo/software/training/src/mjlab_microduck/robot/microduck/assets/m12_lens_holder.stl

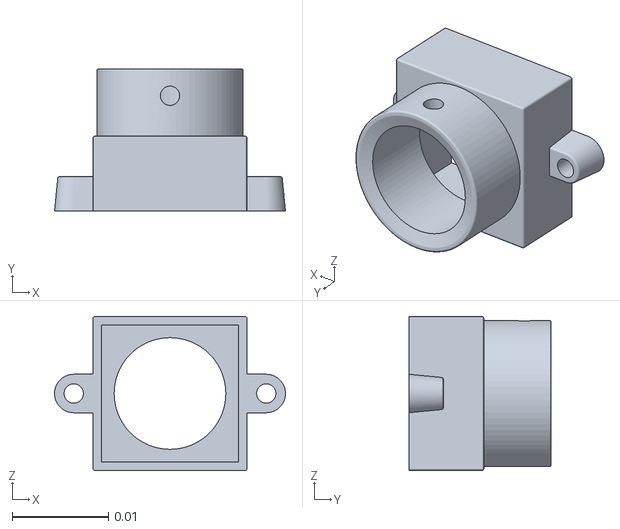
[picture p101: CAD file, 2026-10-23]
replica-repo/software/training/src/mjlab_microduck/robot/microduck/assets/m12_lens_holder.stl
0.024 x 0.0148 x 0.016
