Nhercar/adaptation-microduck-replica/step-files/top_head_shell_头部上壳-FT.STEP

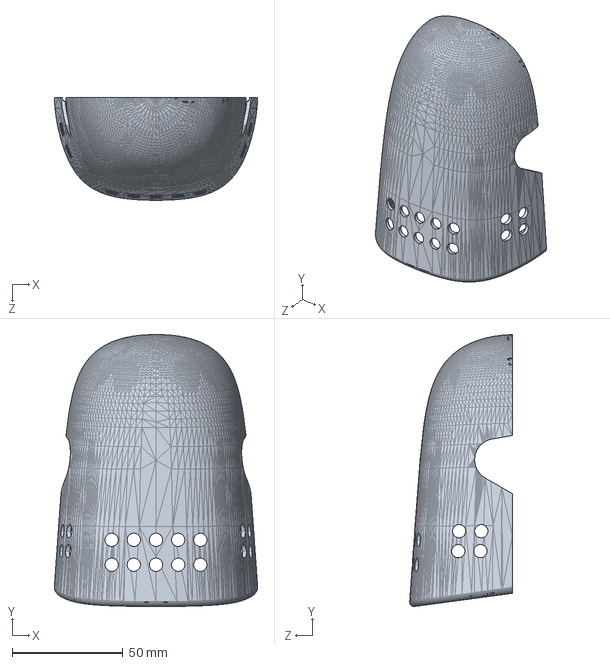
[picture p102: CAD file, 2026-10-23]
step-files/top_head_shell_头部上壳-FT.STEP
91.8 x 122.7 x 46.3 mm
