Nhercar/adaptation-microduck-replica/stl-files/21_ankle_right_tobillo_derecho.stl

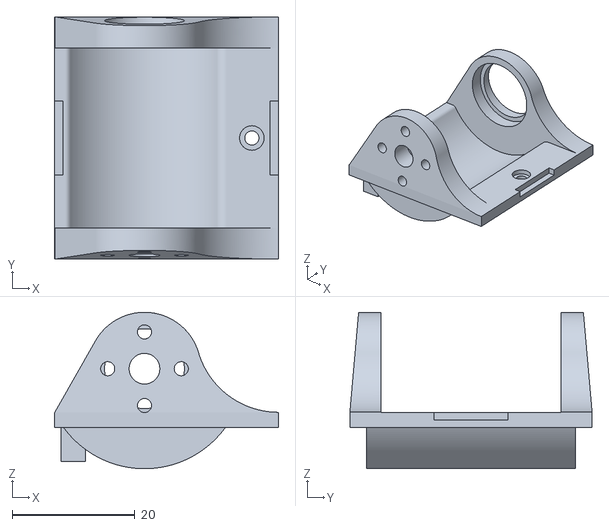
[picture p104: CAD file, 2026-10-23]
stl-files/21_ankle_right_tobillo_derecho.stl
36.5 x 39.5 x 25.5
