Nhercar/adaptation-microduck-replica/replica-repo/software/training/src/mjlab_microduck/robot/microduck/assets/jaw_soft.stl

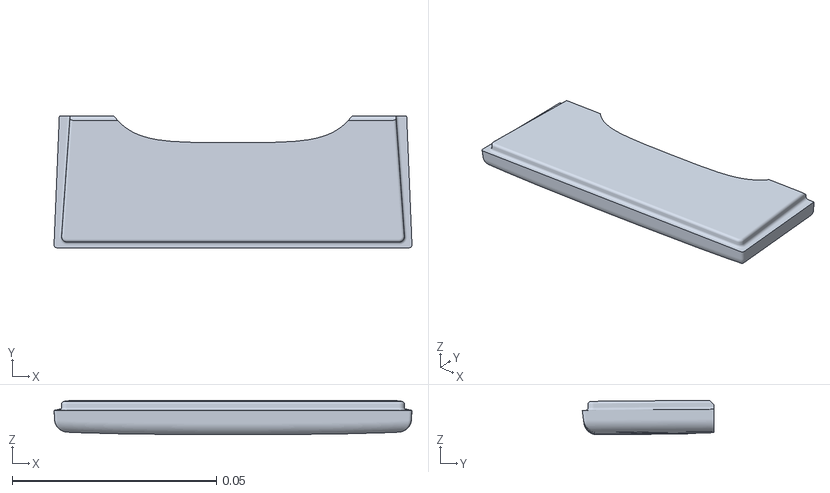
[picture p105: CAD file, 2026-10-23]
replica-repo/software/training/src/mjlab_microduck/robot/microduck/assets/jaw_soft.stl
0.0877 x 0.0322 x 0.00844
