Nhercar/adaptation-microduck-replica/replica-repo/software/training/src/mjlab_microduck/robot/microduck/assets/bearing_roll.stl

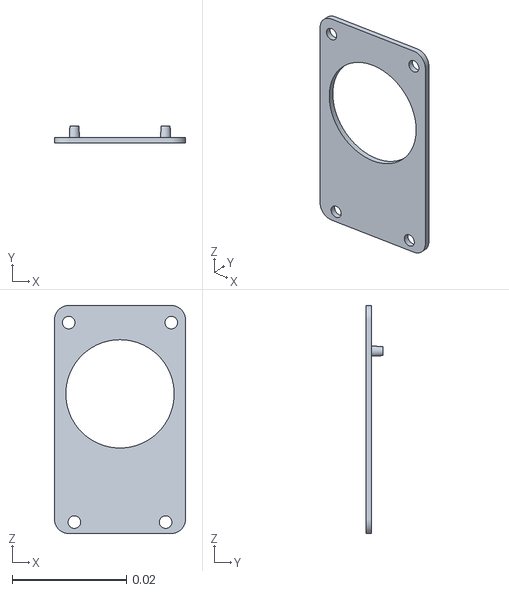
[picture p107: CAD file, 2026-10-23]
replica-repo/software/training/src/mjlab_microduck/robot/microduck/assets/bearing_roll.stl
0.023 x 0.003 x 0.04
