Nhercar/adaptation-microduck-replica/replica-repo/software/training/src/mjlab_microduck/robot/microduck/assets/seeed_bearing__configuration_default.stl

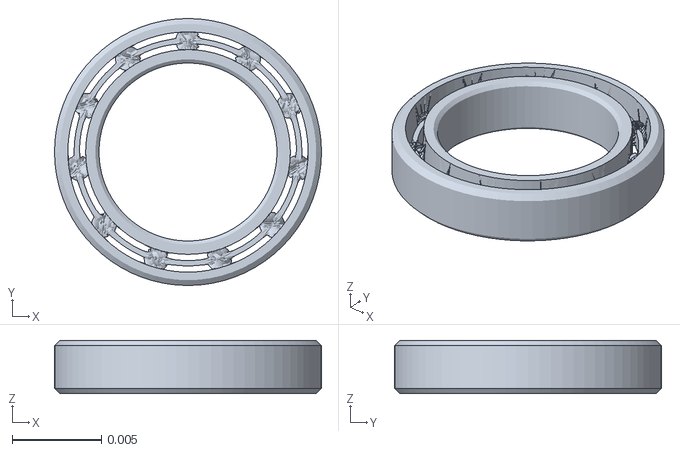
[picture p109: CAD file, 2026-10-23]
replica-repo/software/training/src/mjlab_microduck/robot/microduck/assets/seeed_bearing__configuration_default.stl
0.015 x 0.015 x 0.003
