Nhercar/adaptation-microduck-replica/replica-repo/software/training/src/mjlab_microduck/robot/microduck/assets/yaw_roll_motion.stl

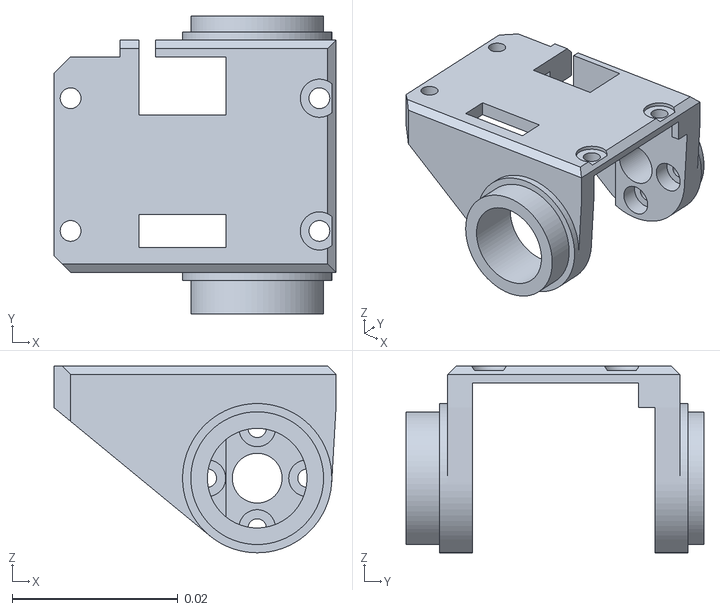
[picture p110: CAD file, 2026-10-23]
replica-repo/software/training/src/mjlab_microduck/robot/microduck/assets/yaw_roll_motion.stl
0.034 x 0.0359 x 0.0225
