Nhercar/adaptation-microduck-replica/replica-repo/software/training/src/mjlab_microduck/robot/microduck/assets/trunk_shell_right.stl

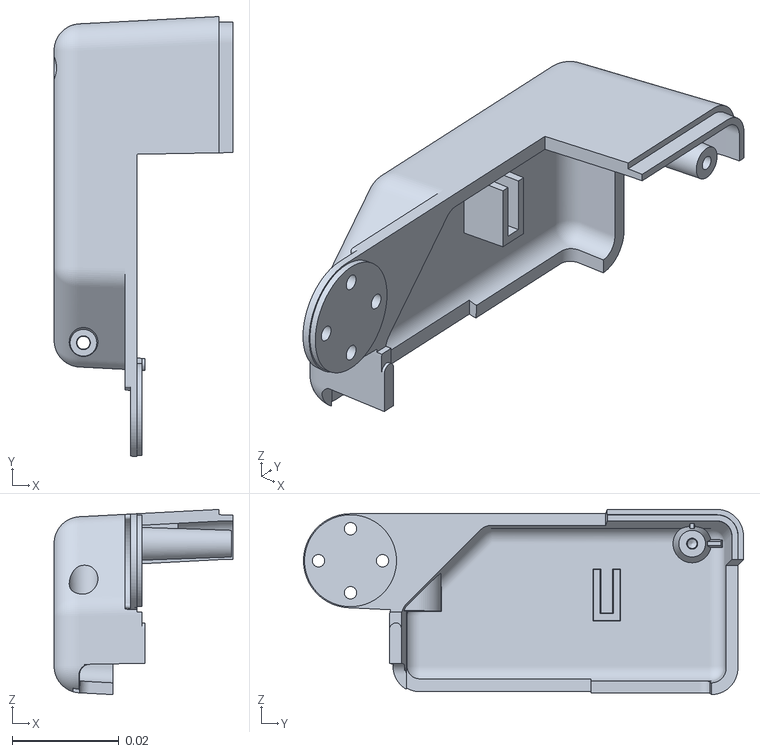
[picture p111: CAD file, 2026-10-23]
replica-repo/software/training/src/mjlab_microduck/robot/microduck/assets/trunk_shell_right.stl
0.0335 x 0.0824 x 0.0347
