Nhercar/adaptation-microduck-replica/stl-files/10_motor_support_soporte_servo.stl

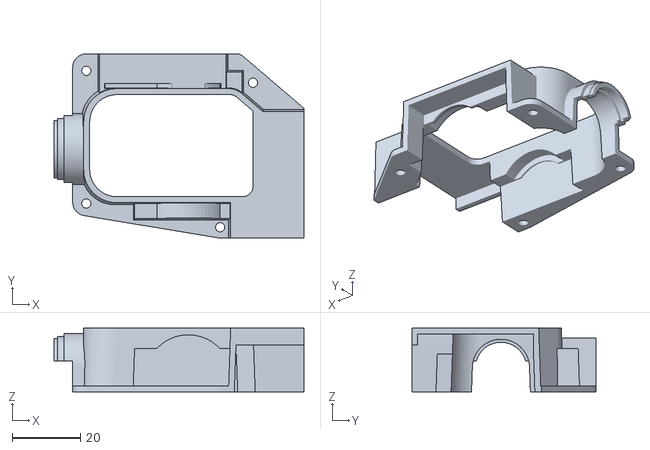
[picture p112: CAD file, 2026-10-23]
stl-files/10_motor_support_soporte_servo.stl
73.5 x 54.2 x 18.8
