Nhercar/adaptation-microduck-replica/replica-repo/software/training/src/mjlab_microduck/robot/microduck/assets/neck_pitch.stl

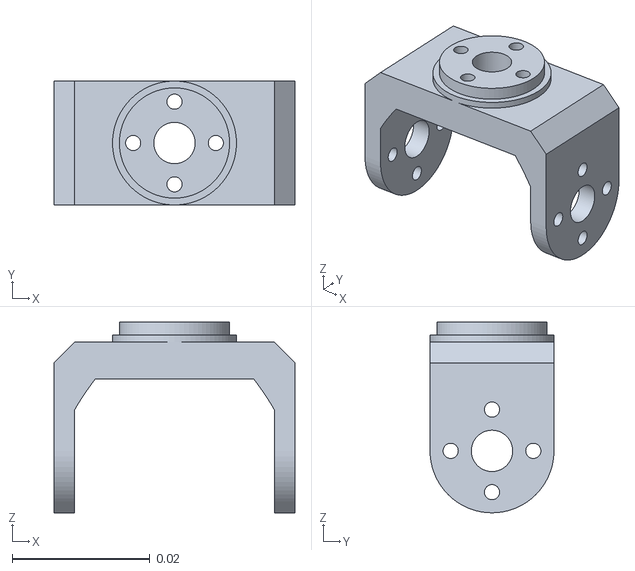
[picture p113: CAD file, 2026-10-23]
replica-repo/software/training/src/mjlab_microduck/robot/microduck/assets/neck_pitch.stl
0.035 x 0.018 x 0.0277
