Nhercar/adaptation-microduck-replica/replica-repo/software/training/src/mjlab_microduck/robot/microduck/assets/yaw2roll.stl

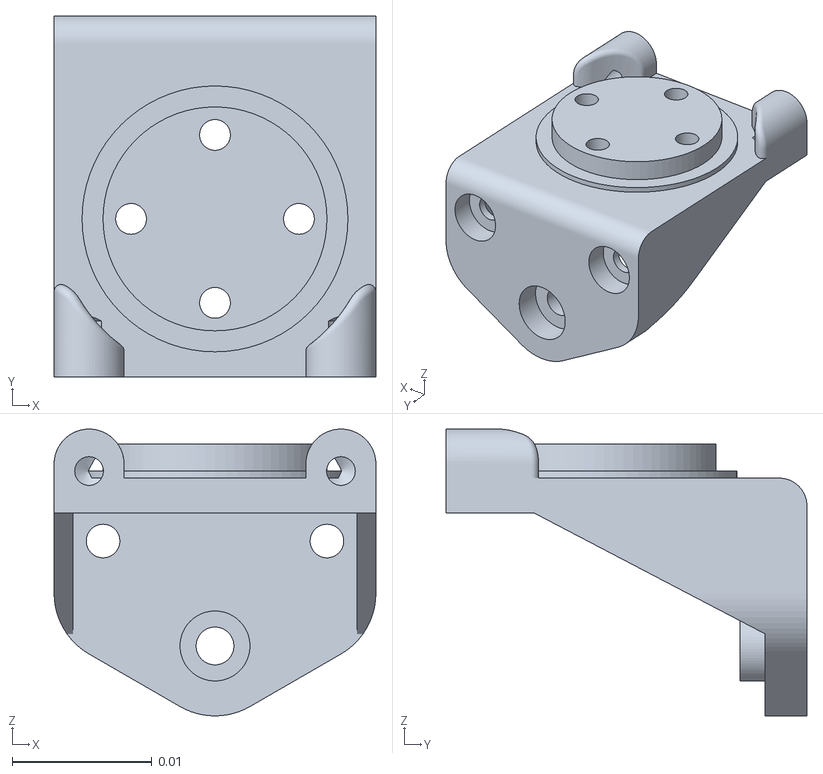
[picture p114: CAD file, 2026-10-23]
replica-repo/software/training/src/mjlab_microduck/robot/microduck/assets/yaw2roll.stl
0.023 x 0.0258 x 0.0205
