Nhercar/adaptation-microduck-replica/stl-files/04_bottom_head_shell_cabeza_inferior.stl

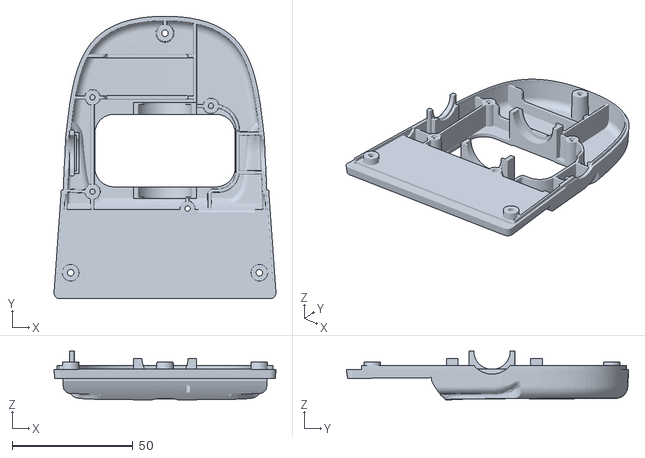
[picture p117: CAD file, 2026-10-23]
stl-files/04_bottom_head_shell_cabeza_inferior.stl
91.8 x 116.7 x 20.1
