Nhercar/adaptation-microduck-replica/replica-repo/software/training/src/mjlab_microduck/robot/microduck/assets/seeed_bearing__configuration__22x16x4.stl

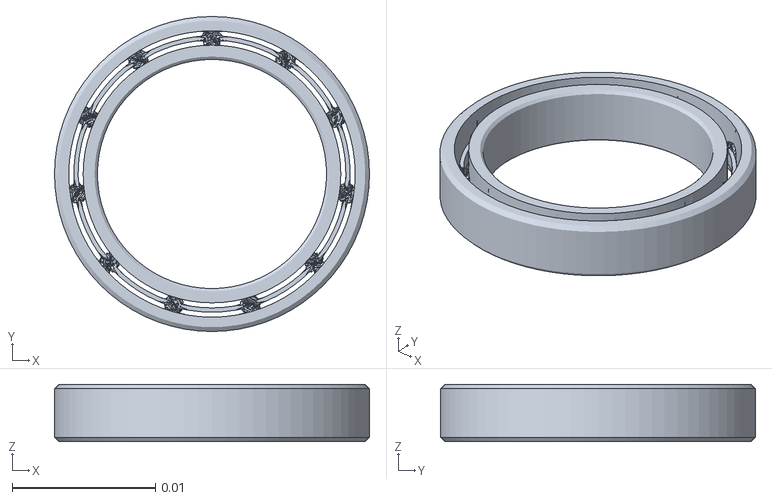
[picture p118: CAD file, 2026-10-23]
replica-repo/software/training/src/mjlab_microduck/robot/microduck/assets/seeed_bearing__configuration__22x16x4.stl
0.022 x 0.022 x 0.004
