Nhercar/adaptation-microduck-replica/stl-files/29_trunk_base_chasis_torso.stl

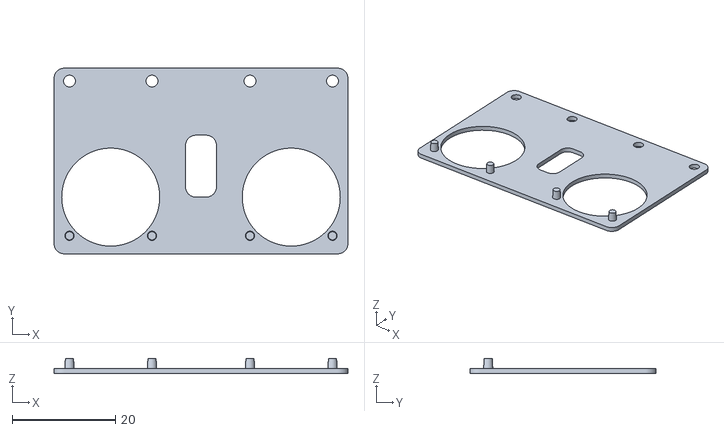
[picture p119: CAD file, 2026-10-23]
stl-files/29_trunk_base_chasis_torso.stl
57.0 x 36.0 x 3.00
