Nhercar/adaptation-microduck-replica/stl-files/09_jaw_mandibula_rigida.stl

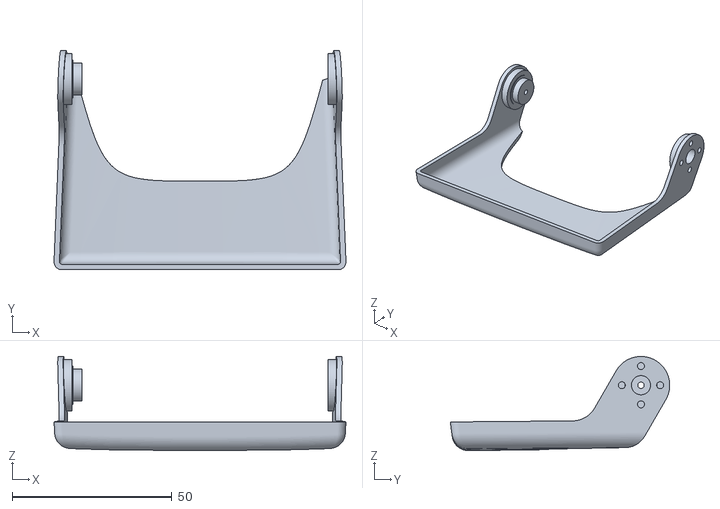
[picture p121: CAD file, 2026-10-23]
stl-files/09_jaw_mandibula_rigida.stl
91.4 x 68.7 x 29.4
