Nhercar/adaptation-microduck-replica/stl-files/20_face_part_frontal_camara.stl

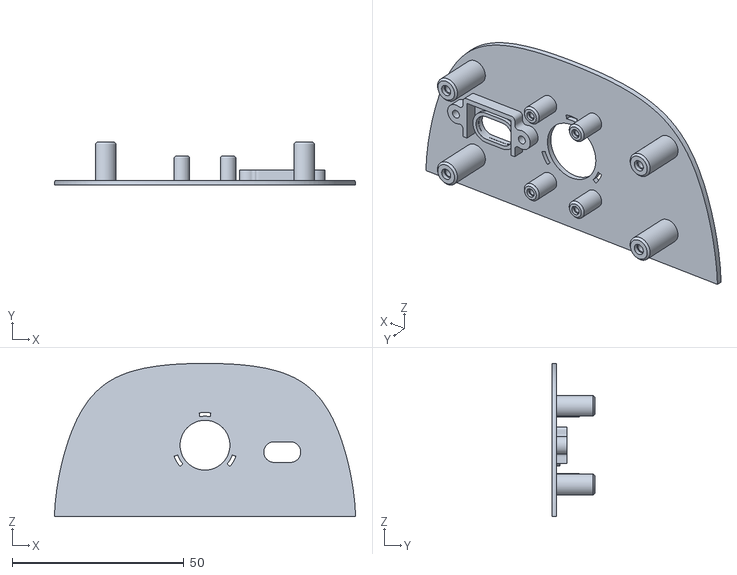
[picture p123: CAD file, 2026-10-23]
stl-files/20_face_part_frontal_camara.stl
87.7 x 12.5 x 44.6
