Nhercar/adaptation-microduck-replica/stl-files/08_jaw_soft_pico_inferior_TPU.stl

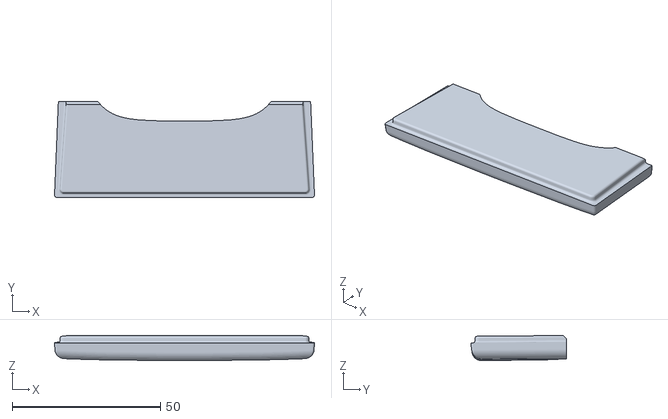
[picture p126: CAD file, 2026-10-23]
stl-files/08_jaw_soft_pico_inferior_TPU.stl
87.7 x 32.2 x 8.44
