Nhercar/adaptation-microduck-replica/stl-files/11_neck_pitch_cuello_inclinacion.stl

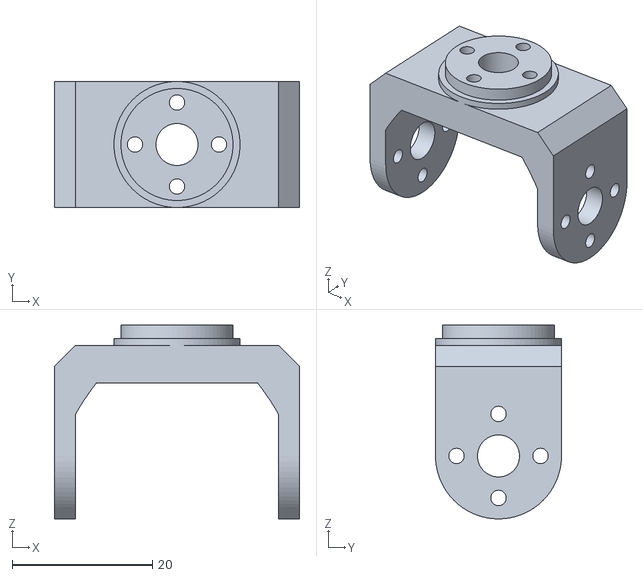
[picture p129: CAD file, 2026-10-23]
stl-files/11_neck_pitch_cuello_inclinacion.stl
35.0 x 18.0 x 27.7
