Nhercar/adaptation-microduck-replica/replica-repo/software/training/src/mjlab_microduck/robot/microduck/assets/banana_pcb_locker.stl

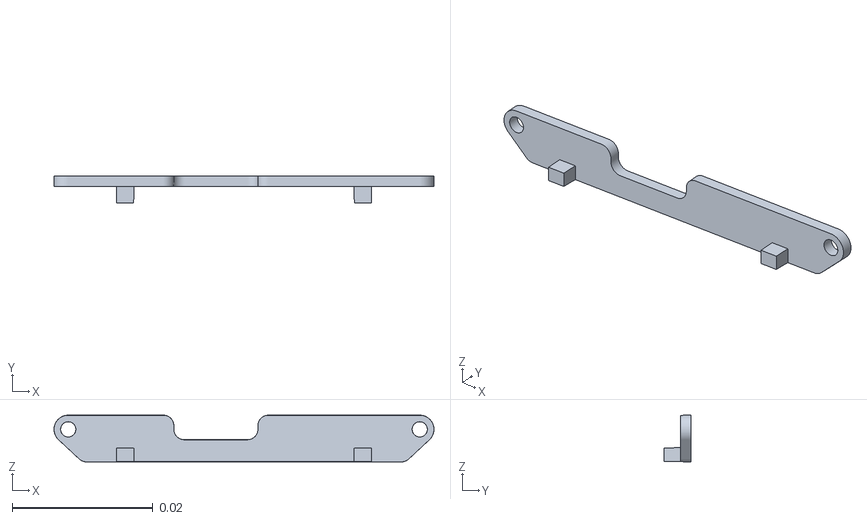
[picture p130: CAD file, 2026-10-23]
replica-repo/software/training/src/mjlab_microduck/robot/microduck/assets/banana_pcb_locker.stl
0.0541 x 0.0038 x 0.00665
