Nhercar/adaptation-microduck-replica/stl-files/17_soft_mouth_top_pico_superior_TPU.stl

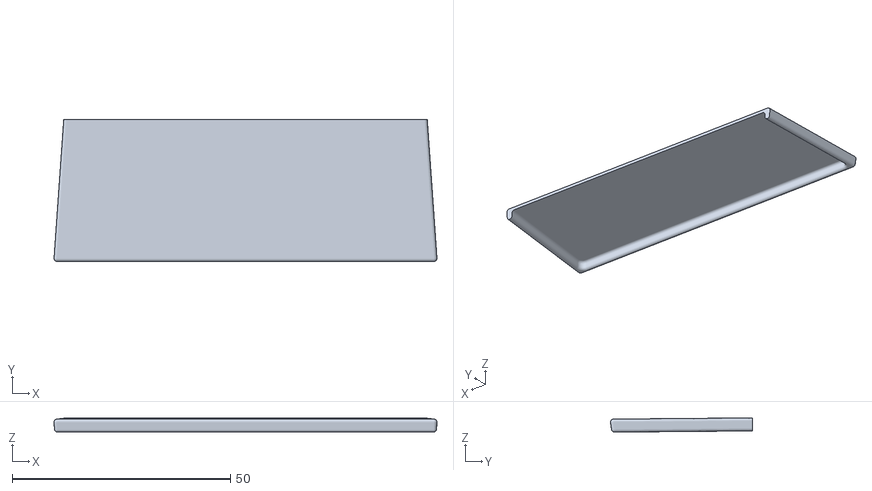
[picture p131: CAD file, 2026-10-23]
stl-files/17_soft_mouth_top_pico_superior_TPU.stl
87.8 x 32.6 x 3.28
