Nhercar/adaptation-microduck-replica/stl-files/16_roller_blade_soporte_patin.stl

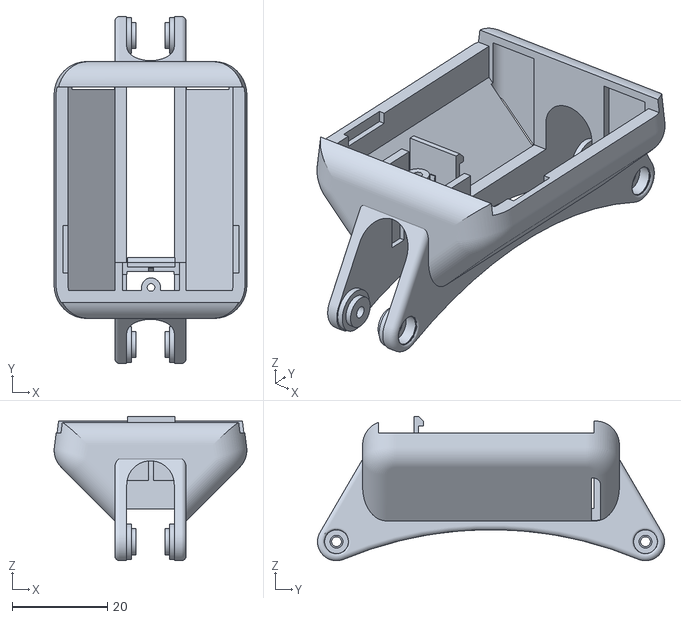
[picture p133: CAD file, 2026-10-23]
stl-files/16_roller_blade_soporte_patin.stl
40.5 x 73.0 x 30.4
