Nhercar/adaptation-microduck-replica/replica-repo/software/training/src/mjlab_microduck/robot/microduck/assets/ankle_r_v1.stl

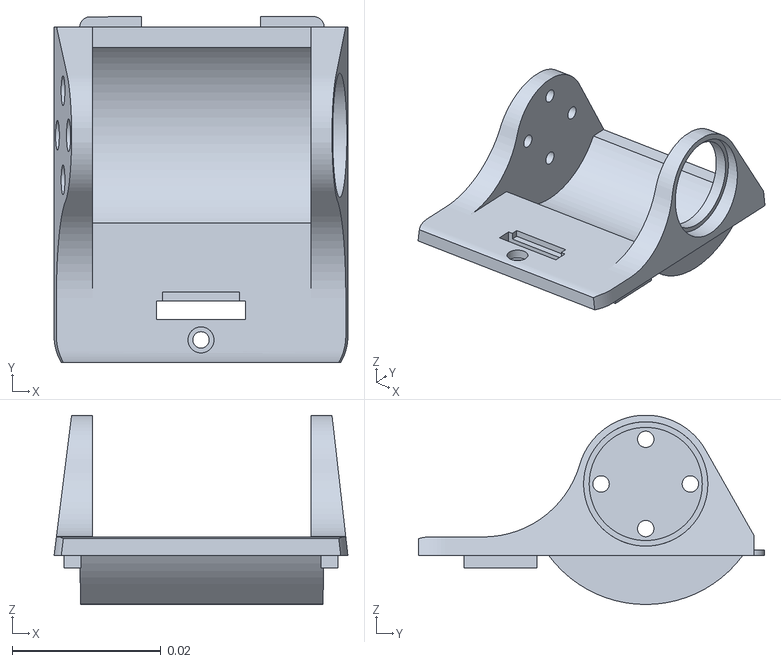
[picture p134: CAD file, 2026-10-23]
replica-repo/software/training/src/mjlab_microduck/robot/microduck/assets/ankle_r_v1.stl
0.0395 x 0.0465 x 0.0254
