Nhercar/adaptation-microduck-replica/replica-repo/software/training/src/mjlab_microduck/robot/microduck/assets/soft_mouth_top.stl

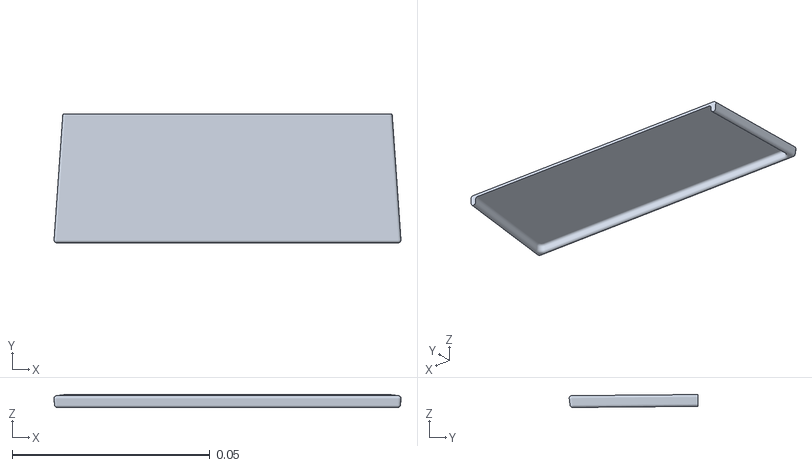
[picture p138: CAD file, 2026-10-23]
replica-repo/software/training/src/mjlab_microduck/robot/microduck/assets/soft_mouth_top.stl
0.0878 x 0.0326 x 0.00328
