Nhercar/adaptation-microduck-replica/replica-repo/software/training/src/mjlab_microduck/robot/microduck/assets/upper_leg_rigidity_plate.stl

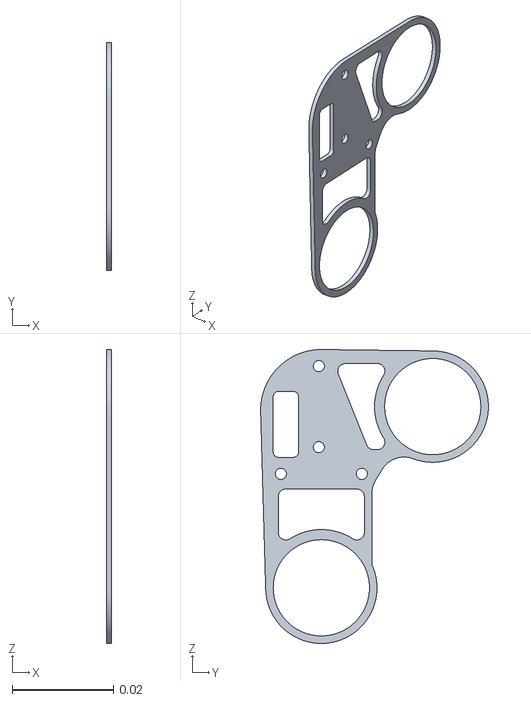
[picture p139: CAD file, 2026-10-23]
replica-repo/software/training/src/mjlab_microduck/robot/microduck/assets/upper_leg_rigidity_plate.stl
0.001 x 0.045 x 0.0581
