Nhercar/adaptation-microduck-replica/replica-repo/software/training/src/mjlab_microduck/robot/microduck/assets/bottom_head_shell.stl

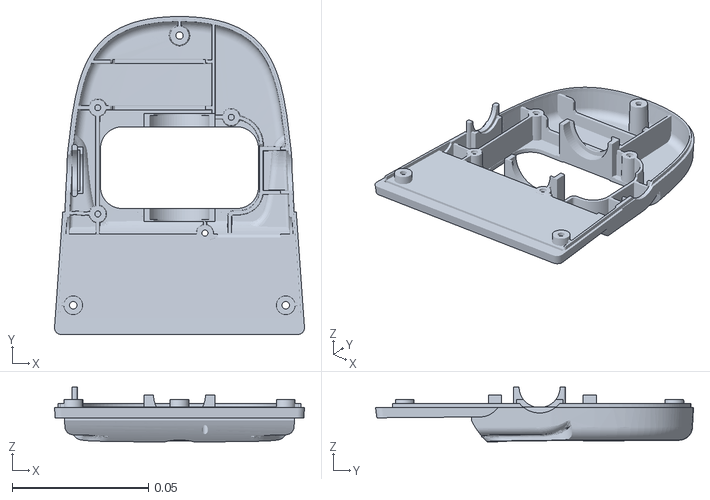
[picture p141: CAD file, 2026-10-23]
replica-repo/software/training/src/mjlab_microduck/robot/microduck/assets/bottom_head_shell.stl
0.0918 x 0.117 x 0.0201
