Nhercar/adaptation-microduck-replica/(list of files, cad)

Other CAD files:
step-files/right_upper_leg_右上腿-FT.STEP
stl-files/27_wheel_tire_rueda_patin_TPU.stl
step-files/ankle_left_脚踝左-FT.STEP
stl-files/23_upper_leg_rigidity_plate_refuerzo_muslo.stl
stl-files/05_foot_left_pie_izquierdo.stl
stl-files/22_ankle_left_tobillo_izquierdo.stl
stl-files/25_leg_pierna_espinilla.stl
stl-files/31_left_upper_leg_muslo_izquierdo.stl
stl-files/02_ankle_r_v1_tobillo_der_v1.stl
stl-files/18_sole_left_suela_izquierda.stl
stl-files/33_left_shell_carcasa_izquierda.stl
stl-files/28_bearing_roll_soporte_rodamiento.stl
replica-repo/software/training/src/mjlab_microduck/robot/microduck/assets/right_upper_leg.stl
stl-files/26_yaw2roll_articulacion_cadera.stl
stl-files/32_right_upper_leg_muslo_derecho.stl
stl-files/30_top_head_shell_cabeza_superior.stl
replica-repo/software/training/src/mjlab_microduck/robot/microduck/assets/ankle_right.stl
replica-repo/software/training/src/mjlab_microduck/robot/microduck/assets/ankle_l_v1.stl
replica-repo/software/training/src/mjlab_microduck/robot/microduck/assets/sole_left.stl
replica-repo/software/training/src/mjlab_microduck/robot/microduck/assets/upper_leg_right.stl
replica-repo/software/training/src/mjlab_microduck/robot/microduck/assets/foot_left.stl
