Nhercar/adaptation-microduck-replica/cad-repo/组件图/00-microduck装配体2.png

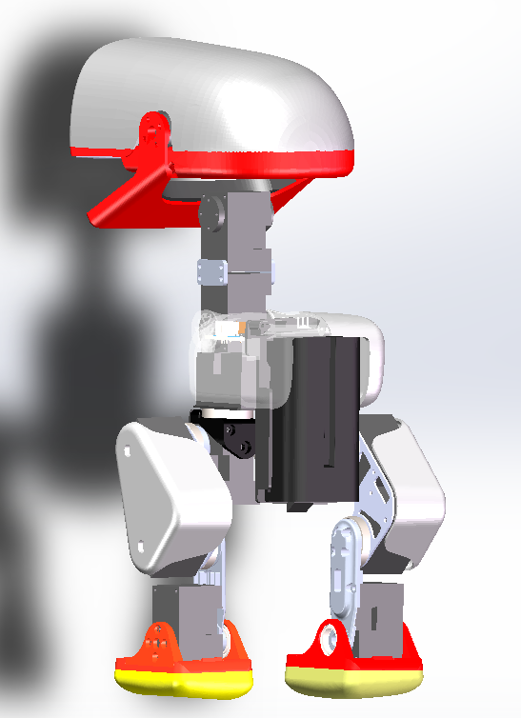
cad-repo/组件图/00-microduck装配体2.png
