Nhercar/adaptation-microduck-replica/cad-repo/组件图/00-microduck装配体爆炸图2.png

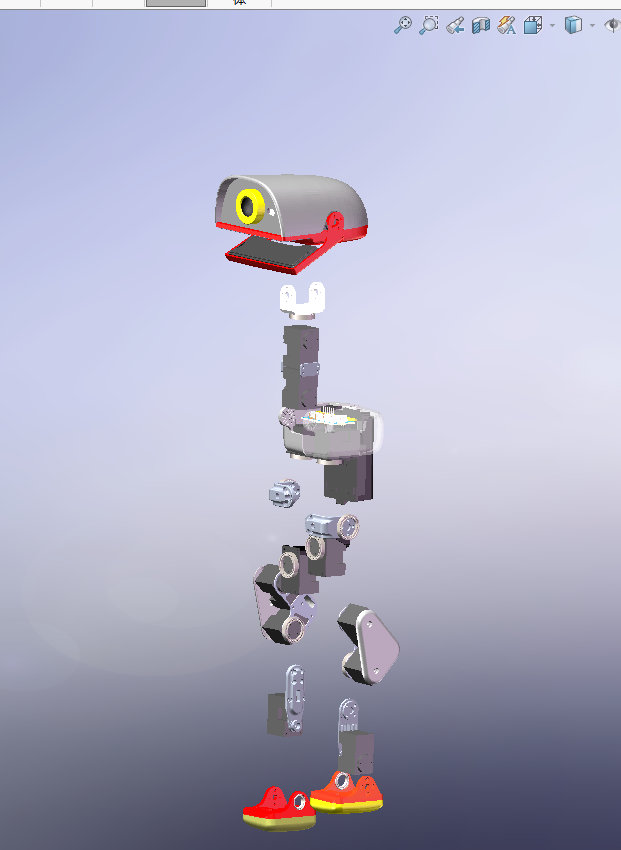
cad-repo/组件图/00-microduck装配体爆炸图2.png
