Nhercar/adaptation-microduck-replica/replica-repo/assembly-drawings/01_正面.png

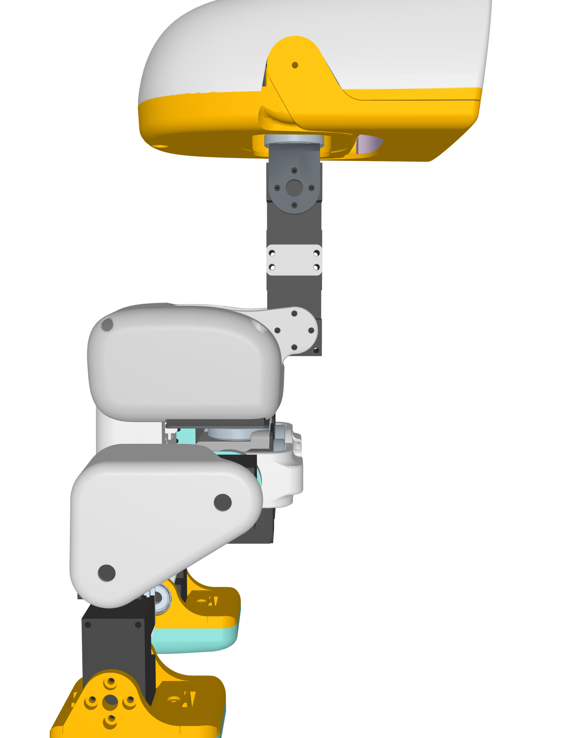
replica-repo/assembly-drawings/01_正面.png
