Nhercar/adaptation-microduck-replica/replica-repo/assembly-drawings/02_侧面.png

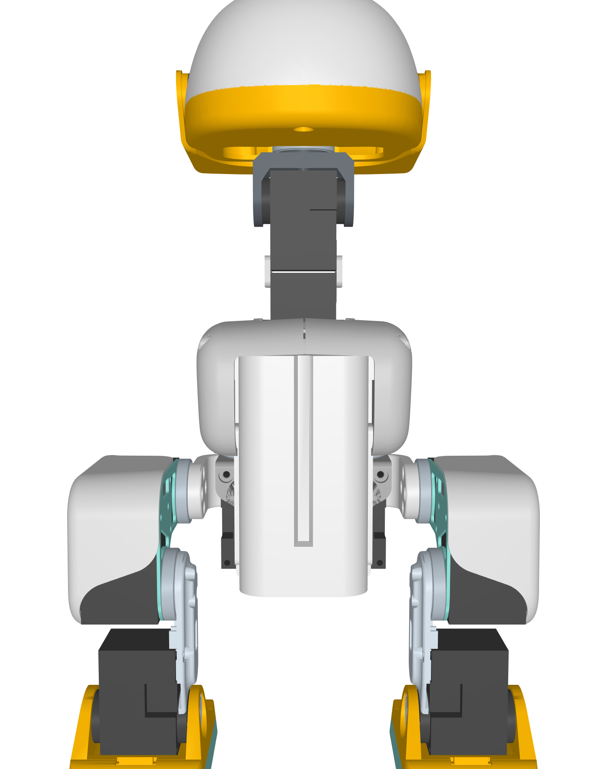
replica-repo/assembly-drawings/02_侧面.png
