Nhercar/adaptation-microduck-replica/replica-repo/assembly-drawings/03_背面.png

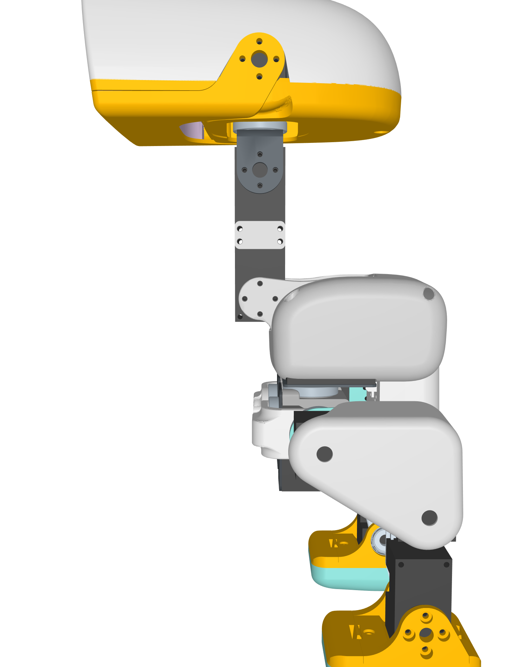
replica-repo/assembly-drawings/03_背面.png
