Nhercar/adaptation-microduck-replica/replica-repo/assembly-drawings/04_四分之三.png

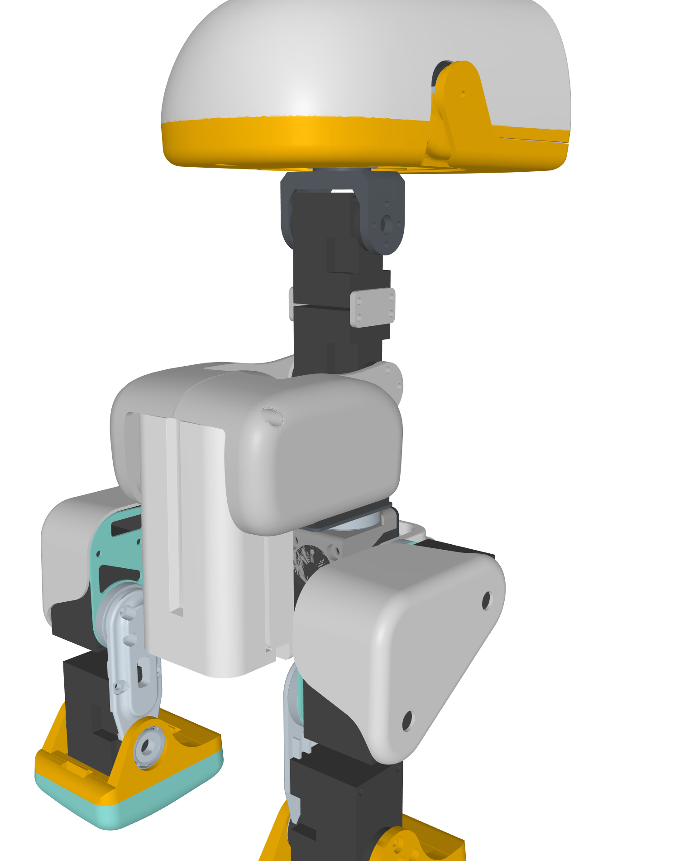
replica-repo/assembly-drawings/04_四分之三.png
