Nhercar/adaptation-microduck-replica/replica-repo/assembly-drawings/05_爆炸图_侧面.png

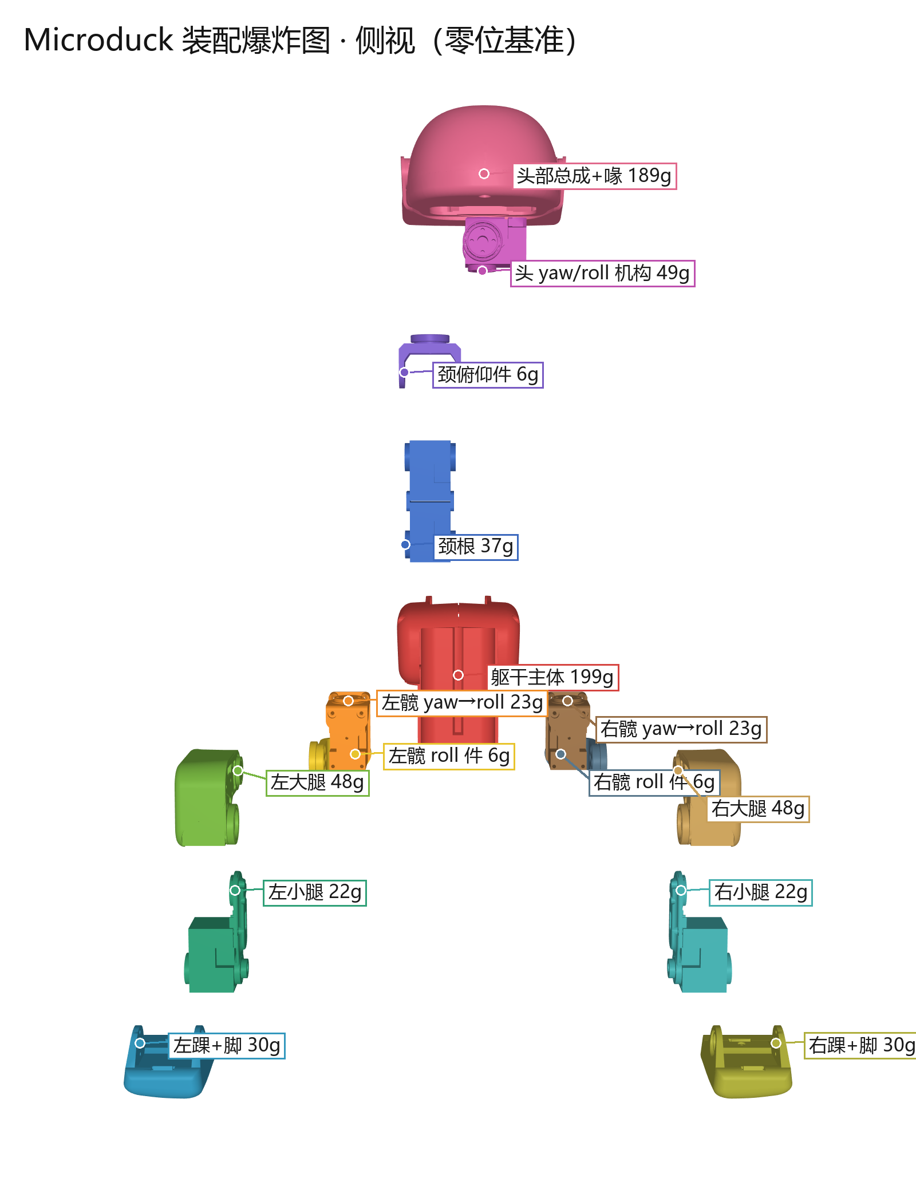
replica-repo/assembly-drawings/05_爆炸图_侧面.png
