Nhercar/adaptation-microduck-replica/replica-repo/assembly-drawings/06_爆炸图_四分之三.png

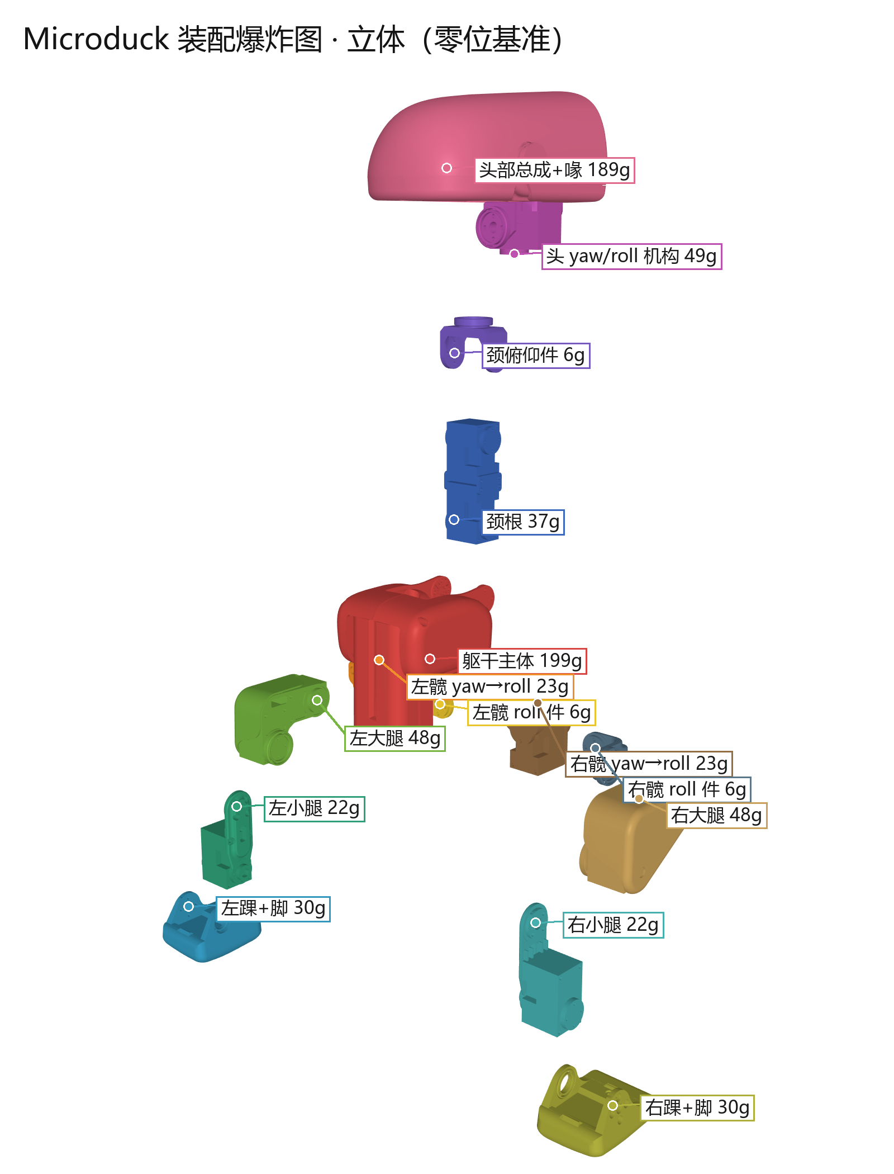
replica-repo/assembly-drawings/06_爆炸图_四分之三.png
