Nhercar/adaptation-microduck-replica/replica-repo/assembly-drawings/07_分色对照_装配态.png

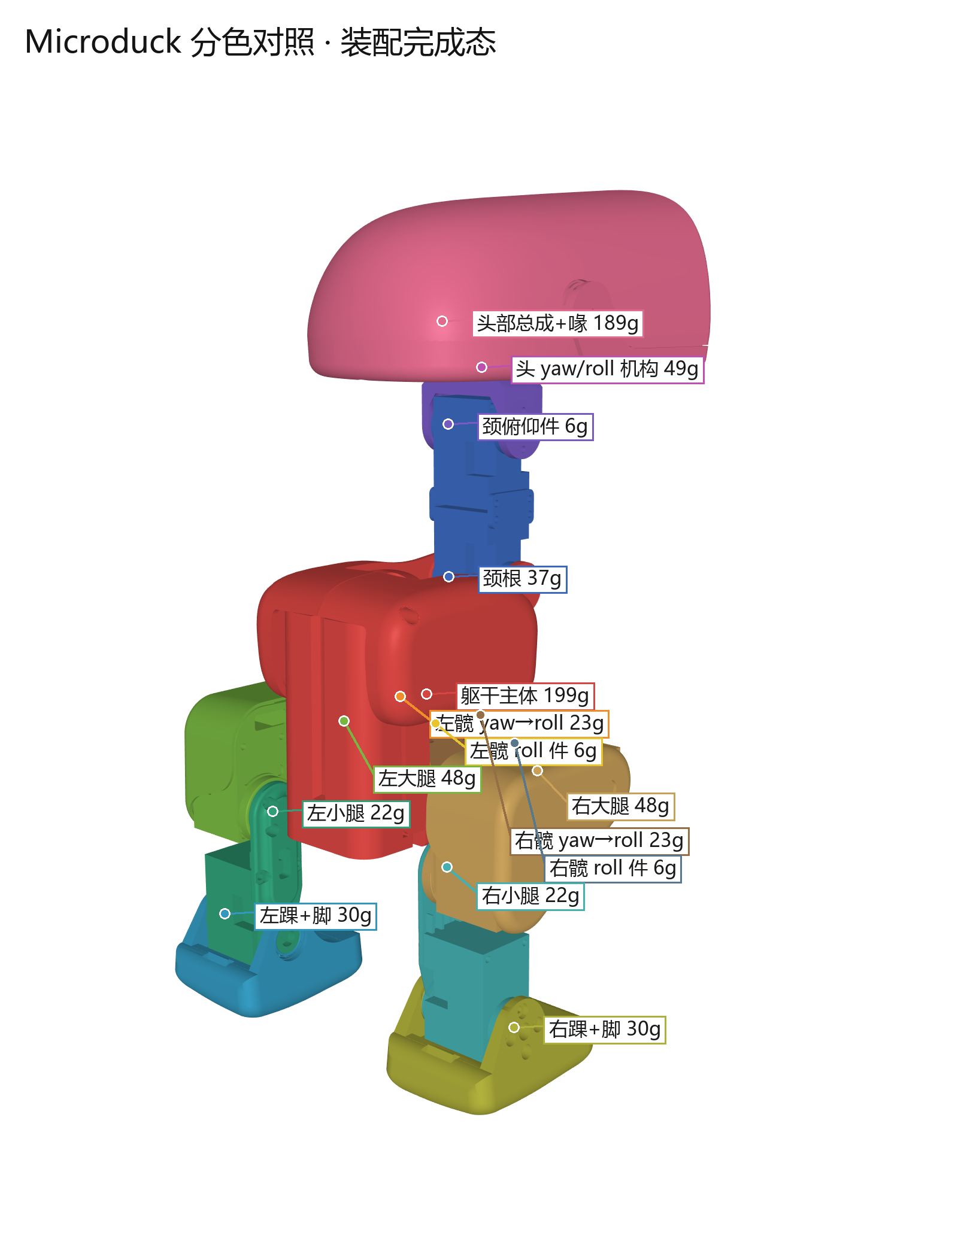
replica-repo/assembly-drawings/07_分色对照_装配态.png
