Nhercar/adaptation-microduck-replica/replica-repo/software/studio/tests/fixtures/battery-20261012-1458.csv

# 来源：health-20261012-145836.csv + run-20261012-145836.jsonl（一号鸭，build_fixture.py 反推）
t | v | cls
0 | 7.611 | rest
1 | 7.581 | rest
2 | 7.608 | rest
3 | 7.608 | rest
4 | 7.618 | rest
5 | 7.629 | rest
6 | 7.631 | rest
7 | 7.613 | rest
8 | 7.613 | rest
9 | 7.613 | rest
10 | 7.633 | rest
11 | 7.615 | rest
12 | 7.605 | rest
13 | 7.604 | rest
14 | 7.623 | rest
15 | 7.614 | rest
16 | 7.614 | rest
17 | 7.614 | rest
18 | 7.614 | rest
19 | 7.614 | rest
20 | 7.614 | rest
21 | 7.614 | rest
22 | 7.624 | rest
23 | 7.615 | rest
24 | 7.635 | rest
25 | 7.607 | rest
26 | 7.616 | rest
27 | 7.626 | rest
28 | 7.617 | rest
29 | 7.617 | rest
30 | 7.627 | rest
31 | 7.628 | rest
32 | 7.619 | rest
33 | 7.609 | rest
34 | 7.628 | rest
35 | 7.619 | rest
36 | 7.619 | rest
37 | 7.619 | rest
38 | 7.619 | rest
39 | 7.619 | rest
40 | 7.599 | rest
41 | 7.617 | rest
42 | 7.617 | rest
43 | 7.627 | rest
44 | 7.618 | rest
45 | 7.628 | rest
46 | 7.619 | rest
47 | 7.589 | rest
48 | 7.606 | rest
49 | 7.615 | rest
50 | 7.605 | rest
51 | 7.614 | rest
52 | 7.614 | rest
53 | 7.614 | rest
54 | 7.604 | rest
55 | 7.623 | rest
56 | 7.614 | rest
57 | 7.614 | rest
58 | 7.614 | rest
59 | 7.614 | rest
60 | 7.614 | rest
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
