Nhercar/adaptation-microduck-replica/replica-repo/hardware/imu_to_dxl/imu_to_dxl-PCB.pdf

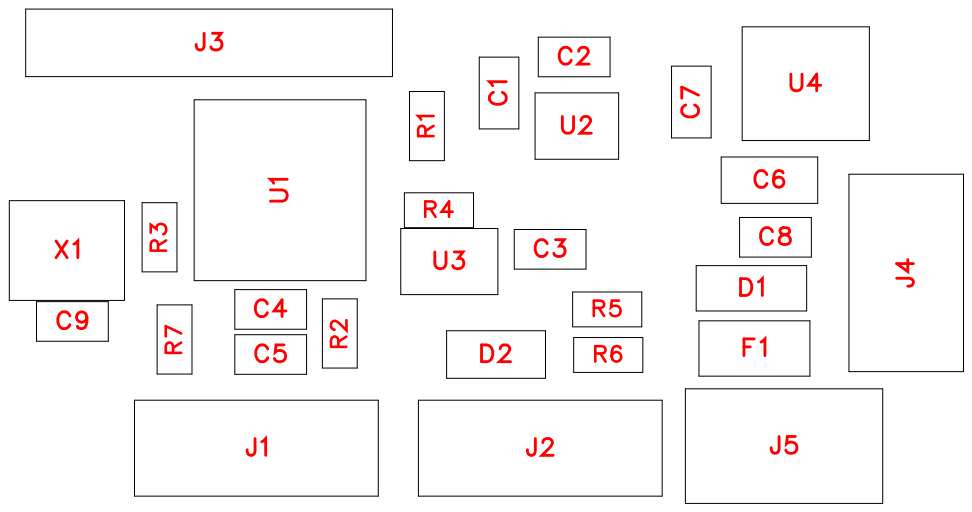
[picture p168: page 1]

No. | Quantity | Comment | Designator | Footprint | Value | Manufacturer Part | Manufacturer | Supplier Part | Supplier
1 | 6 | 100nF | C1,C2,C3,C4,C8,C9 | C0603 | 100nF | CC0603KRX 7R9BB104 | YAGEO(国巨 ) | C14663 | LCSC
2 | 1 | 4.7uF/16V | C5 | C0603 | 4.7uF/16V | CL10A475K O8NNNC | SAMSUNG( ) 三星 | C19666 | LCSC
3 | 1 | 10uF/25V | C6 | C0805 | 10uF/25V | CL21A106KA YNNNE | SAMSUNG( 三星 ) | C15850 | LCSC
4 | 1 | 10uF/10V | C7 | C0603 | 10uF/10V | CL10A106KP 8NNNC | SAMSUNG( 三星 ) | C19702 | LCSC
5 | 1 | SMF12A | D1 | SOD-123FL_ L2.7-W1.8-L S3.7-RD | | SMF12A | GOODWOR K(固得沃克 ) | C2943870 | LCSC
6 | 1 | BZT52C5V1-7-F | D2 | SOD-123_L2 .7-W1.6-LS3. 7-RD | 5V1 | BZT52C5V1-7-F | DIODES( 美 台 ) | C151588 | LCSC
7 | 1 | MF-NSMF02 0X-2 | F1 | F1206 | | MF-NSMF02 0X-2 | BOURNS | C210358 | LCSC
8 | 1 | 舵机总线进 | J1 | CONN-TH_B 3B-EH-A-LF-SN | | B3B-EH-A(L F)(SN) | JST | C160259 | LCSC
9 | 1 | 舵机总出线 | J2 | CONN-TH_B 3B-EH-A-LF-SN | | B3B-EH-A(L F)(SN) | JST | C160259 | LCSC
10 | 1 | PZ254V-11-0 6P | J3 | HDR-TH_6P-P2.54-V-M | | PZ254V-11-0 6P | XFCN(兴飞 ) | C492405 | LCSC
11 | 1 | 飞特总线进 | J4 | CONN-TH_B 3B-PH-K-S | | B3B-PH-K-S( LF)(SN) | JST | C131339 | LCSC
12 | 1 | 飞特总线出 | J5 | CONN-TH_B 3B-PH-K-S | | B3B-PH-K-S( LF)(SN) | JST | C131339 | LCSC
13 | 5 | 10k | R1,R2,R4,R5,R7 | R0603 | 10k | 0603WAF10 02T5E | UNI-ROYAL( 厚声 ) | C25804 | LCSC
14 | 1 | 33R | R3 | R0603 | 33R | 0603WAF33 0JT5E | UNI-ROYAL( ) 厚声 | C23140 | LCSC
15 | 1 | 150R | R6 | R0603 | 150R | 0603WAF15 00T5E | UNI-ROYAL( ) 厚声 | C22808 | LCSC
16 | 1 | STM32G031 F8P6 | U1 | TSSOP-20_L 6.5-W4.4-P0. 65-LS6.4-BL | | STM32G031 F8P6 | ST(意法半导 体) | C529334 | LCSC
17 | 1 | LSM6DSV16 XTR | U2 | LGA-14_L3.0 -W2.5-P0.50-BR | | LSM6DSV16 XTR | ST(意法半导 体) | C5267406 | LCSC
18 | 1 | SN74LVC2G 241DCUR | U3 | VSSOP-8_L2 .3-W2.0-P0.5 0-LS3.1-BR | | SN74LVC2G 241DCUR | TI(德州仪器 ) | C10430 | LCSC
19 | 1 | HT7533-1 | U4 | SOT-89-3_L4 .5-W2.5-P1.5 0-LS4.2-BR | | HT7533-1 | HOLTEK( 合 泰 /盛群 ) | C14289 | LCSC

20

1 | 16MHz | X1 | OSC-SMD_4 P-L3.2-W2.5- BL_SIT8008 BI
16MHz | S3D16.0000
00B20F30T

SCTF(星通时 频)

C387369 LCSC

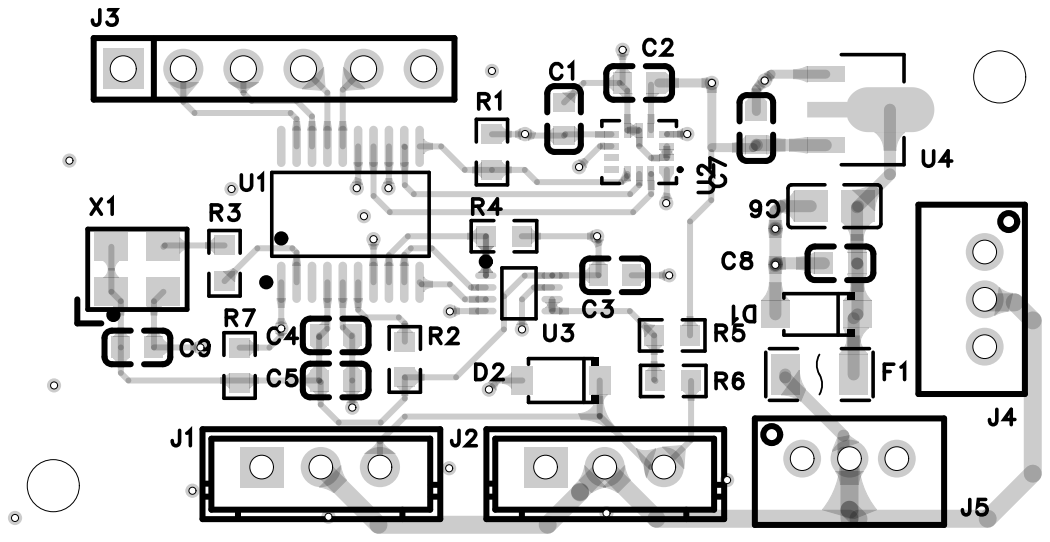
[picture p169: page 5]

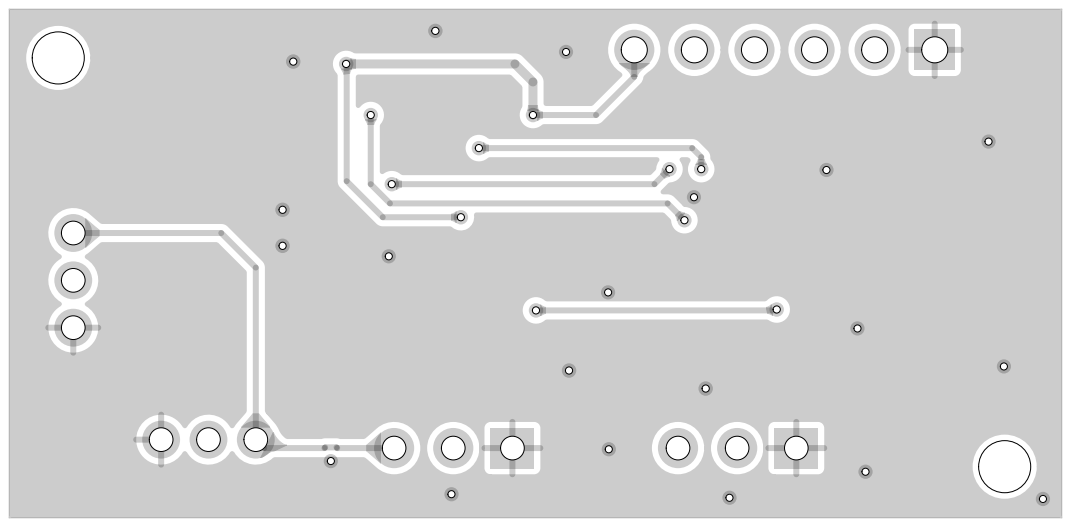
[picture p170: page 6]

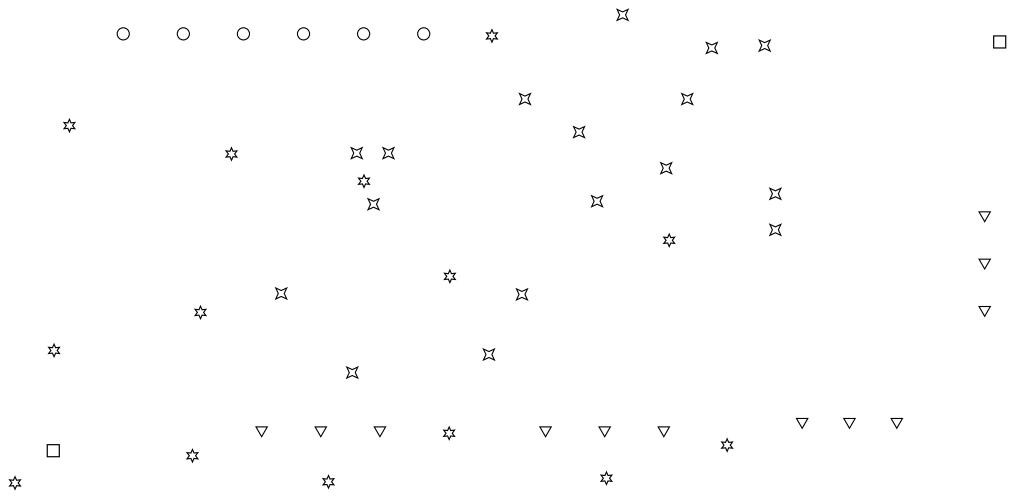
[picture p171: page 7]
